darknet-doll/clown/3d-prints/wrist-splint-mount/concepts/r3-review.html

# splint trace bus r4: tulle sandwich

The trace bus printed as rigid elements ON tulle — fabric is the flex, so the stiff 68D “TPU for AMS” (or PLA) is the right material, and the AMS makes it multicolour. r3 (the all-TPU cutout) kept below for comparison. mm at 100% → at the 77.6% print scale.

rev r4 tulle r3 cutout tulle black white pink

dark field = bare tulle = all the flex. Bundle A now lands ON the patch tile (structure, not just looks). Patch tile: strap slots ×2, eyelets ×4 for a ribbon bow, die-mark diamond; housing straps down through the slots onto its belt loops. Tulle is trimmed at the outline and thumb opening after printing; the dashed edge binding is the printed trim guide.

r3: the same geometry as cutouts in a solid 2.72 plate. Printed 2026-10-15 in 68D — too stiff; needs true TPU 95A. Kept for comparison.

## numbers (100% → 77.6%)

splint footprint | 229.4 × 197.8 → 178.0 × 153.5
r4 element height | 0.4 base + tulle + 1.4 top ≈ 1.8
trace width | 3.0 → 2.3
pad Ø / punched centre | 5.2 / 2.1 → 4.0 / 1.6
patch tile | 53 × 44 → 41.1 × 34.1
patch strap slots (printed size) | 2 × (13 × 2.5)
patch eyelets Ø (printed) | 4 × 3.1
velcro channels take strap | ≤ 15.5 printed (ours: 11)

## print workflow (the reveal)

1. Slice elements only, flat. In Bambu Studio right-click the layer slider at layer 2 → Add Pause.
2. Print the 2 base layers; the printer parks.
3. Lay tulle over the whole plate, pull taut.
4. Pin it with small neodymium magnets to the steel plate, outside the print area, clear of the nozzle path.
5. Resume. The next layer welds through the mesh; remaining layers sandwich the fabric.
6. Cool, peel, trim tulle at the edge binding and inside the thumb opening and strap slots (sharp scissors or a hot knife seals polyester edges).

## supplies

- Tulle: plain polyester tulle, fine mesh, no glitter (glitter blocks the weld; too-fine organza doesn't bond). One bolt is a lifetime supply for this part (~200 × 180 mm per attempt). Amazon search: polyester tulle bolt 54" (https://www.amazon.com/s?k=polyester+tulle+fabric+bolt+54+inch)
- Magnets: neodymium discs, N35 or stronger, ~6×3 mm (the size the prior-art model below calls for), 10–14 pcs. Amazon search: neodymium disc magnets 6×3 mm (https://www.amazon.com/s?k=neodymium+disc+magnets+6mm+x+3mm)
- Already on hand: 68D TPU-for-AMS spool, 11 mm velcro strap, the X1C's magnetic steel plate.

## prior art (verified technique)

- Printables: “Hex pattern for tulle” (https://www.printables.com/model/357819-hex-pattern-for-tulle) — same recipe: pause at height, tulle pinned with 6×3 N35 magnets to a magnetic PEI plate, keep the fabric dead flat.
- Prusa forum: printing over tulle (https://forum.prusa3d.com/forum/original-prusa-i3-mk3s-mk3-how-do-i-print-this-printing-help/printing-over-tulle-fabric) — magnets outside the build area; mesh lets melt flow through and bond mechanically.
- 3DPrinterly: How to 3D print on fabric (8 steps) (https://3dprinterly.com/how-to-3d-print-on-fabric-8-steps/) — the general pause-and-lay workflow, taut fabric, few base layers.

## open before export

- 20-min test square first: traces + one loaded strap tab + a diamond on scrap tulle; yank the tab before trusting a spinning motor to it.
- Tulle bond with 68D TPU at its nozzle temp — prior art is mostly PLA; verify on the test square.
- Flip-for-left-hand check still applies (fabric side vs element side now differ — elements face OUT, tulle sits on skin).
