darknet-doll/clown/3d-prints/bubble-housing/concepts/v1-three-quarter.png

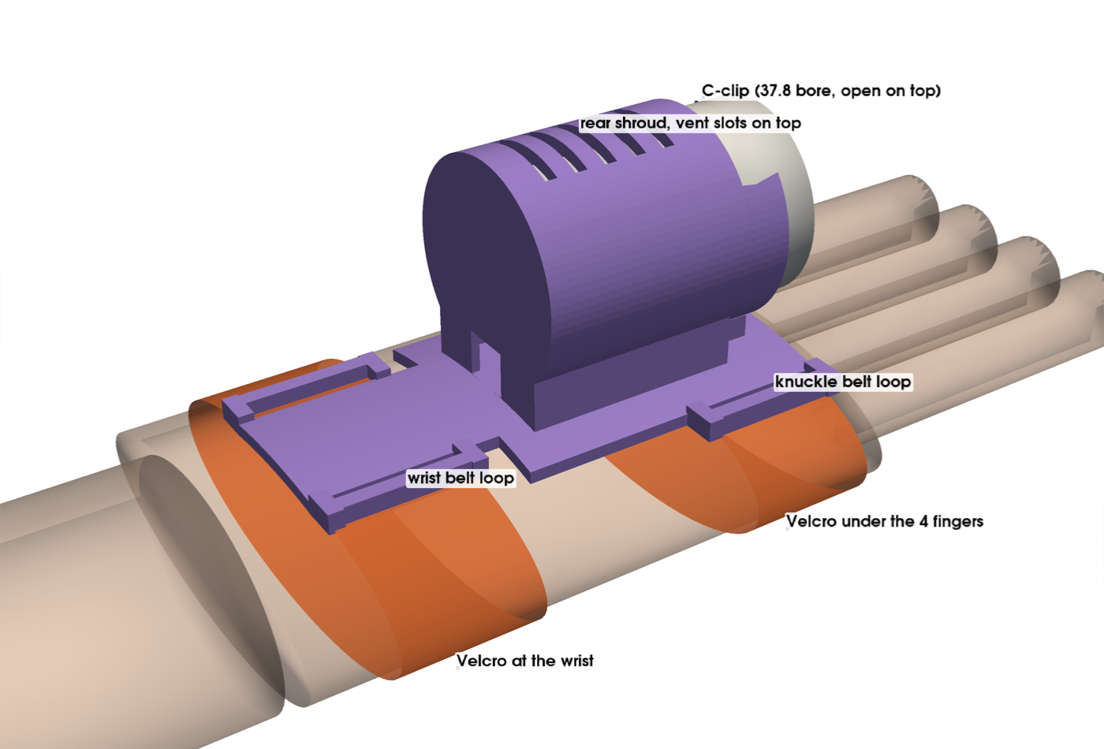
3d-prints/bubble-housing/concepts/v1-three-quarter.png
