darknet-doll/clown/3d-prints/bubble-housing/concepts/v2-side.png

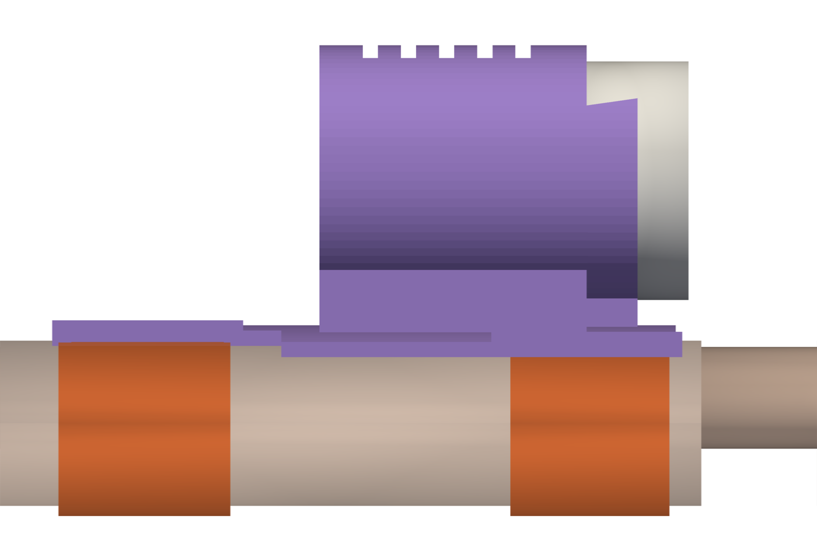
3d-prints/bubble-housing/concepts/v2-side.png
