darknet-doll/clown/3d-prints/bubble-housing/concepts/v3-top.png

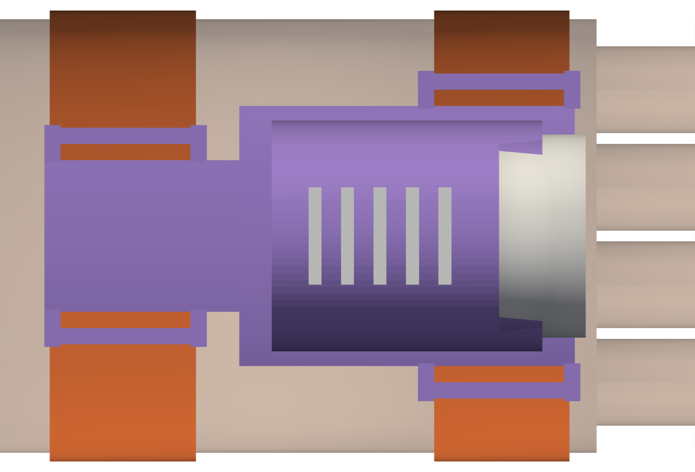
3d-prints/bubble-housing/concepts/v3-top.png
