darknet-doll/clown/3d-prints/bubble-housing/concepts/v4-from-fingers.png

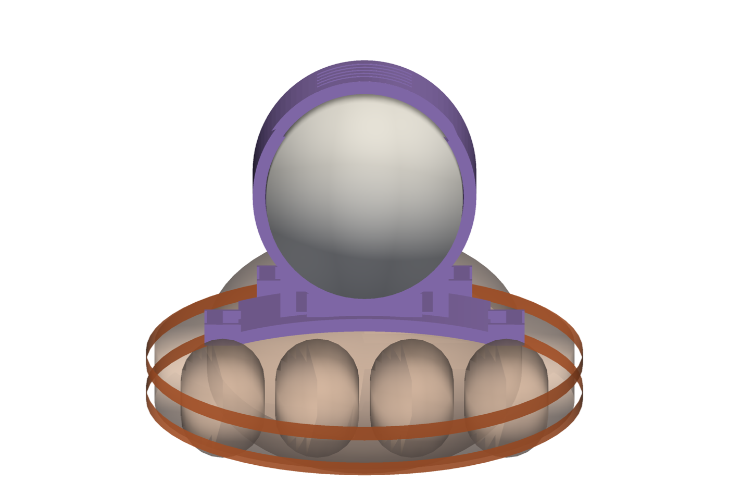
3d-prints/bubble-housing/concepts/v4-from-fingers.png
