darknet-doll/clown/3d-prints/bubble-housing/concepts/v5-rear.png

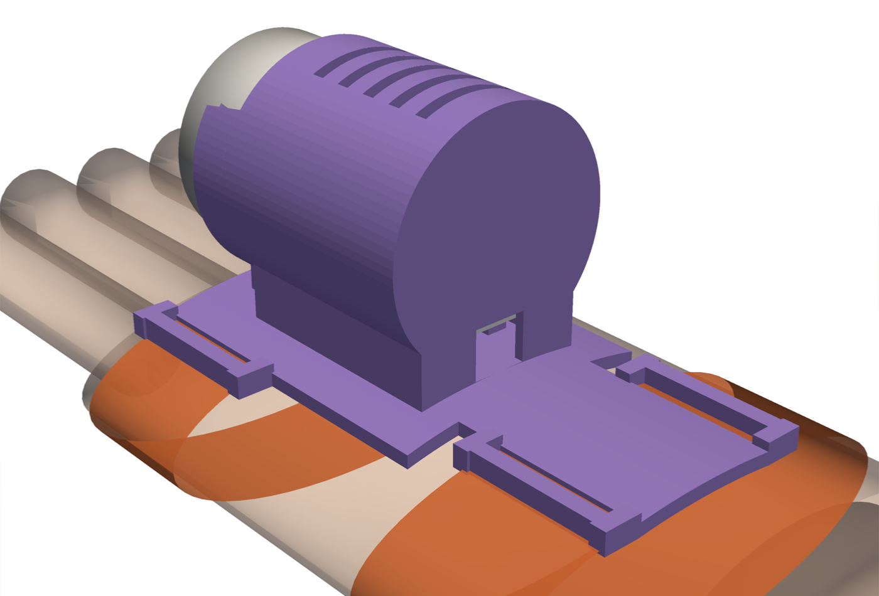
3d-prints/bubble-housing/concepts/v5-rear.png
