darknet-doll/clown/3d-prints/bubble-housing/concepts/w1-three-quarter.png

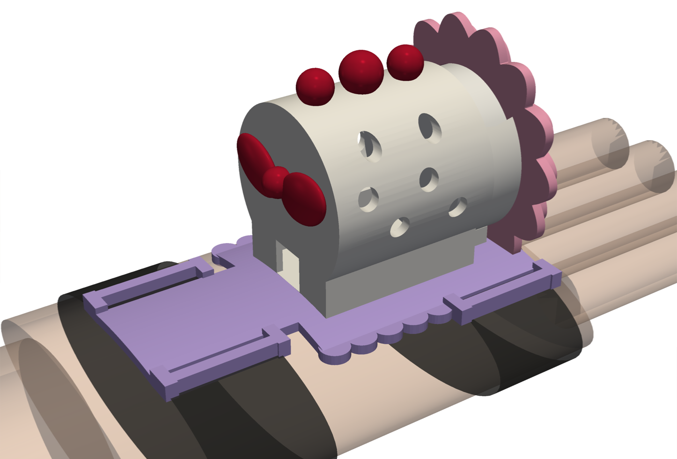
3d-prints/bubble-housing/concepts/w1-three-quarter.png
