darknet-doll/clown/3d-prints/bubble-housing/concepts/w2-front.png

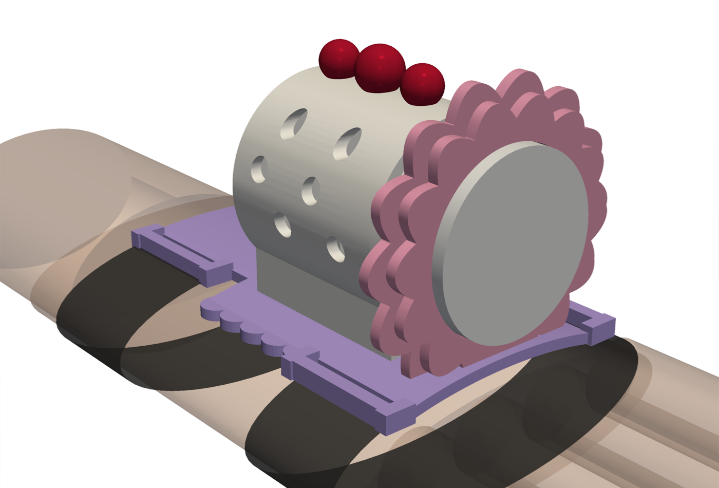
3d-prints/bubble-housing/concepts/w2-front.png
