darknet-doll/clown/3d-prints/bubble-housing/concepts/w3-rear.png

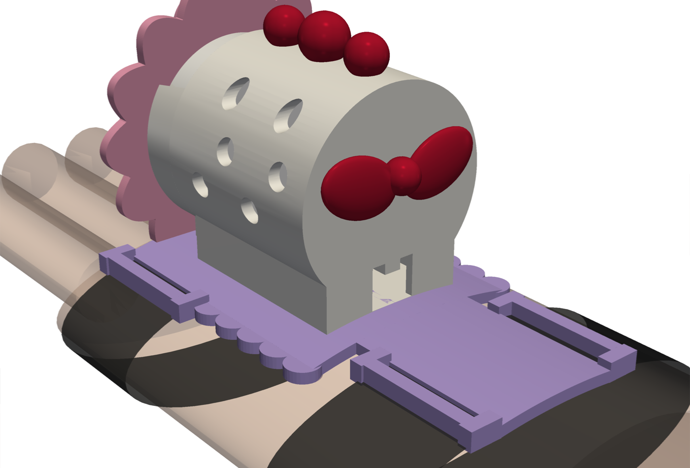
3d-prints/bubble-housing/concepts/w3-rear.png
