darknet-doll/clown/3d-prints/bubble-housing/concepts/w4-side.png

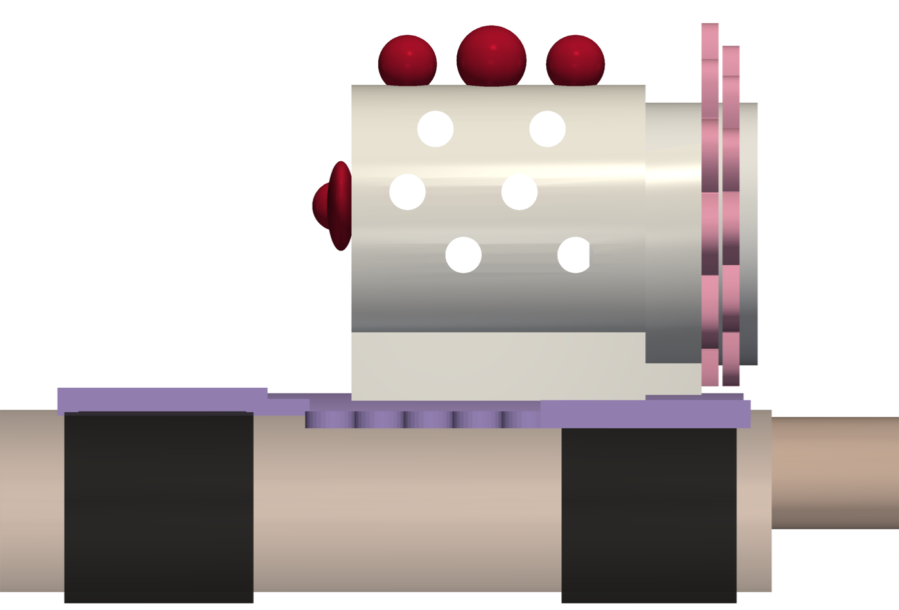
3d-prints/bubble-housing/concepts/w4-side.png
