darknet-doll/clown/3d-prints/cuff-ruffle/concepts/r1-from-wrist.png

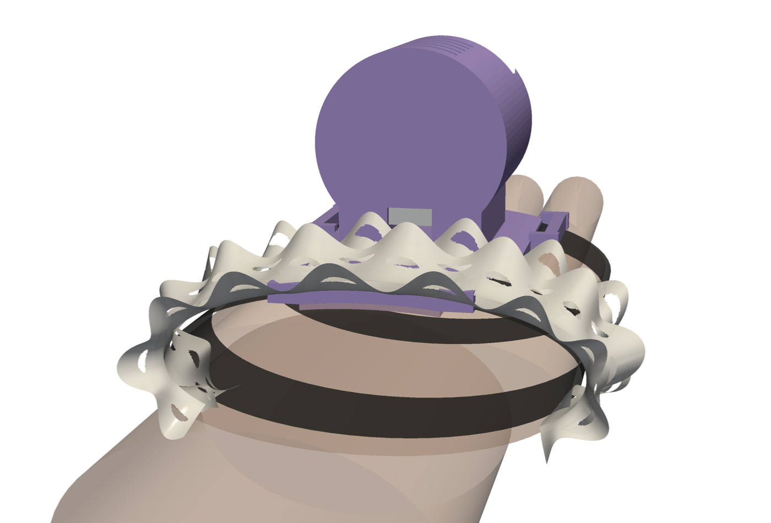
3d-prints/cuff-ruffle/concepts/r1-from-wrist.png
