darknet-doll/clown/3d-prints/cuff-ruffle/concepts/r1-side.png

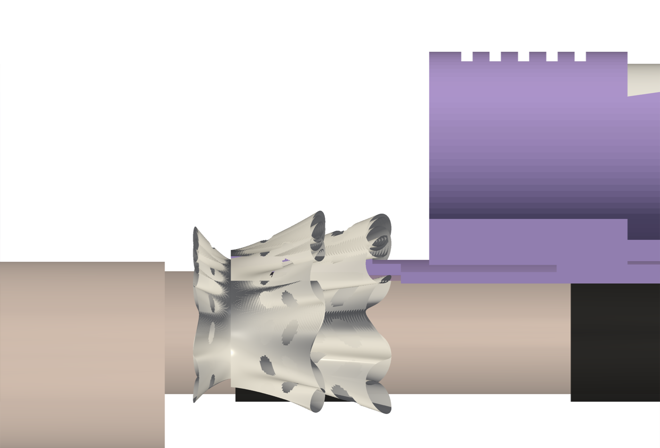
3d-prints/cuff-ruffle/concepts/r1-side.png
