darknet-doll/clown/3d-prints/cuff-ruffle/concepts/r1-three-quarter.png

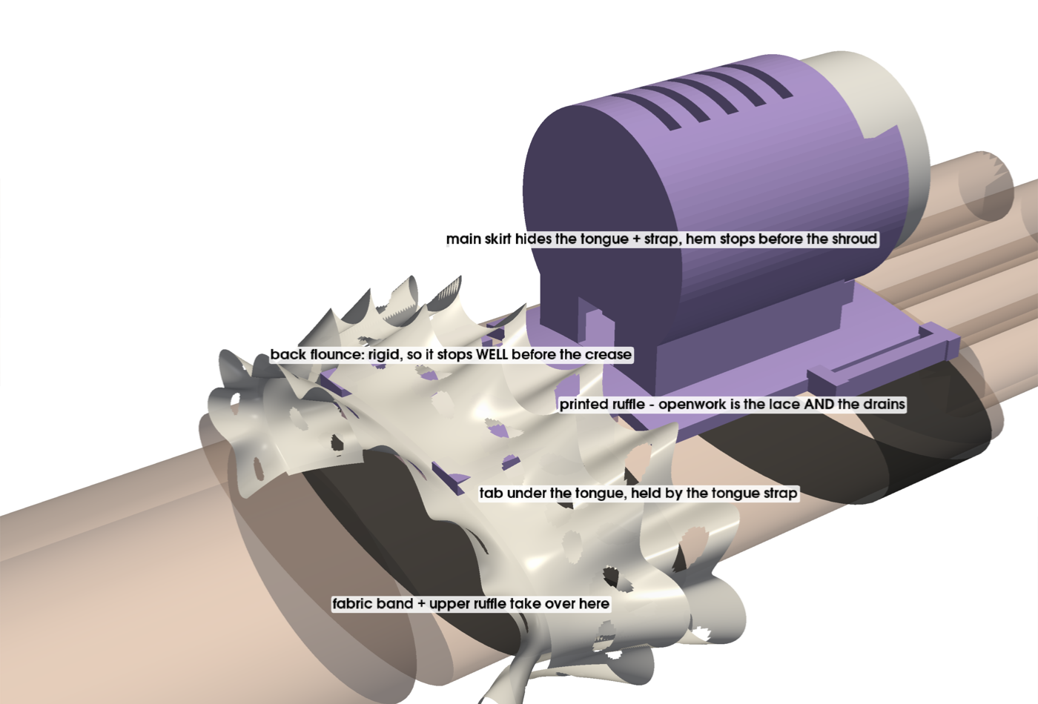
3d-prints/cuff-ruffle/concepts/r1-three-quarter.png
