darknet-doll/clown/3d-prints/cuff-ruffle/concepts/r2-side.png

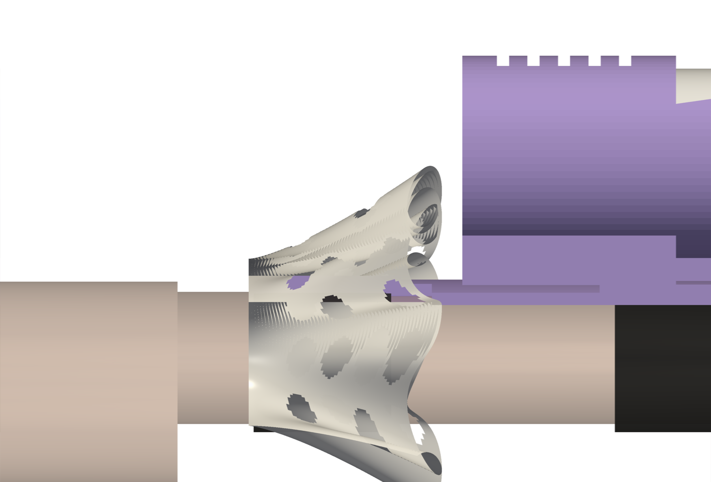
3d-prints/cuff-ruffle/concepts/r2-side.png
