darknet-doll/clown/3d-prints/cuff-ruffle/concepts/r2-three-quarter.png

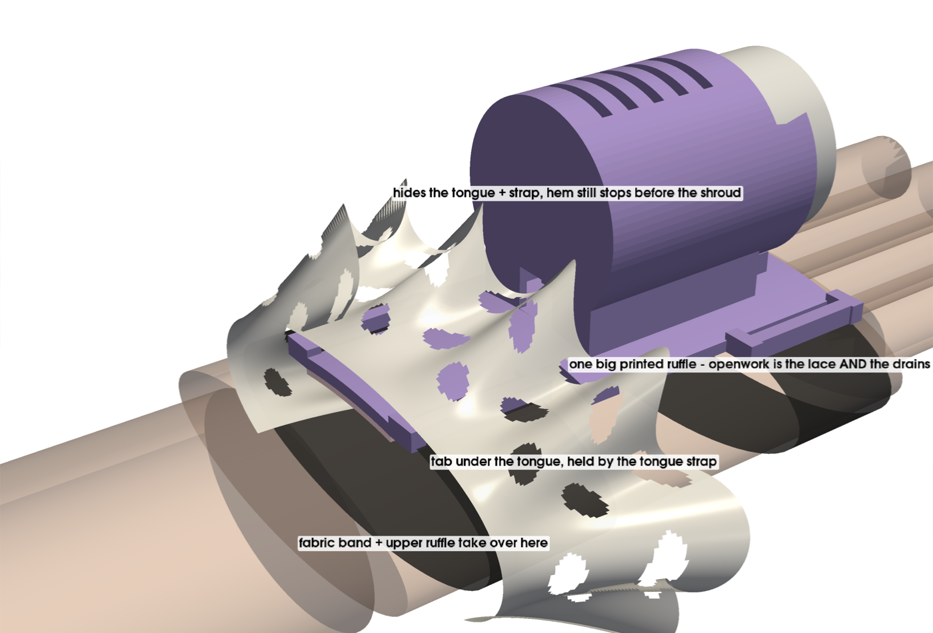
3d-prints/cuff-ruffle/concepts/r2-three-quarter.png
