darknet-doll/clown/3d-prints/wrist-splint-mount/concepts/openwork-swatches-r1.png

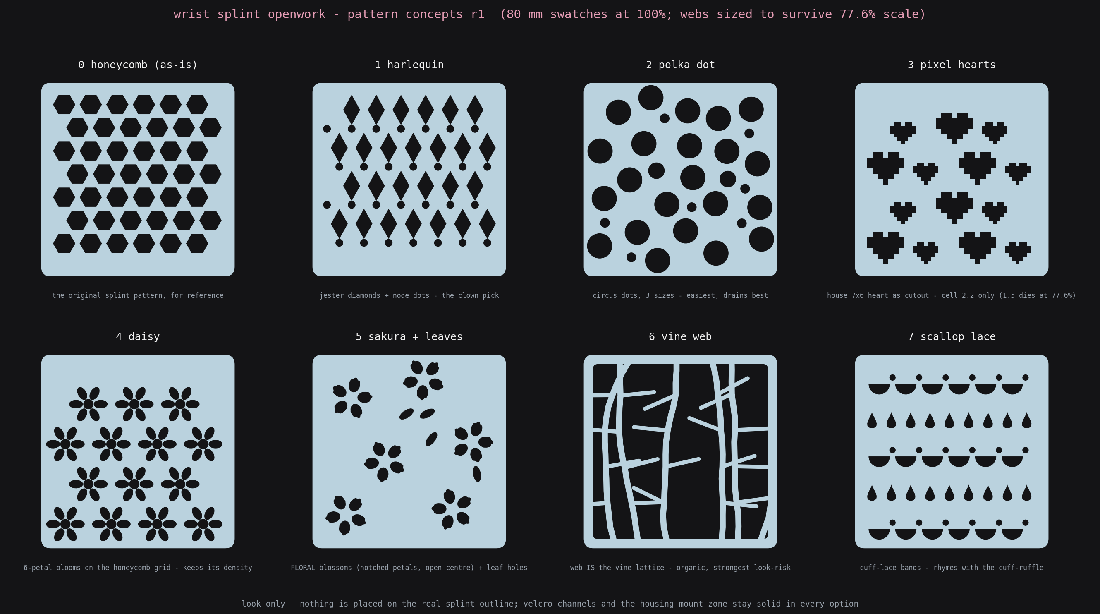
3d-prints/wrist-splint-mount/concepts/openwork-swatches-r1.png
