darknet-doll/clown/3d-prints/wrist-splint-mount/concepts/openwork-swatches-r2.png

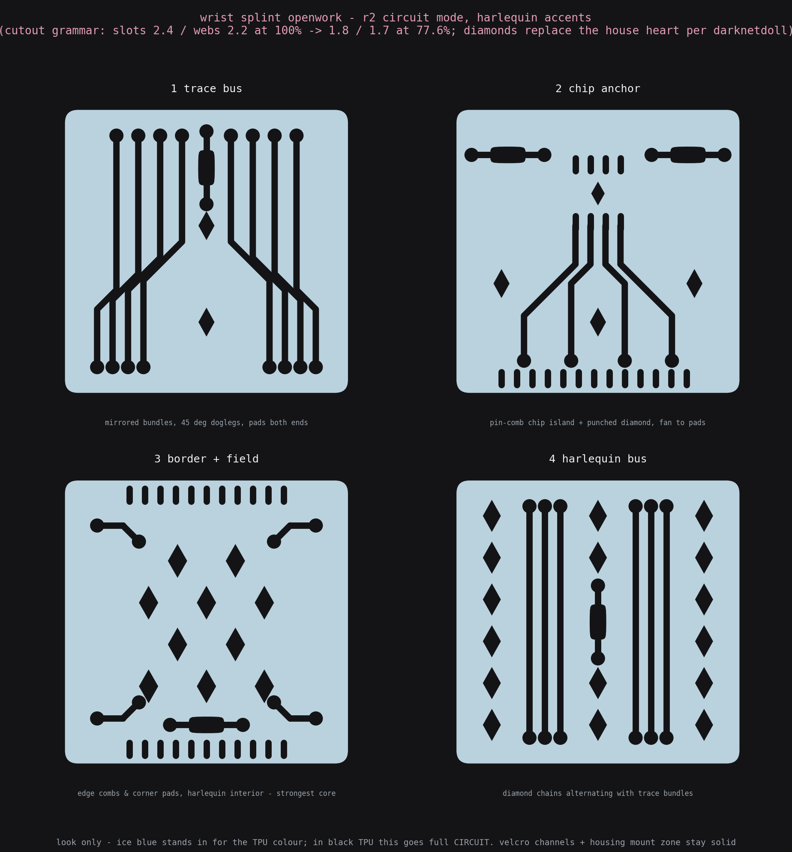
3d-prints/wrist-splint-mount/concepts/openwork-swatches-r2.png
