darknet-doll/clown/3d-prints/wrist-splint-mount/concepts/splint-plan.png

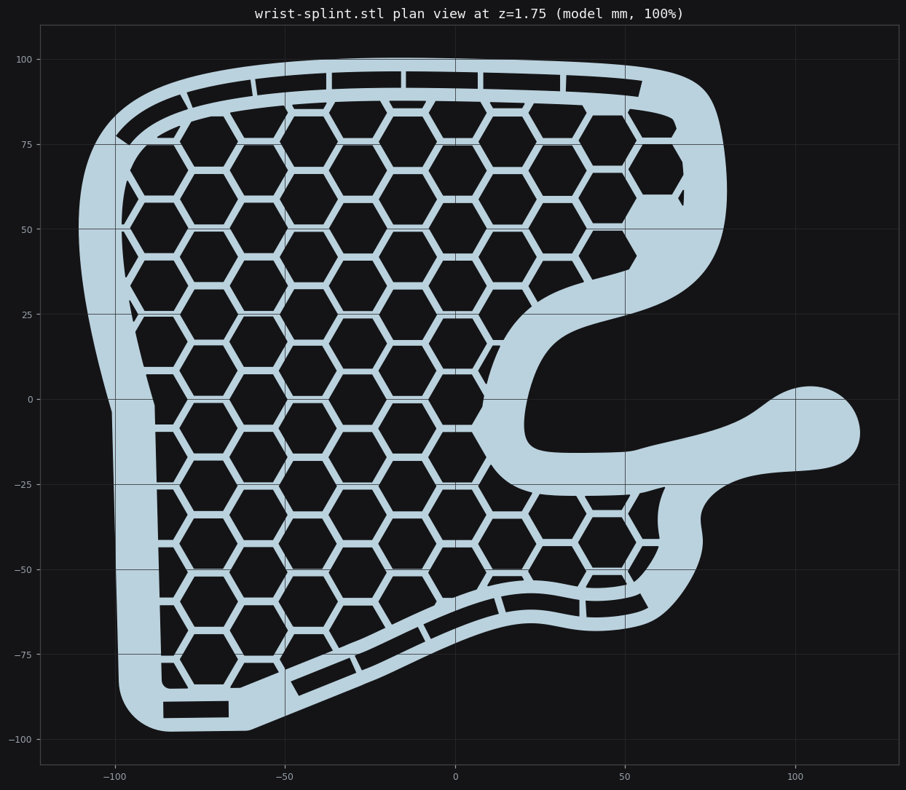
3d-prints/wrist-splint-mount/concepts/splint-plan.png
