darknet-doll/clown/3d-prints/wrist-splint-mount/concepts/trace-bus-r3.png

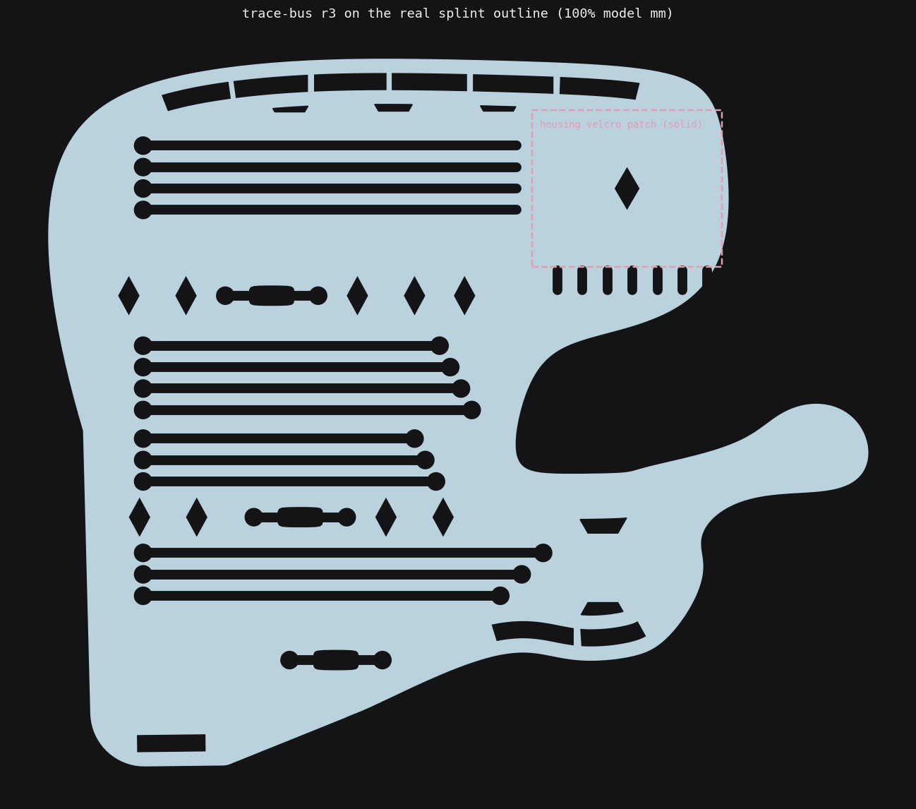
3d-prints/wrist-splint-mount/concepts/trace-bus-r3.png
