darknet-doll/clown/3d-prints/wrist-splint-mount/concepts/tulle-sandwich-r4.png

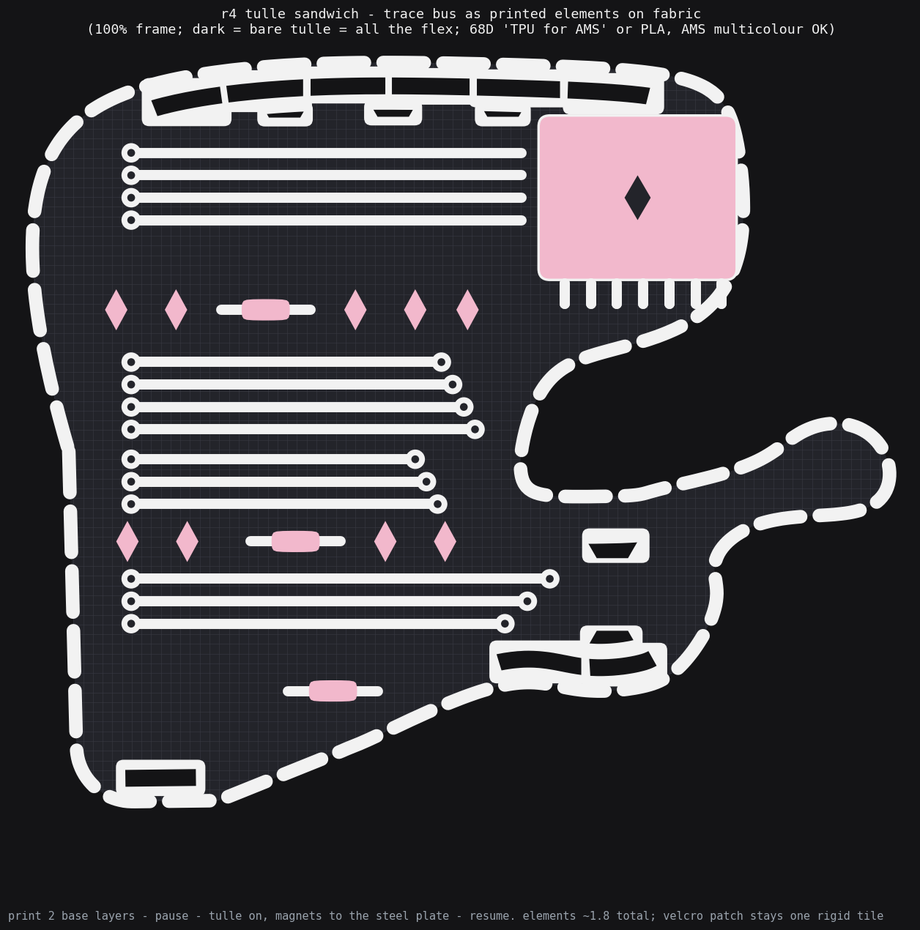
3d-prints/wrist-splint-mount/concepts/tulle-sandwich-r4.png
