darknet-doll/clown/docs/pcb/fab/clown-pod-bottom.png

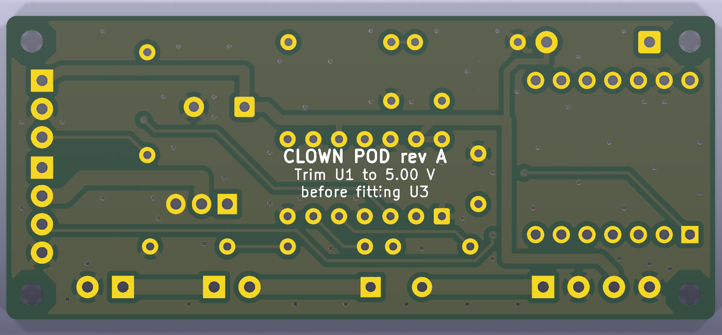
docs/pcb/fab/clown-pod-bottom.png
