darknet-doll/clown/firmware/trigger_test/xiao-pinout.png

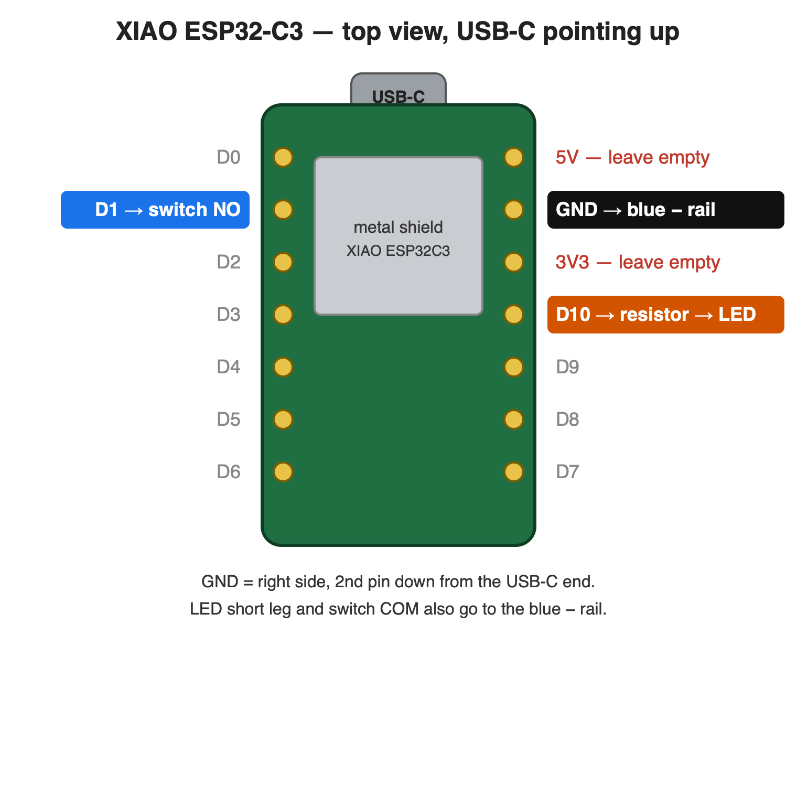
firmware/trigger_test/xiao-pinout.png
