darknet-doll/clown/PARTS.md

# Parts List

## How to read the quantities

Every part below carries **two numbers** and a **status**:

- **Per arm** — what one arm needs
- **Buy** — what to actually put in the basket for the whole costume
- **Status** — whether it's already on the shelf, deferred, or dropped;
  see [What's already on hand](#whats-already-on-hand)

They are different, and confusing them is the single easiest way to end up
halfway through a build with one glove. **The costume is two arms.** Tools are
marked `buy 1` because you only need one soldering iron, not one per arm.

Format for each part:

- **Is** — what the object actually is
- **Does** — its job in the circuit
- **Skip it →** the exact way it breaks

Read order if you're new:

1. This file — what the parts are
2. [BUILD.md](BUILD.md) — how they go together
3. [SCHEMATIC.md](SCHEMATIC.md) — the same circuit as a drawing, with every
   designator (`CR2`, `R5`, `SW1`…) this file refers to, and the
   [naming rules](SCHEMATIC.md#naming-rules) that keep those names unique
4. [README.md](README.md) — why the design is shaped this way

---

## About the buy links

Each part below has a **Suggested product** line pointing at a real Amazon listing.

- **What I checked:** the listing exists and its spec matches what this build needs
- **What I could not check:** price, current stock, and whether it ships to Bothell
  - Amazon serves automated requests a page with no price, stock or delivery data,
    and a delivery estimate needs a signed-in session with your address set
  - **Confirm all three in your cart before ordering.** Treat these as "this is the
    right part," not "this is in stock today"
- Where the part is a pure commodity and brand genuinely doesn't matter, the link is
  a search rather than one listing
- **The garment and fabric links are all searches, on purpose.** Listings for lace
  gloves and arm warmers churn constantly, and the thing that decides whether one
  works — how much light its fabric passes — is not visible in a listing photo. Buy
  one pair, test it lit, *then* buy the rest
- The bubble kit is **not on Amazon** — it comes from Bambu's own store

---

## What's already on hand

Counted 2026-09-23. The shopping list below carries the same status per row, so
you can shop from the table without re-reading this.

### On the shelf — do not re-buy

- **Bambu bubble maker kit ×2** — one per arm, so everything in the boxes is covered too
- **1000 µF 16 V electrolytic ×2**
- **100 kΩ resistor ×4** — two per arm, the battery monitor divider
- **330–470 Ω resistor ×2**
- **Small protoboard ×2**
- **Lever microswitch ×2** — *came in the kits*, one per kit
- **Protected 18650 ×2** — one per kit, already on its PH2.0 pigtail

**Where the shelf stock came from is not recorded.** The caps, resistors and
protoboard were already here. Everything with a traceable listing and an arrival date
is in the [shopping list](#shopping-list) — one table, so there is no second place to
keep in sync.

### Deciding later — the costume layer

- **Glove** — fingerless, pale, thin
- **Sleeve or arm warmer** — or one elbow-to-hand piece covering both
- **Diffuser layer** — also what backs the lace structurally
- **Satin ribbon** — thumb loops, the wrist placket, *and* the cable tacking either
  side of every plug ([BUILD.md](BUILD.md) step 10 — the connector is never the
  anchor). This one is strain relief, not decoration

None of these are electrical and none of them gate the build: the circuit can be
finished, sealed and bench-tested before any of them is chosen. Two things to carry
forward when you do decide:

- **Buy one, test it lit, then buy the rest.** How much light a fabric passes is the
  whole decision, and no listing photo tells you
- **Decide them together.** Glove, sleeve and diffuser share one fabric rule, and the
  sleeve choice decides whether the wrist plug stays reachable

### Dropped — and what that costs

- **Spare 18650 cells** — two arrive in the kits, no more being bought
  - **The cost:** a flat cell ends the performance. There is no swap
  - Charge both to full the morning of, and know your runtime from
    [BUILD.md](BUILD.md)'s bench test
- **18650 sled / holder with leads** — the kit's cell is already on a PH2.0 pigtail
  that mates to both the pod and the charger, so no sled sits in the path
  - **Keep the kit's PH2.0 lead on the cell.** That pigtail *is* the swap-and-charge
    path — cut it off and you need a soldering iron to change a battery
  - The sled section below stays as the fallback if a pigtail ever gets damaged
- **18650 transport case** — nothing loose to carry, because no spares
  - If that changes, the case comes back. A bare cell's whole can is the negative
    terminal and the shrink wrap is its only insulation

---

## Shopping list

Everything, in one table. Details and reasoning are in the sections below; the
buy links are the same ones repeated there, so you can shop straight from here.
**Price, stock and delivery are unverified — confirm in your cart.**

Status column: **have** = was on the shelf before this build, provenance not
recorded · **bought** = ordered for this build, with the listing and arrival date in
the last column · `later` = costume layer, deferred · ~~skip~~ = dropped on purpose,
reason in [What's already on hand](#whats-already-on-hand) · `buy` = still to order.
**Every `buy` row is what's actually left.**

**Received** is its own column: a date means it is physically here, **—** means it was
never ordered, and ⚠ means ordered but not arrived. The last column reads **Bought**
first — the listing actually ordered — then **Recommended** underneath, the
spec-matched suggestion this file made before anything was ordered. Where the two
differ, the difference is the thing to read.

| Part | Status | Per arm | **Buy** | Received | Bought / Recommended |
|---|---|---|---|---|---|
| Bambu Electric Bubble Maker Kit 01 | **have** | 1 | **0** — both on hand | **09-23** | **Bought:** [Bambu store](https://us.store.bambulab.com/products/electric-bubble-maker-kit-01) ×2<br>Recommended: the same, it is the only seller |
| Bottle, 24T or 30T neck | buy | 1 | **2** + a spare | — | Recommended: [search](https://www.amazon.com/s?k=24-410+30-410+plastic+bottle+with+cap) |
| Silicone tube, 3 × 5 mm | buy | — | **1 m** | — | Recommended: [search](https://www.amazon.com/s?k=silicone+tubing+3mm+ID+5mm+OD) |
| Bubble solution | **bought** | — | **0** — in hand | **09-29** | **Bought:** [32 oz concentrate](https://www.amazon.com/dp/B08XY8WP6B) — makes 2.5 gal diluted<br>Recommended: [search](https://www.amazon.com/s?k=bubble+solution+refill+gallon) |
| WS2812B strip, 60/m, 5V, IP65, black PCB | **bought** | 0.5 m | **0** — 5 m in hand | **09-29** | **Bought:** [WESIRI 5 m / 300 LED / IP67](https://www.amazon.com/dp/B07P7WWRVH) — 60/m ✓, IP67 ✓, **PCB colour unstated: check the roll**<br>Recommended: [Luopan, 1 m](https://www.amazon.com/WS2812B-pixels-WS2812-Decorative-Lighting/dp/B0CG5V735Q) |
| Glove — pale, thin, fingerless | later | 1 | **a pair** | — | Recommended: [sheer lace](https://www.amazon.com/s?k=white+lace+long+fingerless+gloves+arm+warmers) · [ribbon lace-up](https://www.amazon.com/s?k=lace+up+ribbon+knit+arm+warmers+fingerless+white) |
| Sleeve or arm warmer | later | 1 | **a pair** (one elbow-to-hand piece covers both) | — | Recommended: [search](https://www.amazon.com/s?k=long+white+lace+arm+warmers+fingerless) |
| Diffuser layer — white organza or tulle | later | — | **½ yd** | — | Recommended: [organza](https://www.amazon.com/s?k=white+organza+fabric+by+the+yard) · [tulle](https://www.amazon.com/s?k=white+tulle+fabric+bolt) · [channel](https://www.amazon.com/s?k=silicone+LED+diffuser+channel+10mm+flexible) |
| Satin ribbon, 6–10 mm | later | — | **1 roll** | — | Recommended: [search](https://www.amazon.com/s?k=white+satin+ribbon+6mm) |
| Seeed XIAO ESP32-C3 | **bought** | 1 | **0** — 4 in hand | **09-29** | **Bought:** [3-pack](https://www.amazon.com/dp/B0DGX3LSC7) **+** [1 pre-soldered](https://www.amazon.com/dp/B0DRNSV5CS) — pre-soldered one sits taller, check pod fit<br>Recommended: [Seeed 3-pack](https://www.amazon.com/XIAO-ESP32C3-3PCS-Pack-Bluetooth5-0/dp/B0DGX3LSC7) |
| 74AHCT125 level shifter | **bought** | 1 | **0** — 5 in hand | **10-02** | **Bought:** [Juried DIP-14 5-pack](https://www.amazon.com/dp/B08FHD994N) — 5 in hand, logged from the inventory check — **arrival date not recorded, 10-02 is the day it was counted**<br>Recommended: [the same DIP 5-pack](https://www.amazon.com/Juried-Engineering-SN74AHCT125N-SN74AHCT125-Breadboard-Friendly/dp/B08FHD994N) · [Adafruit](https://www.amazon.com/Adafruit-Accessories-Quad-Level-Shifter-piece/dp/B00XW2L39K) |
| MOSFET, bare RFP30N06LE | **bought** | 1 | **0** — 6 in hand | **09-29** | **Bought:** [Cylewet 6-pack](https://www.amazon.com/dp/B073D399M1) — bare parts, so **5 V gate drive is required** and `R4`/`R5` are not included<br>Recommended: the same listing |
| 1N5819 diode | **bought** | 2 | **0** — 150 in hand | **09-29** | **Bought:** [EEEEE 150-pack](https://www.amazon.com/dp/B0FC2CWKPL) — 1 A / 40 V<br>Recommended: [search](https://www.amazon.com/s?k=1N5819+schottky+diode) |
| Battery disconnect switch, 3 A DC | **bought** | 1 | **0** — 5-pack ordered | ⚠ **no** — ordered 10-08 | **Bought:** [DaierTek KCD1 round rocker, 20 mm, SPST, 5-pack](https://www.amazon.com/dp/B07S1MV462) — 12 VDC automotive, **confirm the DC amp rating printed on the body ≥ 3 A**; a rocker, **not booted** — seal the 20 mm snap-in hole with RTV and label which way is off<br>Recommended: [search booted SPST toggle](https://www.amazon.com/s?k=waterproof+toggle+switch+boot+SPST+12V) |
| Protected 18650 cell | **have** | 1 | **0** — 2 come in the kits | **09-23** | **Bought:** inside the [kits](https://us.store.bambulab.com/products/electric-bubble-maker-kit-01)<br>Recommended, only for spares: [search](https://www.amazon.com/s?k=protected+18650+battery+button+top) |
| 18650 sled with leads | ~~skip~~ | — | **0** — kit cell is on a pigtail | — | Recommended: [search](https://www.amazon.com/s?k=18650+battery+holder+single+slot+wire+leads) |
| 5V boost module | **bought** | 1 | **0** — 10 in hand | **09-29** | **Bought:** [Dorhea MT3608 10-pack](https://www.amazon.com/dp/B089JYBF25) — **trim to 5.0 V and meter it before any XIAO**<br>Recommended: [a different MT3608 10-pack](https://www.amazon.com/MT3608-Converter-Adjustable-Voltage-Regulator/dp/B0BGLGL9RV) — same chip |
| 2A polyfuse | **bought** | 1 | **0** — kit in hand | **09-29** | **Bought:** [GBX radial PPTC assortment, 50 pc](https://www.amazon.com/dp/B0F19BP842) — **no 2.0 A part exists in this family; fit GBX-185 (1.85 A) or GBX-250 (2.5 A)**<br>Recommended: [search](https://www.amazon.com/s?k=PPTC+resettable+fuse+2A+radial) |
| 18650 storage/transport case | ~~skip~~ | — | **0** — no spares to carry | — | Recommended: [search](https://www.amazon.com/s?k=18650+battery+storage+case+plastic) |
| 100 kΩ resistor | **have** | 2 | **0** — 4 on hand | on shelf | Already on the shelf — **not bought for this build, provenance not recorded**<br>Recommended, to re-buy: [resistor kit](https://www.amazon.com/s?k=metal+film+resistor+assortment+kit+1%2F4W) |
| 1000 µF capacitor | **have** | 1 | **0** — 2 on hand, plus 10 more in the 24-value electrolytic kit | on shelf | Already on the shelf — **not bought for this build, provenance not recorded**<br>Recommended, to re-buy: [search](https://www.amazon.com/s?k=1000uF+16V+electrolytic+capacitor) |
| 0.1 µF ceramic capacitor | **bought** | 1 | **0** — ordered, 30 in the kit | ⚠ **no** — due 10-03 | **Bought:** [BOJACK 300-pc ceramic kit](https://www.amazon.com/dp/B085RDTCCV) — 10 values, **0.1 µF (marked 104) ×30**; **not here yet**, and it gates the 74AHCT125 wiring<br>Recommended: [ceramic cap kit](https://www.amazon.com/s?k=ceramic+capacitor+assortment+kit+0.1uF+50V) · [0.1 µF 50-pack](https://www.amazon.com/s?k=0.1uF+100nF+50V+ceramic+capacitor+through+hole) |
| 330–470 Ω resistor | **have** | 1 | **0** — 2 on hand | on shelf | Already on the shelf — **not bought for this build, provenance not recorded**<br>Recommended, to re-buy: [same resistor kit](https://www.amazon.com/s?k=metal+film+resistor+assortment+kit+1%2F4W) |
| 100 Ω gate series (`R4`) + 10 kΩ gate pulldown (`R5`) | **have** | 1 each | **0** — 50 of each in the kit | on shelf | Already on hand in the **AUSTOR 1/4 W 1 % metal film kit** (50 pc each of 100 Ω and 10 kΩ; also 330 Ω, 470 Ω, 100 kΩ at 25 pc) — checked against the listing photo, **not bought for this build, provenance not recorded**<br>Recommended, to re-buy: [1/4W metal film resistor kit](https://www.amazon.com/s?k=metal+film+resistor+assortment+kit+1%2F4W) |
| Lever microswitch | **have** | 1 | **0** — 2 come in the kits | **09-23** | **Bought:** inside the [kits](https://us.store.bambulab.com/products/electric-bubble-maker-kit-01)<br>Recommended, only for spares: [Saim 10-pack](https://www.amazon.com/Saim-Momentary-Switch-Roller-Action/dp/B01NBK00FD) |
| JST-SM pigtail pair, 3-pin | buy | 3 | **6 + 2 spares** | — | Recommended: [search](https://www.amazon.com/s?k=JST+SM+3+pin+pigtail+pairs) — check the strip reel first, it may already carry some |
| JST-SM pigtail pair, 4-pin | buy | 2 | **4 + 2 spares** | — | Recommended: [search](https://www.amazon.com/s?k=JST+SM+4+pin+pigtail+pairs) |
| JST-SM pigtail pair, 5-pin | ~~skip~~ | — | **0** — design change: the wrist now crosses on SM-3 + SM-4 | — | Recommended, no longer needed: [BTF-LIGHTING, 10 pairs](https://www.amazon.com/BTF-LIGHTING-Pairs-Female-Connector-Flexible/dp/B01DC0KNY2) |
| JST-SM pigtail pair, 2-pin | buy | 1 | **2 + 2 spares** | — | Recommended: [VANDESAIL, 20 pairs](https://www.amazon.com/VANDESAIL-Connector-Adapter-Electrical-Female/dp/B0CQX8D3QR) |
| JST-ZH pigtail pair, 2-pin, 1.5 mm | buy | 1 | **2 + 2 spares** | — | Recommended: [XUGERIP, 20 pairs](https://www.amazon.com/XUGERIP-1-5mm-Male-Female-Connector/dp/B0D9SN5BTP) |
| Protoboard, small | **have** | 1 | **0** — 2 on hand | on shelf | Already on the shelf — **not bought for this build, provenance not recorded**<br>Recommended, to re-buy: [search](https://www.amazon.com/s?k=double+sided+perfboard+prototype+PCB+assorted) |
| Silicone hookup wire 22–26 AWG | **bought** | — | **0** — both gauges in hand | **09-29** | **Bought:** [Fermerry 22 AWG](https://www.amazon.com/dp/B089CQHRDT) **+** [SCHDRA 26 AWG](https://www.amazon.com/dp/B0C9MB4DTY)<br>Recommended: [search](https://www.amazon.com/s?k=silicone+wire+kit+22+24+26+AWG+stranded) — one kit; two were bought instead |
| Heat-shrink, assorted | buy | — | **one assortment covers both** | — | Recommended: [search](https://www.amazon.com/s?k=heat+shrink+tubing+assortment+kit) |
| Hot glue sticks or clear RTV silicone | **bought** | — | **0** — in hand | **09-29** | **Bought:** [Dynatex clear RTV, 85 g](https://www.amazon.com/dp/B003VW21C4)<br>Recommended: [search](https://www.amazon.com/s?k=clear+RTV+silicone+sealant+small+tube) |
| Dielectric grease | buy | — | **1 small tube** | — | Recommended: [search](https://www.amazon.com/s?k=dielectric+grease+small+tube) |
| Conformal coating spray, clear acrylic | buy | — | **1 can** | — | Recommended: [search](https://www.amazon.com/s?k=clear+acrylic+conformal+coating+spray+electronics) |
| Self-amalgamating silicone tape | buy | — | **1 roll** | — | Recommended: [search](https://www.amazon.com/s?k=self+amalgamating+silicone+tape) |
| Silicone O-ring cord, 2 mm, or closed-cell foam tape | buy | — | **1** | — | Recommended: [O-ring cord](https://www.amazon.com/s?k=silicone+o+ring+cord+2mm+solid) · [foam tape](https://www.amazon.com/s?k=closed+cell+foam+weatherstrip+tape+thin) |
| M3 heat-set inserts, 4.6 mm OD × 5.0 mm long + M3×8 mm button-head screws | buy | 4 + 4 | **1 kit** | — | Recommended: [inserts](https://www.amazon.com/s?k=M3+heat+set+threaded+inserts+brass+4.6mm+OD+5mm) · [screws](https://www.amazon.com/s?k=M3+x+8mm+button+head+screw+stainless+A2+ISO+7380) |
| Cable gland or rubber grommet, 4–6 mm | buy | 1 | **2 + spares** | — | Recommended: [search](https://www.amazon.com/s?k=small+rubber+grommet+assortment+kit) |
| PETG filament | buy | — | **1 spool** | — | Recommended: [search](https://www.amazon.com/s?k=PETG+filament+1.75mm) |
| Needle and thread, or fabric glue | buy | — | **1** | — | Recommended: [sewing kit](https://www.amazon.com/s?k=hand+sewing+kit+needles+thread+ballpoint) · [fabric glue](https://www.amazon.com/s?k=fabric+glue+permanent+washable) |
| Fabric marker pen | buy | — | **1** | — | Recommended: [search](https://www.amazon.com/s?k=washable+fabric+marker+pen+air+erasable) |
| USB-C cable, **data capable** | buy | — | **1** | — | Recommended: [search](https://www.amazon.com/s?k=USB+C+data+sync+cable) |
| Multimeter *(tool, not a part)* | **bought** | — | **0** — in hand | **09-29** | **Bought:** [INNOVA 3320](https://www.amazon.com/dp/B000EVYGZA) — meets the spec; **no capacitance range**, confirm the 10 A jack is fused<br>Recommended: [Neoteck](https://www.amazon.com/Neoteck-Multimeter-Multimeters-Resistance-Transistor/dp/B01NAVAT9S) · [Proster](https://www.amazon.com/Proster-PSTTL334-Multimeter-Temperature-Capacitance/dp/B0194VGLFS) · [Fluke 115](https://www.amazon.com/Fluke-115-Compact-True-RMS-Multimeter/dp/B000OCFFMW) |

### Where this stands — 2026-10-02

**Fourteen of the fifteen orders are here. One thing is still out:**

- **0.1 µF ceramic (`C2`)** — the BOJACK 300-pc kit, **due 10-03**. A small part, but it
  is the decoupling cap that sits across the 74AHCT125's pins 14 and 7. The 500-pc
  electrolytic kit already on hand is *not* a substitute

**The 74AHCT125 is in** (five of them, counted in the inventory check), and so is
everything else, so the next real step is trimming the boosts: set each MT3608 to
**5.0 V** on the trimpot and verify it on the 3320 **before any XIAO goes near it.** Out of
the bag they can be anything, and 12 V into a XIAO ends that board.

**Everything can be built now except the last wire on the 74AHCT125.** It is the LED
strip's data buffer *and* the 5 V gate drive the bought RFP30N06LE depends on — see
[the fix that costs nothing](#the-fix-that-costs-nothing) for why the spare gates are
load-bearing. Seat and wire it, but hold the strip and MOSFET bench test until `C2` is
across its pins: it works on the bench without it and misbehaves on the arm.

One open item, not an order:

- **One unidentified arrival**, logged only as "vuot" on 2026-09-29. Matches none of
  the fifteen orders

Tools, one of each: soldering iron, flux-core solder, flux pen, wire strippers,
side cutters, heat gun, multimeter, 3D printer. Thermal camera optional but very
useful — see [Tools](#tools). The multimeter has its own row above because it was
bought; the rest are not tracked here.

---

## The bubbles

### Bambu Lab Electric Bubble Maker Kit 01 (P6M) — 1 per arm · **on hand: 2**

- **Is:** blower head + one-way-valve bottle cap + silicone hose + gravity ball
- **Does:** draws solution up the hose and blows air across it → bubbles
- **You modify:** only the motor's connector
  - Kit ships the motor on a **PH2.0 female** plug, which mates straight to the cell
  - You cut that off and fit a **JST-SM 2-pin** instead, so the MOSFET sits in between
  - See [Connectors](#connectors) for why that swap is not optional
- **Also in the box, and you use all three:**
  - one protected 18650 cell, on a PH2.0 pigtail
  - a USB charger with a matching PH2.0 lead
  - a lever microswitch — the kit's own trigger, and the one this build uses
- **Not in the box:** the bottle. See below
- Two kits → two blower heads + two cells. One per arm
- **Suggested product:** not sold on Amazon —
  [Bambu Lab US store](https://us.store.bambulab.com/products/electric-bubble-maker-kit-01)

### How the kit actually works

Worth understanding before you design a mount, because it isn't what you'd guess:

- A **50 mm hose inside the bottle** ends in the blue **gravity ball**
  - the ball sinks, so the pickup finds solution at any arm angle, even inverted
  - this is why an arm-mounted bottle works at all
- A **50–70 mm hose outside the cap** feeds the blower head
  - so the **blower head is already a separate object from the bottle**, joined by tube
  - the bubbles form at the head, not at the cap
- **This is the key fact for mounting.** The heavy thing (bottle) and the thing that
  must point past your fingertips (head) do not have to be in the same place
- [BUILD.md](BUILD.md) step 7 has a twenty-minute test that decides your mount

### Bottle, 24T or 30T neck — 1 per arm · **buy 2 + a spare**

- **Is:** the solution reservoir the kit's cap screws onto
- **Not included in the kit.** Bambu says explicitly: do not use a drinking bottle
- **Pick deliberately** — this is your main lever on arm weight
  - full bottle + solution is the heaviest single item on the arm
  - a small bottle refilled often beats a big bottle carried all night
- Community CAD for the thread and blower sleeve exists on MakerWorld if you want
  to print a custom one
- **Suggested product:** measure your cap first, then
  [search 24/410 or 30/410 PET bottles](https://www.amazon.com/s?k=24-410+30-410+plastic+bottle+with+cap)
  — 24T/30T is the thread callout, and bottle listings usually say 24/410 or 30/410

### Silicone tube, 3 × 5 mm — **buy 1 m**

- **Is:** 3 mm inside, 5 mm outside — same as the hose in the kit
- **Does:** lets you extend the feed hose so the bottle can sit on your forearm
- Also a field spare. Stock aquarium/lab tubing, costs almost nothing
- Used in the step 7 mount test
- **Suggested product:**
  [search 3mm ID x 5mm OD silicone tubing](https://www.amazon.com/s?k=silicone+tubing+3mm+ID+5mm+OD)
  — any food-grade roll; you need about a metre

### Bubble solution — **buy as much as you can carry**

- This runs out long before the battery does. It is the actual limit on your night
- Buy it by the gallon, decant into the bottles, and carry a refill jug
- **Suggested product:** [search bubble solution refill gallon](https://www.amazon.com/s?k=bubble+solution+refill+gallon)
- **Bought:** [32 oz concentrate, refills to 2.5 gal](https://www.amazon.com/dp/B08XY8WP6B)

---

## The lights

### WS2812B LED strip, 60 LED/m, 5V, black PCB, IP65 — 0.5 m per arm · **buy a 1 m roll**

- **Is:** ribbon of lights, each with its own tiny chip inside
- **Does:** lets you set every light separately, down one single data wire
  - That's what "addressable" / "programmable" means
  - Normal strips = one colour all at once → no travelling comet possible

Why these exact specs:

- **60 LED/m** → 1.67 cm apart
  - dense enough to blur into a smooth streak under fabric
  - not visible dots
- **5V** → same supply as everything else
  - avoid 12V strips (WS2815) — needs a second power system
- **Black PCB** → invisible against dark fabric when off
- **IP65** (clear silicone sleeve) → waterproofing
  - you are spraying soapy water down your own arm

**Suggested product:**
[Luopan WS2812B, configurable](https://www.amazon.com/WS2812B-pixels-WS2812-Decorative-Lighting/dp/B0CG5V735Q)
— select **1 m / 60 LEDs / black PCB / IP65**. Read the option dropdown carefully;
this listing also sells 30 and 144 LED/m and IP30, which are the wrong parts.
Two arms take **54 pixels** (6 + 15 + 6 each), so a 1 m roll covers it with 6 to
spare.

**Bought:** [WESIRI 5 m / 300 LED / IP67](https://www.amazon.com/dp/B07P7WWRVH) — 60 LED/m
is right and IP67 beats IP65. **The listing does not state PCB colour**, so check the
roll: a white PCB shows through pale fabric when the strip is off. 5 m for 0.9 m of
need, so cut generously. The bundled mini controller is not used.

**Check the reel's ends for JST-SM 3-pin pairs.** That's the standard WS2812 strip
connector, and many reels ship with one already fitted at each end — free pigtails
toward the four SM-3 pairs this build needs.

**Alternative:** SK6812 RGBW

- drop-in swap
- adds a real white LED per pixel → better "charging up" glow
- slightly more forgiving on data timing
- costs a bit more

---

## The brain

### Seeed XIAO ESP32-C3 — 1 per arm · **bought: 4**

- **Is:** a whole computer, 21 × 17.5 mm
- **Does:** ~60×/second, decides
  - the colour of all 27 pixels
  - whether the motor runs
- **Watches:** the palm trigger on its own arm
- **Why this board:**
  - tiny → hides on your upper arm
  - takes 5V in directly
  - Wi-Fi + Bluetooth built in (unused in v1, free for later)
- **Reprogram:** USB-C cable — a **data** cable, not a charge-only one
  - **keep that port reachable** in the printed pod → see [BUILD.md](BUILD.md)
- **Suggested product:**
  [Seeed XIAO ESP32C3, 3-pack](https://www.amazon.com/XIAO-ESP32C3-3PCS-Pack-Bluetooth5-0/dp/B0DGX3LSC7)
  — two arms plus a spare, which you will want the first time you kill a pin
- **Bought:** that [3-pack](https://www.amazon.com/dp/B0DGX3LSC7) **and** a single
  [pre-soldered board](https://www.amazon.com/dp/B0DRNSV5CS) — **4 boards, 2 needed**
  - the pre-soldered one has headers already fitted, which adds height. **Check it
    fits the pod** before you plan an arm around it; the bare ones are the safer pick
    and the pre-soldered one makes a good bench-test board

### 74AHCT125 level shifter chip — 1 per arm · **bought**

- **Is:** a translator that also shouts
- **Problem it fixes:**
  - brain speaks at 3.3V
  - strip listens for 5V
  - strip *sort of* hears 3.3V — which is the trap
- **Does:** repeats the brain's 3.3V signal at a confident 5V
- **Skip it →** lights flicker, glitch, wrong colours, at random
  - worse with longer wire runs
  - fine on your bench, haunted at the party
  - #1 cause of "my LED strip is possessed"
- **Suggested product:**
  [Juried Engineering SN74AHCT125N, DIP-14, 5-pack](https://www.amazon.com/Juried-Engineering-SN74AHCT125N-SN74AHCT125-Breadboard-Friendly/dp/B08FHD994N)
  - or [Adafruit ADA1787, single](https://www.amazon.com/Adafruit-Accessories-Quad-Level-Shifter-piece/dp/B00XW2L39K)
    if you would rather buy the known-good one twice
- **You use one of its four gates for the strip.** Keep the chip in mind — the
  MOSFET section below has a use for a second gate
- **The two gates you don't use still need wiring.** They're CMOS inputs, and a
  floating CMOS input oscillates around its switching threshold — the chip then
  burns tens of milliamps as heat, off a battery you're wearing, and couples noise
  into the gates you do care about
  - `3A`, `4A` → **ground**
  - `3OE`, `4OE` → **Vcc**, which disables those outputs
  - `3Y`, `4Y` → **nothing**. Never tie an output to a rail
  - Four short wires. [BUILD.md](BUILD.md) step 4 has the pinout

---

## The motor control

### N-channel logic-level MOSFET — 1 per arm · **bought: RFP30N06LE ×6**

- **Is:** an electrical switch, no moving parts
- **Problem it fixes:** brain can decide, but can't push enough current to spin a motor
  - like asking someone to lift a car
- **Does:** brain flicks this switch → switch lets big current through from battery

#### Do not buy the obvious module

Search "MOSFET module Arduino" and the top result is almost always an **IRF520
driver module**. It is the wrong part and it will half-work, which is worse than
not working:

- IRF520 is **not logic-level** — its gate threshold runs as high as 4 V and it
  wants ~10 V to open fully
- Your XIAO drives the gate at **3.3 V**. The FET partly opens, dissipates the
  difference as heat, and the blower runs slow and inconsistently
- This is exactly the failure the old wording ("non-logic-level → only half-opens,
  gets hot") warned about — and the default purchase walks straight into it

#### Gate voltage is the real constraint

Even genuine logic-level parts are usually specified at **Vgs = 5 V**, not 3.3 V:

| Part | Rated on at | At 3.3 V gate |
|---|---|---|
| IRF520 | ~10 V | **barely on. Don't.** |
| IRLZ44N | 5 V | marginal — works, runs warmer than it should |
| RFP30N06LE | 5 V | marginal, same story |
| AO3400 | **2.5 V** | fully on. Correct for direct 3.3 V drive |

#### The fix that costs nothing

**Drive the gate from 5 V using a spare gate on the 74AHCT125 you already have.**

- The level shifter has **four** gates and the strip uses one
- Route `GPIO4` through a second gate, exactly as you route the LED data through the first
- The MOSFET then sees a clean 5 V gate signal, and IRLZ44N or RFP30N06LE become
  fully-on parts instead of marginal ones
- No new components, no extra cost. See [BUILD.md](BUILD.md) step 4

**Suggested product**, pick one path:

- **Direct 3.3 V drive** — get an **AO3400**-based module and check the listing
  actually names AO3400, not IRF520
- **5 V gate drive** (recommended) —
  [Cylewet RFP30N06LE logic-level TO-220, 6-pack](https://www.amazon.com/dp/B073D399M1).
  Bare transistors, so add a **100 Ω** gate series resistor and a **10 kΩ**
  gate-to-source pulldown — both come from the resistor kit below

- **This is what was bought.** So the 5 V gate-drive path above is the build, not an
  option: at 3.3 V the RFP30N06LE is the marginal part in that table. And because
  they are bare transistors, **`R4` and `R5` are on you** — both are in the resistor kit
  already on hand. See the [shopping list](#shopping-list)

#### The 10 kΩ gate pulldown, whichever part you buy

- **Problem it fixes:** between reset and the first line of firmware, the gate pin
  is an input and floats. A floating gate holds its last charge, and the blower
  twitches — or runs — at every power-up and every reflash
- **Does:** ties the gate to source, so "no signal" unambiguously means "off"
- **Bare transistor →** it is not included. Fit one
- **Module →** *check*. Most of the cheap modules do not have one. Meter it
  gate-to-source with the board unpowered: a few kΩ means it's there, open means
  add your own
- **Skip it →** the blower kicks every time you plug in USB, and nothing in the
  code is doing it

> Note this supersedes the older "buy a module, not a bare chip" advice. That was
> sound in principle, but the modules actually on sale are the wrong transistor.

### 1N5819 diode — **2 per arm** · **buy 4** (get 10)

Two jobs, same part, and they are easy to confuse — one is `CR1`, one is `CR2`.

> They are `CR`, not `D`, on purpose: the XIAO's silkscreen already has pins
> called `D1` and `D2`, and one of those pins drives the very MOSFET `CR1`
> protects. See the [naming rules](SCHEMATIC.md#naming-rules).

#### `CR1` — flyback, across the motor

- **Is:** a one-way valve for electricity
- **Problem it fixes:** a motor is a big coil
  - cut power to a coil → it kicks back a high-voltage spike into your circuit
- **Does:** gives that spike a safe loop to run around until it dies out
- **Skip it →** MOSFET eventually dies, maybe takes the brain with it
- Goes at the **blower end**, banded end (cathode) to motor **+**
- Costs ~20¢. Fit it

#### `CR2` — USB isolation, between the boost and the XIAO

- **Is:** the same one-way valve, doing a different job
- **Problem it fixes:** the XIAO's `5V` pad is wired straight to its USB-C VBUS,
  with nothing in between
  - plug in a USB cable while the pack is connected and your boost converter is
    now feeding the laptop
  - a host port pushing back into a boost output is not a fight either of them is
    designed for
- **Does:** lets the boost feed the XIAO and nothing feed back out of it
- **Fit:** banded end (cathode) toward the **XIAO**
- **Costs ~0.3 V**, so the XIAO sees ~4.7 V — well inside its regulator. The strip
  and the level shifter stay on the boost output directly, at a full 5 V
- **Skip it →** works fine right up until the night you reflash with the cell in
- **Suggested product:** [search 1N5819 Schottky diodes](https://www.amazon.com/s?k=1N5819+schottky+diode)
- **Bought:** [EEEEE 1N5819, 150-pack](https://www.amazon.com/dp/B0FC2CWKPL) — 1 A / 40 V
  — any bag of 10 or more; they're pennies each, and you need two per arm

---

## Power

### Protected 18650 battery — 1 per arm · **on hand: 2, in the kits** · no spares

- **Is:** rechargeable cell, same kind as in a laptop pack or a vape
- One comes free with each bubble kit, already on a **PH2.0 pigtail**
- **Keep that pigtail.** It's how the cell plugs into both the pod and the charger
- **"Protected" =** tiny guardian circuit in the end of the cell
  - cuts off if drained too far or charged too hard
  - over-drained lithium can be damaged or genuinely unsafe
- Cells in the bubble kit are protected ones
- **Do not substitute unprotected cells** to save money
  - this is strapped to your arm
- **On hand:** the two that arrived in the kits. **No spares are being bought**
  - so a flat cell ends the performance — there is no swap
  - charge both to full the morning of, and know the runtime from
    [BUILD.md](BUILD.md)'s bench test
- **Suggested product**, if you change your mind on spares:
  [search protected 18650 button-top cells](https://www.amazon.com/s?k=protected+18650+battery+button+top)
  — the listing must say **protected**; most cheap 18650s are not

### 18650 battery sled / holder with wire leads — **skipped** · fallback only

- **Not being bought.** The kit's cell already arrives on a **PH2.0 pigtail** that
  mates to both the pod and the charger, so nothing in the path needs a sled
- **Keep that pigtail on the cell.** It *is* the swap-and-charge path — cut it off
  and changing a battery needs a soldering iron
- **Is:** the slot the cell sits in
- **Does:** lets you swap a flat cell for a fresh one, no soldering iron
- **Kept here as the fallback** — if a pigtail tears or a lead pulls out of its
  crimp, this is the part that gets you running again
- Print an enclosure with a lid that clicks shut
  - you don't want it ejecting mid-performance
- **Suggested product**, if you ever need one:
  [search single-slot 18650 holder with wire leads](https://www.amazon.com/s?k=18650+battery+holder+single+slot+wire+leads)

### 5V boost converter module — 1 per arm · **buy 2**

- **Is:** a pump, but for voltage
- **Problem it fixes:** cell makes ~3.7V, brain + LEDs need 5V
- **Does:** pumps 3.7V up to a steady 5V
- **Only feeds lights + brain (~0.3 A)**
  - motor runs straight off the battery instead
  - so a small cheap module is genuinely fine here
- **Suggested product:**
  [Dorhea MT3608 step-up, 10-pack](https://www.amazon.com/MT3608-Converter-Adjustable-Voltage-Regulator/dp/B0BGLGL9RV)
  — **it is adjustable, so set it to 5.0 V with the trimpot and verify on the meter
  before you connect the XIAO.** Out of the bag it can be anything
- **Bought:** [Dorhea MT3608, 10-pack](https://www.amazon.com/dp/B089JYBF25) — same
  chip, different seller. The trim-and-meter step still applies

### 2A resettable fuse (polyfuse / PPTC) — 1 per arm · **buy 2** (get 5)

- **Is:** a safety valve that resets itself
- **Does:** on a current spike, suddenly becomes very resistant → chokes the flow
  - before anything catches fire
- Let it cool → back to normal by itself
- Cheap insurance for a lithium cell worn against your body
- **Suggested product:** [search 2A PPTC resettable fuse](https://www.amazon.com/s?k=PPTC+resettable+fuse+2A+radial)
- **Bought, in hand:** [GBX radial PPTC assortment, 50 pc](https://www.amazon.com/dp/B0F19BP842)
  — **there is no 2.0 A part in it.** Values run GBX-020 through GBX-250, so fit
  **GBX-185** (1.85 A hold) or **GBX-250** (2.5 A). The pod draws ~0.3 A plus the
  motor, so 1.85 A is the tighter, safer choice

### Battery disconnect switch — 1 per arm · **bought: 5-pack, ⚠ not arrived**

- **Is:** an ordinary SPST switch, in the cell's positive lead, ahead of the fuse
- **Does:** kills the whole arm in one motion, through the costume, one-handed
- **Why it's here:** this is a lithium cell strapped to your arm inside a sealed
  box. "Unplug it" should not mean "open the pod first"
- **Spec that actually matters:** **rated 3 A or more at DC.** Small rockers and
  toggles are usually specced for mains AC and far less for DC — read the DC line
- **It does not replace pulling the cell.** It makes the pod safe to open and the
  arm safe to unplug; the cell still comes out for storage and charging
- **Bought:** [DaierTek KCD1 round rocker, 20 mm, SPST 2-pin, 5-pack](https://www.amazon.com/dp/B07S1MV462)
  — ordered 10-08. Marketed as 12 VDC automotive; the KCD1 family is typically
  specced ~10 A at 12 VDC, but **read the rating printed on the switch body when
  it arrives and confirm ≥ 3 A DC** before it goes in the cell lead
- **It is a rocker, not the booted toggle the spec asked for.** Two consequences:
  - **No boot, no self-seal** — it snaps into a **20 mm round hole**; seal the
    flange to the pod wall with the RTV already on hand
  - **Flush rockers read poorly by feel** — label which way is off, or print a
    guard ridge beside the ON side, so "did I turn it off?" has an answer in
    the dark
- Recommended before the buy:
  [search booted SPST toggle switch](https://www.amazon.com/s?k=waterproof+toggle+switch+boot+SPST+12V)
  — kept here in case a booted toggle replaces the rocker later

### 18650 storage case — **skipped** · no spare cells to carry

- **Not being bought** — no spare cells, so nothing loose to carry
- **It comes straight back the day you buy a spare.** The rest of this section is
  why, and applies to any cell that ever travels outside the pod
- **Is:** a hard plastic box with a slot per cell
- **Does:** stops a spare cell shorting against keys, coins, or another cell
- A bare 18650's entire can is the negative terminal. The shrink wrap is the only
  insulation it has, and a nick in that wrap is how a cell in a bag goes wrong
- **Check the wrap on every cell before every event.** Re-wrap or bin any that are
  torn
- **Suggested product**, if spares happen:
  [search 18650 storage case](https://www.amazon.com/s?k=18650+battery+storage+case+plastic)

### Two 100 kΩ resistors (battery monitor) — 2 per arm · **on hand: 4**

- **Is:** two resistors forming a "divider"
- **Problem it fixes:**
  - brain can only safely measure up to ~3.3V
  - full cell is 4.2V
- **Does:** shrinks battery voltage neatly in half → safe to read
- **Gets you:** two things, both in firmware
  - a **warning** — slow red pulse at the elbow at 3.4 V, with hysteresis so it
    doesn't strobe on and off as the motor loads the cell
  - a **shutoff** — at a sustained 3.0 V the arm cuts the motor and stops firing,
    so the cell's own protection board never has to save it. Double blink, not a
    single pulse, so you can tell them apart across a room
- **On hand: 4.** Nothing to buy
- **Suggested product**, to re-buy — an assortment, not singles —
  [search 1/4W metal film resistor kit](https://www.amazon.com/s?k=metal+film+resistor+assortment+kit+1%2F4W)
  — one kit covers the 100 kΩ pair, the 330–470 Ω data resistor, and the 100 Ω / 10 kΩ
  the MOSFET gate wants

---

## Signal conditioning

### 1000 µF electrolytic capacitor — 1 per arm · **on hand: 2**

- **Is:** a tiny water tank for electricity
- **Problem it fixes:** many LEDs switching on at once all gulp power at the same instant
- **Does:** holds a reserve, smooths the gulp → voltage doesn't dip and confuse the brain
- **Watch out:** polarised
  - one leg marked negative → must go to ground
  - backwards, electrolytics pop
- **On hand: 2, 16 V.** Nothing to buy
- **Suggested product**, to re-buy:
  [search 1000uF 16V electrolytic capacitors](https://www.amazon.com/s?k=1000uF+16V+electrolytic+capacitor)
  — 10 V would technically do, but 16 V or 25 V costs the same

### 0.1 µF ceramic capacitor — 1 per arm · **ordered: 30 in a kit, due 10-03**

- **Is:** a very small, very fast water tank, bolted to the thirsty part itself
- **Problem it fixes:** the 74AHCT125 gulps current in nanoseconds every time it
  switches a gate
  - the 1000 µF is metres of wire away, electrically speaking, and can't answer that fast
  - so the chip's own 5 V pin dips on every edge it drives
- **Does:** sits across `Vcc` and `GND` **at the chip**, holding just enough charge
  for one switching edge
- **Watch out:** it only works if it's *at the pins*
  - legs cut short, straddling pin 14 and pin 7
  - on long legs it's mostly wire, and does much less than you think
- **Not polarised** — either way round, unlike the 1000 µF
- **Skip it →** works on the bench, misbehaves on the arm: stray wrong pixels, a
  blower that stutters when the strip changes brightness. Intermittent, and it will
  not reproduce on your desk
- **The electrolytic kit on hand is not a substitute.** Its 0.1 µF is an aluminium
  electrolytic — polarised, and too slow at the nanosecond edges this cap exists for.
  Wait for the ceramic kit
- **Not the same part as `C1`.** Fit both — bulk at the strip, decoupling at the chip
- **Bought:** [BOJACK 300-pc ceramic kit](https://www.amazon.com/dp/B085RDTCCV) — 0.1 µF
  (marked **104**) ×30 plus nine other values. **Not here yet**, due 10-03
- **Suggested product:**
  [ceramic capacitor assortment kit](https://www.amazon.com/s?k=ceramic+capacitor+assortment+kit+0.1uF+50V)
  — pennies, and you will want the other values eventually. A
  [plain 0.1 µF 50 V pack](https://www.amazon.com/s?k=0.1uF+100nF+50V+ceramic+capacitor+through+hole)
  does the job if you'd rather not have the box. Marked **104** on the body

### 330–470 Ω resistor — 1 per arm · **on hand: 2**

- **On hand: 2.** Nothing to buy
- **Is:** a speed bump on the data wire
- **Does:** softens the signal's sharp edge
  - so it doesn't bounce back down the wire and garble the message to the first LED
- **Skip it →** the *first* pixel misbehaves — wrong colour or flickering
  - every pixel behind it stays fine
- **Suggested product:** same [1/4W metal film resistor kit](https://www.amazon.com/s?k=metal+film+resistor+assortment+kit+1%2F4W)
  as the battery-monitor pair — one kit covers every resistor in this build

---

## The trigger

### Snap-action microswitch, lever type — 1 per arm · **on hand: 2, in the kits**

- **Already on hand: one per kit, two total.** Nothing to buy
- **Check which lever yours has before you build the mount** — see the roller note
  at the end of this section
- **Is:** clicky button with a small metal arm sticking off it
- **One per hand.** Each hand fires its own arm — nothing crosses the torso
- **The arm is the point:**
  - wide press area
  - squeeze fingers into your palm mid-performance and hit it every time
  - **no looking, no aiming**
  - a plain round button = hunting for a 12 mm target by feel
- **Bonus:** crisp physical click → you feel that it fired
- **Wiring is the same whatever the body looks like:** use **COM** and **NO**;
  ignore the NC terminal
- **Whatever plug the kit's switch arrives on, the trigger lead ends up on
  JST-ZH 2-pin.** If it ships on PH2.0, that rework is not optional — a PH-2 trigger
  lead mates with the PH-2 battery lead and puts 3.7 V on GPIO3. See
  [Connectors](#connectors)
- **Suggested product**, only if you break both or want spares:
  [Saim long hinge lever microswitch, 10-pack](https://www.amazon.com/Saim-Momentary-Switch-Roller-Action/dp/B01NBK00FD)
- **Prefer the plain lever over the roller version.** A roller is a hard point that
  presses into your palm for hours. If the only listing you can get has rollers, the
  roller pops off most of these

---

## Connectors

The costume comes apart into **four modules per arm**, so you can get out of it
alone, with soapy hands, without turning into a pretzel. Nothing is soldered end
to end across a joint.

| Module | Holds | Unplugs at |
|---|---|---|
| **Pod** (upper arm) | brain, boost, shifter, MOSFET, fuse, disconnect, cell cradle, upper-arm strip 6 px | `SW1` + battery plug + straps |
| **Sleeve** (forearm) | forearm strip, 15 px | elbow, SM 4-pin + SM 3-pin |
| **Glove** (hand) | hand strip 6 px, trigger | wrist, SM 3-pin + SM 4-pin |
| **Bubbler** | bottle, cap, hose, blower head | hand, SM 2-pin + its strap |

### The connectors themselves

| Boundary | buy | Carries | Connector | Per arm · **buy** |
|---|---|---|---|---|
| Cell ↔ pod, cell ↔ charger | buy | 2 | **JST-PH 2.0, 2-pin** *(already on the cell)* | — |
| Pod → upper-arm strip | buy | strip 3 | **JST-SM 3-pin** | 3 · **6 + 2** |
| Strip across the **elbow** | buy | strip 3 | **JST-SM 3-pin** | *(same bag as above)* |
| Pod → sleeve, at the **elbow** | buy | motor 2 + trigger 2 | **JST-SM 4-pin** | 2 · **4 + 2** |
| Strip across the **wrist** | buy | strip 3 | **JST-SM 3-pin** | *(same bag as above)* |
| Motor + trigger across the **wrist** | buy | motor 2 + trigger 2 | **JST-SM 4-pin** | *(same bag as above)* |
| Motor ↔ bubbler, at the **hand** | buy | motor 2 | **JST-SM 2-pin** | 1 · **2 + 2** |
| Microswitch pigtail | buy | switch 2 | **JST-ZH 1.5 mm, 2-pin** | 1 · **2 + 2** |

**The trigger and the motor both have to reach the pod from the hand**, so they
cross *both* joints on one shared 4-pin lead — same pinout at the elbow and the
wrist, the sleeve just passes it through — while the strip crosses each joint on
its own 3-pin.

- Buy them as **pre-wired pigtail pairs**. No crimp tool, no housings to assemble
- All of them latch. None of them is friction-only

**Suggested products:**

| Need | Listing |
|---|---|
| SM 3-pin | [search JST-SM 3-pin pigtail pairs](https://www.amazon.com/s?k=JST+SM+3+pin+pigtail+pairs) — check the strip reel first |
| SM 4-pin | [search JST-SM 4-pin pigtail pairs](https://www.amazon.com/s?k=JST+SM+4+pin+pigtail+pairs) |
| SM 2-pin | [VANDESAIL 2-pin JST-SM, 20 pairs](https://www.amazon.com/VANDESAIL-Connector-Adapter-Electrical-Female/dp/B0CQX8D3QR) |
| ZH 2-pin, 1.5 mm | [XUGERIP JST-ZH 1.5 mm 2-pin, 20 pairs](https://www.amazon.com/XUGERIP-1-5mm-Male-Female-Connector/dp/B0D9SN5BTP) |

- These are sold in bulk packs because that's how they come. You'll use the spares
- **Check the ZH listing says 1.5 mm.** ZH, SH and PH all get called "JST micro" by
  sellers, and the whole point of this part is that it cannot mate with PH

### Why these specific ones

- **JST-SM** is the LED-strip inline connector. It has a real clicking latch, it's
  sold as male/female pigtail pairs by the bag, and it's flat enough to hide under
  a cuff (~20 × 7 × 5 mm)
- The **wrist crosses on two plugs**: the strip's 3 conductors on an SM-3, the
  motor + trigger on an SM-4 — two pulls and the glove is off
- The **strip starts at the pod**, on a **3-pin** — 5V, GND, data, nothing else —
  and crosses the elbow and the wrist on two more **3-pins**, all in the same pin
  order: no continuous strip across a flexing joint
- The **elbow 4-pin carries the motor and the trigger** — a 4-conductor lead from the
  pod down the upper arm. The motor is deliberately not bundled with the strip data:
  ~1 A of PWM alongside a WS2812 data wire is asking for trouble. At both joints
  it rides with the trigger instead, and it meets the bubbler's own 2-pin at the
  hand. Twist the motor pair anyway
- The **cell keeps its factory PH2.0**. That's what the kit's charger mates to, so
  a flat cell goes pod → charger with no adapter and no rework. PH2.0 is rated 2 A
  and your peak is about 1.3 A — and the kit already runs the blower's own
  0.5–1.0 A through that same connector

### The rule that prevents the expensive mistake

> **No two connectors on one arm may share both family and pin count.**

- Check it against the table: PH-2 · ZH-2 · SM-2 · SM-3 (×3) · SM-4 (×2)
- The three 2-pin plugs are **different families** — PH is 2.0 mm pitch, ZH is 1.5 mm,
  SM is 2.5 mm. None of them will mate with either of the others
- **The deliberate exceptions, both safe *by construction*:** the three SM-3 strip
  plugs (pod, elbow, wrist) are identical — same strip nets, same pin order — so a
  cross-mate just skips a strip segment; nothing is damaged. Likewise the two SM-4
  motor-and-trigger plugs (elbow, wrist) carry the same four nets in the same pin
  order, so a cross-mate skips the sleeve pass-through and nothing else. Nothing
  else in the build has that property
- **This is why the trigger pigtail is ZH and not PH.** Plug a PH-2 trigger lead
  into the PH-2 battery lead and you put 3.7 V straight onto GPIO3 — dead pin, very
  possibly dead XIAO
- **This is also why you rework the kit's motor plug off PH2.0.** Leave it and the
  cell mates directly to the motor, bypassing the MOSFET entirely

### Three rules that come with connectors

- **Battery out before you mate or unmate anything.** Feeding data into an
  unpowered WS2812 pushes current through its input protection diodes, which is the
  classic way to kill pixel 0. Unplugging the cell first makes this a habit rather
  than a chore
- **The connector is never the anchor.** Tack the cable to the garment on *both*
  sides of every plug, so a snag pulls the tack, not the latch
- **Service loop either side of every plug.** Same reasoning as the wrist umbilical

### Dielectric grease — **buy 1 small tube**

- **Is:** non-conductive waterproof goo
- **Does:** a smear in each connector shell keeps soap residue from corroding the
  contacts over a season
- Cheap, and the alternative is intermittent faults you'll chase for hours
- **Suggested product:** [search dielectric grease](https://www.amazon.com/s?k=dielectric+grease+small+tube)

---

## Wire and materials

### Silicone-insulated hookup wire, 22–26 AWG — **one assortment covers both arms**

- **Is:** wire with soft rubbery insulation, not stiff plastic
- **Does:** bends thousands of times without the copper snapping
- **Use:**
  - 22 AWG (thicker) → power
  - 26 AWG (thinner) → data + trigger
- **Wrong wire →** works loose and breaks at elbow and wrist within hours of wear
  - solid-core is the worst offender
- **Suggested product:**
  [search silicone stranded wire kit 22-26 AWG](https://www.amazon.com/s?k=silicone+wire+kit+22+24+26+AWG+stranded)
  — a multi-colour spool set; colour-coding pays for itself at the connectors
- **Bought, as two kits covering both gauges:**
  [Fermerry 22 AWG, 6 colours × 10 ft](https://www.amazon.com/dp/B089CQHRDT) for power
  and the motor run, and
  [SCHDRA 26 AWG, 6 colours × 20 ft](https://www.amazon.com/dp/B0C9MB4DTY) for data and
  trigger. Both silicone, stranded, tinned copper

### Heat-shrink tubing, assorted — **one assortment covers both arms**

- **Is:** plastic sleeve that shrinks tight when heated
- **Does:** seals and insulates each solder joint
- **Slide it on *before* you solder** — everyone forgets exactly once
- **Suggested product:** [search heat shrink tubing assortment](https://www.amazon.com/s?k=heat+shrink+tubing+assortment+kit)

### Hot glue or clear RTV silicone — **buy 1**

- **Does:** seals the cut ends of the strip against soap
- Used in [BUILD.md](BUILD.md) step 3. Easy to forget when ordering, annoying to lack
- **Suggested product:** [search clear RTV silicone](https://www.amazon.com/s?k=clear+RTV+silicone+sealant+small+tube)
- **Bought:** [Dynatex clear RTV, 85 g](https://www.amazon.com/dp/B003VW21C4)
  — or any hot glue gun you already own

### Protoboard, small — 1 per arm · **on hand: 2**

- **On hand: 2.** Nothing to buy
- **Is:** the perforated board the pod's components sit on
- Nothing exotic. A 4 × 6 cm piece per arm is plenty
- **Suggested product**, to re-buy: [search double-sided perfboard assortment](https://www.amazon.com/s?k=double+sided+perfboard+prototype+PCB+assorted)

### A light-coloured, thin, fingerless glove — 1 per arm · **deciding later**

- **Deciding later.** Doesn't gate the build — the circuit finishes without it
- **Does:** hides the strip, spreads light into a soft even glow instead of dots
- **Fabric matters a lot:**
  - thin / white / pale / stretchy → glows beautifully
  - thick / dark / leather → swallows the light almost entirely
- **Fingerless is required**, not a style choice — the fingers have to curl freely
  into the palm to work the trigger, and the strip stops at the knuckles anyway
- **Want a thumb hole.** Without one the glove rotates and rides up, which walks the
  6-pixel hand segment off the back of your hand and the microswitch lever off your
  middle and ring finger pads. If the pair you like has no thumb hole, sew a thumb
  loop from the ribbon below, or anchor the glove to the printed trigger plate
- **Buy one pair to test before you buy the rest.** Fabric is the single most
  build-critical thing you cannot judge from a listing photo — hold a powered strip
  section under the actual garment, in a dark room, before committing
- **Suggested products** — two styles worth testing:
  - [search white lace fingerless long gloves / arm warmers](https://www.amazon.com/s?k=white+lace+long+fingerless+gloves+arm+warmers)
    — sheer floral lace, thumb hole, one fabric the whole length
  - [search ribbon lace-up knit fingerless arm warmers](https://www.amazon.com/s?k=lace+up+ribbon+knit+arm+warmers+fingerless+white)
    — ribbon-laced; if the lacing genuinely opens the tube it gives you access to the
    wrist connector, which neither plain style does
- Full detail → glove section in [BUILD.md](BUILD.md)
- **If you're building the lace concept, read [DESIGN.md](DESIGN.md) first.** Lace is
  pale but it is *not* a diffuser — it's open mesh, and it overrides this guidance

### Sleeve or arm warmer — 1 per arm · **deciding later**

- **Does:** same job as the glove, for the forearm segment
- Same fabric rules apply. Buy it at the same time as the glove and test both together
- **A single elbow-to-hand arm warmer covers both** — that's the usual form for the
  lace look. It's one less seam and one fabric instead of two, but it closes the
  wrist: the wrist plugs end up inside a sealed tube where you can't reach them to
  unmate. Either cut it at the wrist into two garments, or sew a short ribbon-laced
  placket over the plug, or accept three modules per arm instead of four
- **Suggested product:** [search long white lace arm warmers](https://www.amazon.com/s?k=long+white+lace+arm+warmers+fingerless)

### Diffuser layer — white organza or tulle — **deciding later** · ½ yd when you do

- **Does:** the soft glow the strip needs and lace does not provide — a scattering
  layer between the strip and the lace, with the lace pattern silhouetted on top
- Also **backs the lace structurally**. Fine mesh won't carry strip and wires on its
  own; a sewn channel in bare lace will pull and tear
- And it **hides the hardware** — wires, service loop, hose, the wrist plug bodies — all
  of which are plainly visible through sheer lace
- Open question in [DESIGN.md](DESIGN.md): diffuse, or leave the strip line visible.
  Buying ½ yd costs little and lets you test both
- **Suggested products:**
  - [search white organza fabric by the yard](https://www.amazon.com/s?k=white+organza+fabric+by+the+yard)
  - [search white tulle fabric bolt](https://www.amazon.com/s?k=white+tulle+fabric+bolt)
  - or a [silicone LED diffuser channel](https://www.amazon.com/s?k=silicone+LED+diffuser+channel+10mm+flexible)
    for a harder, more even diffusion — heavier and less drapey, better on the forearm
    than over the knuckles

### Satin ribbon, 6–10 mm — **deciding later** · 1 roll when you do

- **Does:** thumb loops, the laced placket over the wrist connector, and tacking
  cable to the garment on both sides of every plug ([BUILD.md](BUILD.md) step 10 —
  the connector is never the anchor)
- Black or white both work; the concept board uses both
- **Suggested product:** [search white satin ribbon 6mm](https://www.amazon.com/s?k=white+satin+ribbon+6mm)

### Needle and thread, or fabric glue — **buy 1**

- For sewing the strip channels into the glove and sleeve
- A channel, not glue-down-flat — see [BUILD.md](BUILD.md) step 10
- On stretch knit or lace, use a **ballpoint needle and a stretch stitch** — a sharp
  needle and a straight stitch will cut the mesh and pop the seam on the first pull-on
- **Suggested products:**
  [search hand sewing kit with needles and thread](https://www.amazon.com/s?k=hand+sewing+kit+needles+thread+ballpoint) ·
  [search permanent fabric glue](https://www.amazon.com/s?k=fabric+glue+permanent+washable)

### Fabric marker pen — **buy 1**

- For marking the trigger position on your palm in step 1
- Get a **washable / air-erasable** one — it's going on your skin and on white lace
- **Suggested product:** [search washable fabric marker pen](https://www.amazon.com/s?k=washable+fabric+marker+pen+air+erasable)

---

## Sealing and enclosures

Step 11 of [BUILD.md](BUILD.md) is the reasoning: arms go up at a rave, so nothing
on this costume is reliably "above the spray". These are what that step needs.

None of it is exotic and all of it is cheap. Buying it now saves a second order
halfway through the build.

### Conformal coating, clear acrylic spray — **buy 1 can**

- **Is:** a thin lacquer that seals a finished board against moisture
- **Does:** turns a soaked pod into one you rinse, dry and keep using
- **Mask first:** USB-C port, boost trimpot, MOSFET tab, connector housings,
  microswitch. Two thin coats, not one thick one
- **Do it after the bench test passes.** Reworking a coated board is miserable
- **Suggested product:**
  [search clear acrylic conformal coating](https://www.amazon.com/s?k=clear+acrylic+conformal+coating+spray+electronics)

### Self-amalgamating silicone tape — **buy 1 roll**

- **Is:** silicone tape with no adhesive — it fuses to *itself* under tension
- **Does:** one wrap over each mated connector keeps soap out of the shell
- Comes off in one piece and leaves no residue, which is exactly what you want on
  something you unplug every night
- **Suggested product:** [search self-amalgamating silicone tape](https://www.amazon.com/s?k=self+amalgamating+silicone+tape)

### Silicone O-ring cord, 2 mm — **buy 1 length**, or closed-cell foam tape

- **Is:** solid silicone cord that sits in a groove in the printed lid
- **Does:** the actual seal between pod and lid
- Foam weatherstrip tape works too and needs no groove modelled; it just doesn't
  last as many open/close cycles
- **Nothing sticky and permanent** — you will be opening this
- **Suggested products:** [O-ring cord](https://www.amazon.com/s?k=silicone+o+ring+cord+2mm+solid) ·
  [closed-cell foam tape](https://www.amazon.com/s?k=closed+cell+foam+weatherstrip+tape+thin)

### M3 heat-set inserts and screws — **buy 1 kit**

- **Does:** lets the pod lid be screwed shut and reopened without stripping plastic
- Four of each per pod, so eight of each for two arms. A gasket only seals if
  something squeezes it evenly

**Exact sizes — these four numbers are the whole spec:**

| | Size |
|---|---|
| Insert | M3 × 0.5, brass, **4.6 mm OD × 5.0 mm long** (sold as *M3 × D4.6 × L5.0*) |
| Screw | **M3 × 0.5 × 8 mm**, button head (ISO 7380), **A2 stainless** |
| Printed boss hole | **4.0 mm diameter × 6.0 mm deep** |
| Lid clearance hole | **3.4 mm**, on a flat ≥ 6.5 mm across |

- **Why 4.0 mm for a 4.6 mm insert:** the 0.6 mm difference is the plastic the
  brass melts into. Print the hole at the nominal size and let the insert do the
  work — do not "help" by reaming it out
- **Why 6.0 mm deep for a 5.0 mm insert:** the extra millimetre is somewhere for
  displaced plastic and the screw tip to go, so neither bottoms out
- **Leave ≥ 2 mm of plastic all round the boss** — a boss ≥ 8.5 mm outside
  diameter. Less than that and the melt-in splits the wall
- **Screw length rule if your lid isn't 3 mm:** *lid thickness + 5 mm*. An 8 mm
  screw through a 3 mm lid lands 5 mm of thread in a 5 mm insert, which is all of it
- **Stainless, not the black ones in the kit.** Kit screws are usually plain
  carbon steel and will bloom rust on a wet costume in one season
- **Setting them:** soldering iron at **240 °C** for PETG, insert square, press
  until the top sits **flush to 0.2 mm below** the surface. Press slowly and keep
  the iron square — rushing it drives the insert in crooked, and crooked is what
  makes a gasket leak at one corner
- Assorted kits are fine as long as they contain the **M3 × 4.6 × 5.0** size —
  many sell M3 in 3.0, 4.0 and 5.0 mm lengths in one box
- **Suggested products:** [M3 heat-set inserts](https://www.amazon.com/s?k=M3+heat+set+threaded+inserts+brass+4.6mm+OD+5mm) ·
  [M3×8 button-head stainless screws](https://www.amazon.com/s?k=M3+x+8mm+button+head+screw+stainless+A2+ISO+7380)

### Rubber grommets or a small cable gland — 1 per arm · **buy 2 + spares**

- **Does:** wires leave the pod through this, not through a bare printed hole
- A printed edge cuts silicone insulation over a season of movement, and the gap
  around it is the main way water gets in
- Fit it on the **underside**, and leave a drip loop below it — see step 11
- **Suggested product:** [search rubber grommet assortment](https://www.amazon.com/s?k=small+rubber+grommet+assortment+kit)

### PETG filament — **buy 1 spool**

- **Does:** pod, lid, cell cradle, trigger plate, bubbler mount
- **Not PLA:** PLA softens in a hot car and is brittle exactly where a strapped-on
  part flexes. PETG is tougher and its layer lines seal better
- Four perimeters, 1.6 mm walls minimum. Thin FDM walls leak through the layer
  lines themselves, gasket or no gasket
- **Suggested product:** [search PETG filament](https://www.amazon.com/s?k=PETG+filament+1.75mm)

### A scrap of nitrile glove or thin silicone sheet — **free**

- **Does:** the membrane over the trigger microswitch lever
- The microswitch is the least sealed part of the whole build and it lives in your
  soapy palm. A stretched membrane over a printed pocket passes the press through
  and keeps the liquid out
- The alternative is buying a sealed IP67 microswitch with the same lever, which is
  harder to source than it sounds

---

## Tools

One of each — these are not per arm.

- **Soldering iron**
- **Flux-core solder, 0.8 mm** — see the note below, it's not a throwaway choice
- **Flux pen** — separate from the solder. The IP65 strip pads are the grubbiest
  joints in this build and they want extra flux
- Wire strippers, small side cutters
- **Multimeter** — not optional. Spec below
- Heat gun or lighter — for heat-shrink
- **Thermal camera** — optional, genuinely useful. See below
- 3D printer — trigger plate, cell cradle, controller pod, bubbler mount
- **USB-C data cable** — a charge-only cable will waste you half an hour.
  [Search USB-C data sync cable](https://www.amazon.com/s?k=USB+C+data+sync+cable)

### Solder: leaded or lead-free?

Worth thirty seconds of thought, because the usual reasoning is slightly off.

- **The fumes that make you feel ill are the rosin flux, not the lead.** Lead does
  not vaporise at soldering temperatures. Ventilate regardless — a cheap fan
  pulling air away from your face is the fix, whichever solder you buy
- **The actual lead risk is ingestion** — lead on your hands, then your food. Wash
  your hands, don't eat at the bench, and that's the exposure closed
- **Lead-free (SAC305)** needs a hotter iron (~350 °C) and wets noticeably worse.
  That matters here, because the hardest joints in this build are the tiny copper
  pads on IP65 strip
- **Leaded 63/37** is much more forgiving on those pads

**Either is defensible.** Pick lead-free if you'd rather not have lead in the house;
just expect the strip joints to fight you a little and turn the iron up. Pick 63/37
if you want the strip work to go smoothly and you're happy washing your hands.

- **Buy flux-core either way.** Solid wire with no flux is miserable
- The **pen-style dispenser** is a nice thing to own, but buy a **spool for the
  build** and keep the pen in the field kit — it's for repairs, not for 40 joints
  in an afternoon
- **Suggested products:**
  [search 63/37 rosin-core 0.8 mm](https://www.amazon.com/s?k=63%2F37+rosin+core+solder+0.8mm) ·
  [search lead-free rosin-core 0.8 mm](https://www.amazon.com/s?k=lead+free+rosin+core+solder+0.8mm) ·
  [search rosin flux pen](https://www.amazon.com/s?k=rosin+flux+pen+no+clean)

### Multimeter spec

You'll use it for polarity checks before every first power-up, for continuity
tracing, and for measuring actual current draw. Minimum useful spec:

- **DC voltage** — the one you'll use most
- **AC voltage** — not needed for this build, but you own a multimeter for life
- **DC current to at least 2 A**, on a **fused** input
- **Continuity with an audible beeper** — and a *fast* one. This is what you'll
  actually live in while tracing a dead strip segment
- **Resistance**
- **Capacitance** — nice to have, useful for checking the 1000 µF is what it claims

Also worth having: auto-ranging, a backlight, and a hold button. You will be under
a table in bad light.

**Suggested products:**

- **Good enough, cheap:**
  [Neoteck auto-ranging DMM](https://www.amazon.com/Neoteck-Multimeter-Multimeters-Resistance-Transistor/dp/B01NAVAT9S)
  — hits every line of the spec above, dual-fused, CAT II 600 V
- **Also fine:**
  [Proster PSTTL334](https://www.amazon.com/Proster-PSTTL334-Multimeter-Temperature-Capacitance/dp/B0194VGLFS)
  — same class, adds temperature and comes with alligator clips
- **Buy once, cry once:**
  [Fluke 115](https://www.amazon.com/Fluke-115-Compact-True-RMS-Multimeter/dp/B000OCFFMW)
  — overkill for this build, correct for the next twenty years. Only worth it if you
  expect to keep doing electronics

**Bought:** [INNOVA 3320 auto-ranging DMM](https://www.amazon.com/dp/B000EVYGZA). It
meets the spec above — DC current to 10 A, an audible continuity beeper that sounds
below ~120 Ω, resistance, auto-ranging. **Two gaps, neither fatal:** no capacitance
range, so the 1000 µF caps go in on their markings alone; and **confirm the 10 A jack
is fused** before you use it for a current draw measurement.

For *this* build any of the three is sufficient — nothing here is a hard measurement.
The continuity beeper is what you'll actually live in.

### Thermal camera

- **Does:** shows you the hot component before it becomes a dead component
- Turns [BUILD.md](BUILD.md) step 6's "touch it and see if it's warm" from a
  fingertip guess into an actual measurement
- Best at finding: a shorted boost module, a MOSFET that turned out not to be
  logic-level, a strip section drawing more than it should
- A borrowed one used once during bench test is plenty. You don't need to own it
- **No link** — you already own one; it's on the README checklist to dig out

---

## The parts people skip

Ordered by how much pain skipping them causes:

1. **74AHCT125** → random flicker, only in the field, impossible to reproduce
2. **`CR1` 1N5819** → dead MOSFET, later, for no visible reason
3. **Common ground** (not a part — a rule) → bizarre unrepeatable behaviour
4. **10 kΩ gate pulldown** → the blower twitches at every boot and the code is
   innocent
5. **`CR2` 1N5819** → the pack backfeeds whatever you plug the USB cable into
6. **330–470 Ω resistor** → first pixel only, wrong colour
7. **1000 µF capacitor** → voltage dips when pixels light, brain gets confused
8. **0.1 µF ceramic at the 74AHCT125** → the same flicker as a missing shifter, at a tenth the cost to prevent

## The one connector mistake that costs a board

**The trigger pigtail must not be PH2.0.** It shares a shell with the battery lead
that ships on every cell. See [Connectors](#connectors).
