darknet-doll/clown/3d-prints/wrist-splint-mount/versions/wrist_splint_whole.3mf

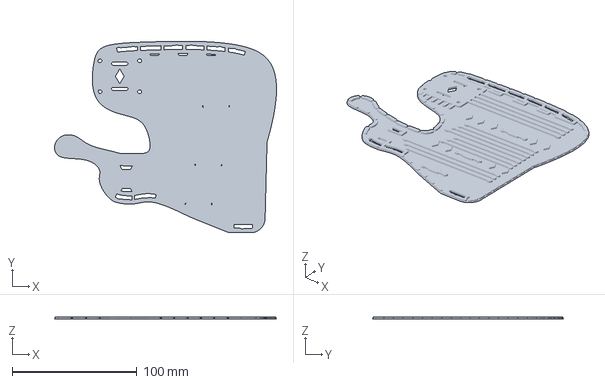
[picture p25: CAD file, 2026-10-26]
3d-prints/wrist-splint-mount/versions/wrist_splint_whole.3mf
178.0 x 153.5 x 1.80 mm
