darknet-doll/clown/3d-prints/finger-trigger-ring/versions/finger-trigger-ring-v4-c62.5-full.stl

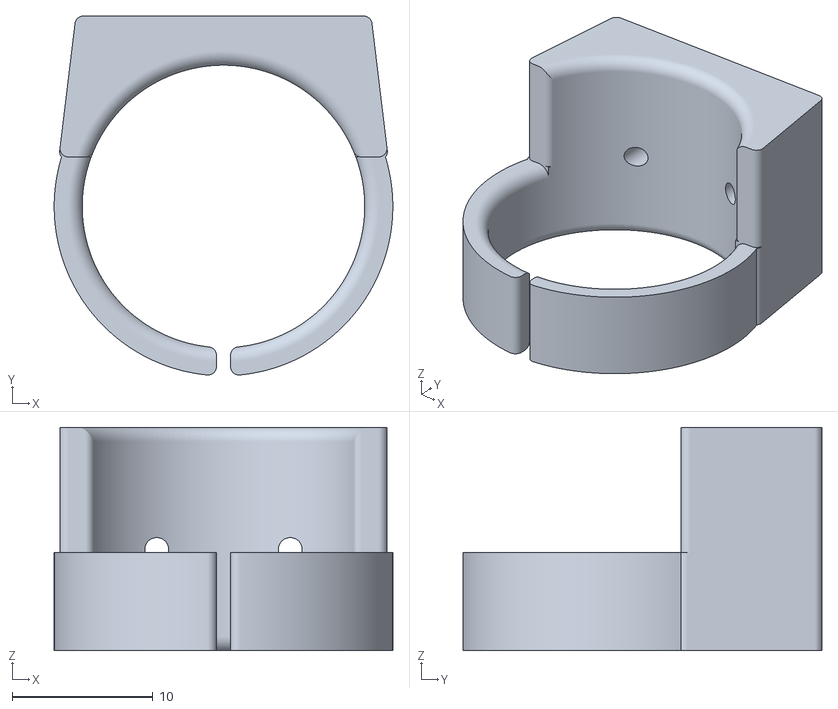
[picture p26: CAD file, 2026-10-29]
3d-prints/finger-trigger-ring/versions/finger-trigger-ring-v4-c62.5-full.stl
24.1 x 25.5 x 15.9
