darknet-doll/clown/3d-prints/wrist-splint-mount/versions/wrist-splint-mount-v5-tulle-full.3mf

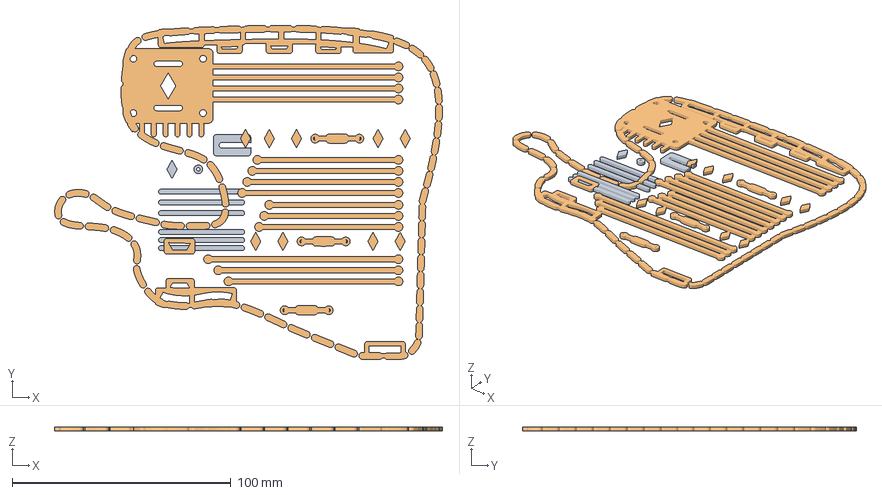
[picture p27: CAD file, 2026-10-26]
3d-prints/wrist-splint-mount/versions/wrist-splint-mount-v5-tulle-full.3mf
177.2 x 152.7 x 1.80 mm
wrist-splint-mount-v4-tulle-square.stl
wrist-splint-mount-v5-tulle-full.stl
