darknet-doll/clown/3d-prints/finger-trigger-ring/versions/finger-trigger-ring-v4-c52.5-full.stl

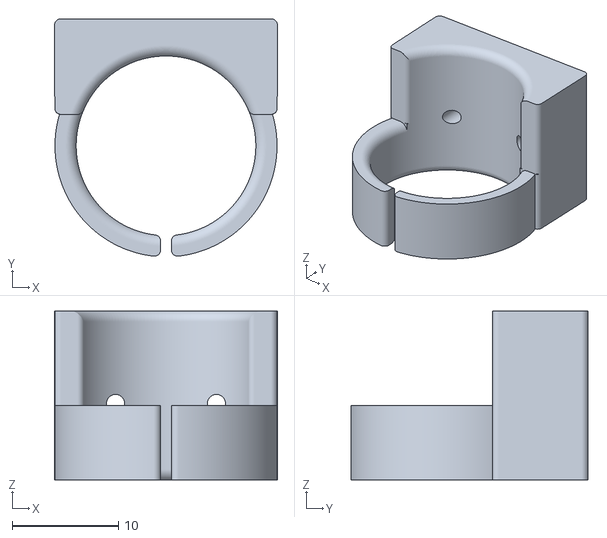
[picture p30: CAD file, 2026-10-29]
3d-prints/finger-trigger-ring/versions/finger-trigger-ring-v4-c52.5-full.stl
21.0 x 22.3 x 15.9
