darknet-doll/clown/3d-prints/finger-trigger-ring/versions/finger-trigger-ring-v4-c57.5-full.stl

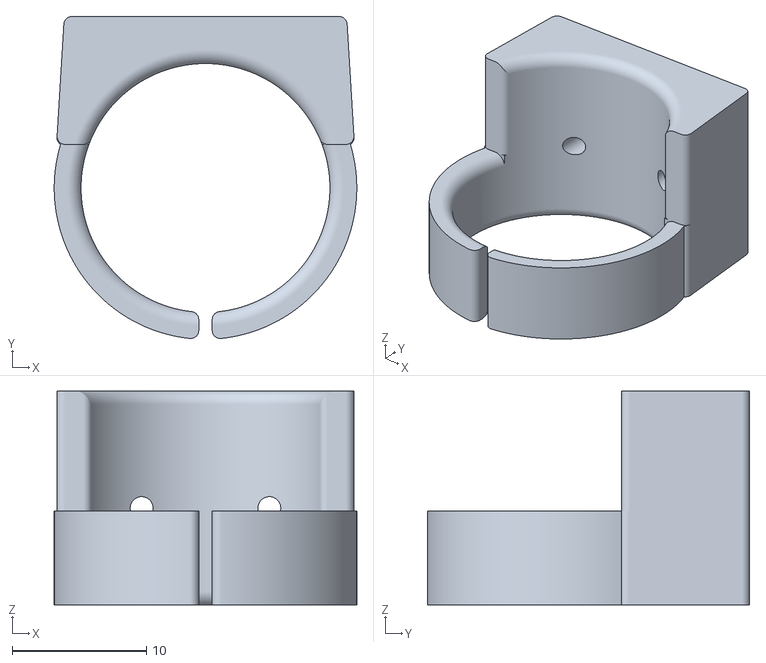
[picture p31: CAD file, 2026-10-29]
3d-prints/finger-trigger-ring/versions/finger-trigger-ring-v4-c57.5-full.stl
22.5 x 23.9 x 15.9
