darknet-doll/clown/3d-prints/finger-trigger-ring/versions/finger-trigger-ring-v4-c47.5-full.stl

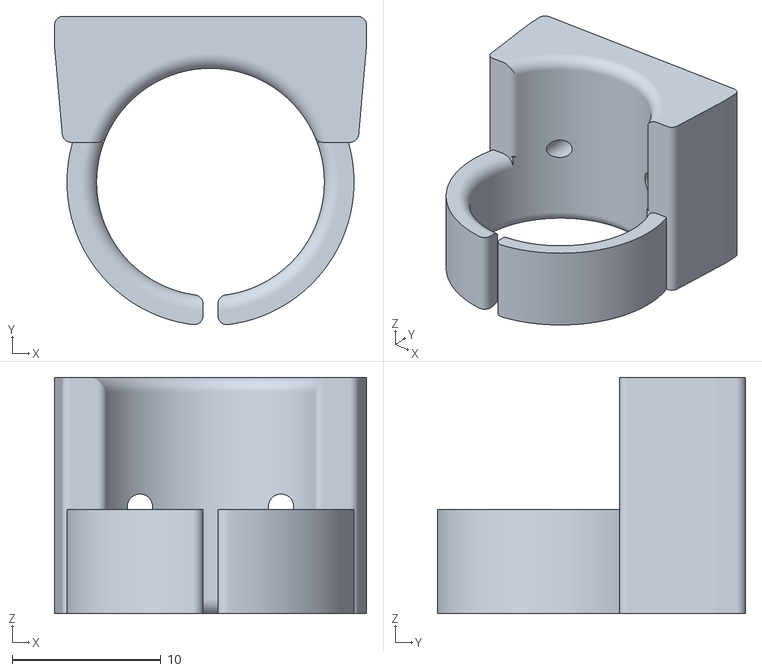
[picture p32: CAD file, 2026-10-29]
3d-prints/finger-trigger-ring/versions/finger-trigger-ring-v4-c47.5-full.stl
21.0 x 20.8 x 15.9
