darknet-doll/clown/3d-prints/wrist-splint-mount/versions/wrist-splint-mount-v2-full.stl

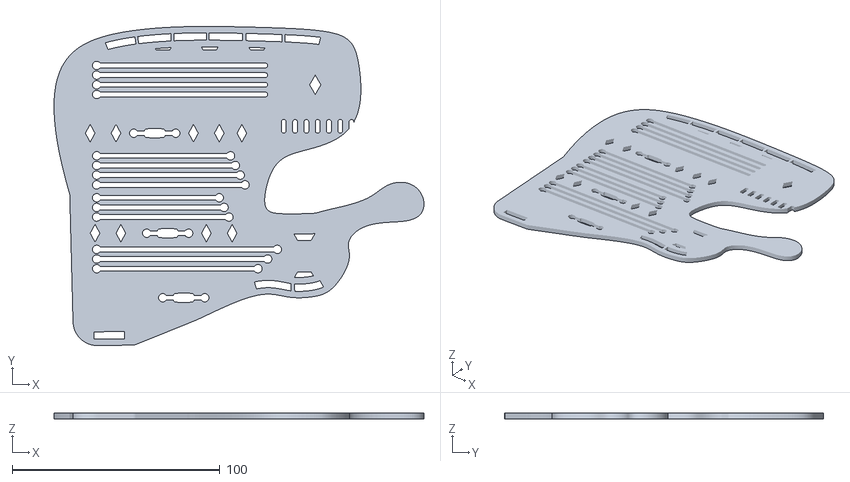
[picture p33: CAD file, 2026-10-15]
3d-prints/wrist-splint-mount/versions/wrist-splint-mount-v2-full.stl
178.0 x 153.5 x 2.72
