darknet-doll/clown/3d-prints/finger-trigger-ring/versions/finger-trigger-ring-v4-c60-full.stl

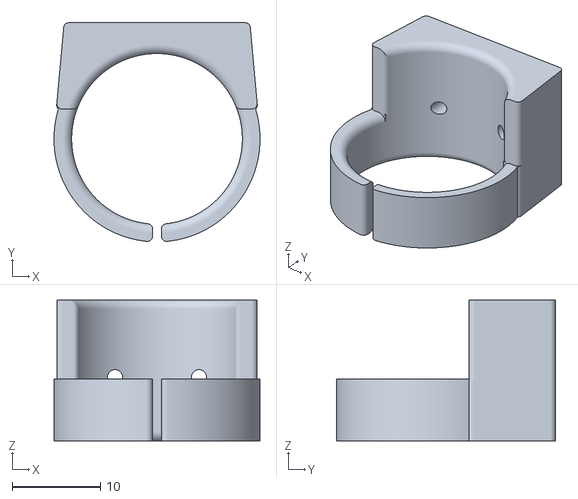
[picture p34: CAD file, 2026-10-29]
3d-prints/finger-trigger-ring/versions/finger-trigger-ring-v4-c60-full.stl
23.3 x 24.7 x 15.9
