darknet-doll/clown/3d-prints/finger-trigger-ring/versions/finger-trigger-ring-v4-c55-full.stl

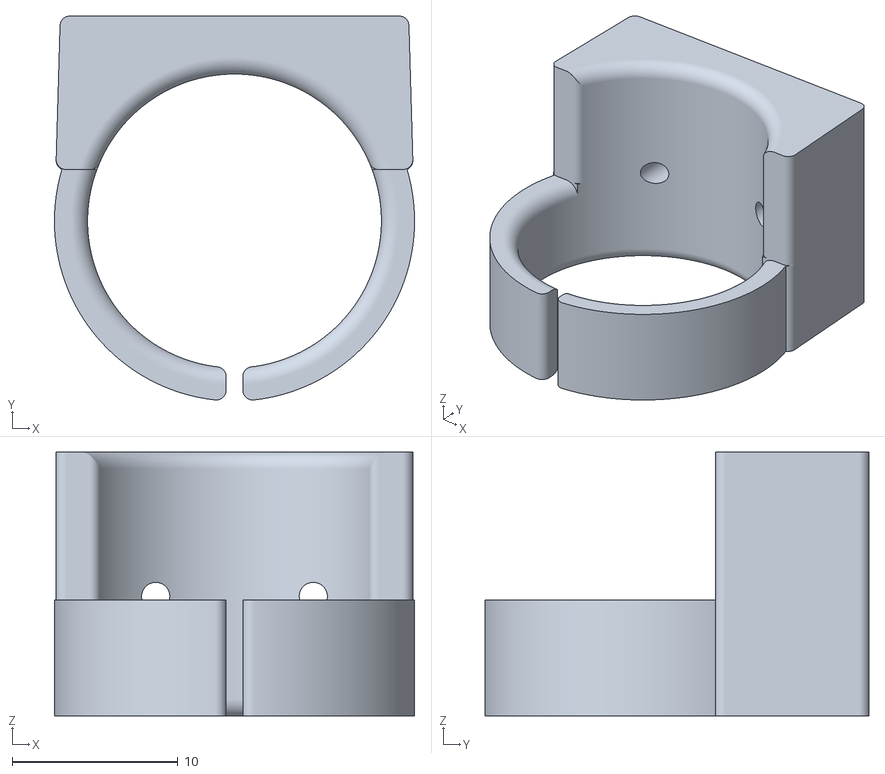
[picture p35: CAD file, 2026-10-29]
3d-prints/finger-trigger-ring/versions/finger-trigger-ring-v4-c55-full.stl
21.7 x 23.1 x 15.9
