darknet-doll/clown/3d-prints/finger-trigger-ring/versions/finger-trigger-ring-v4-c50-full.stl

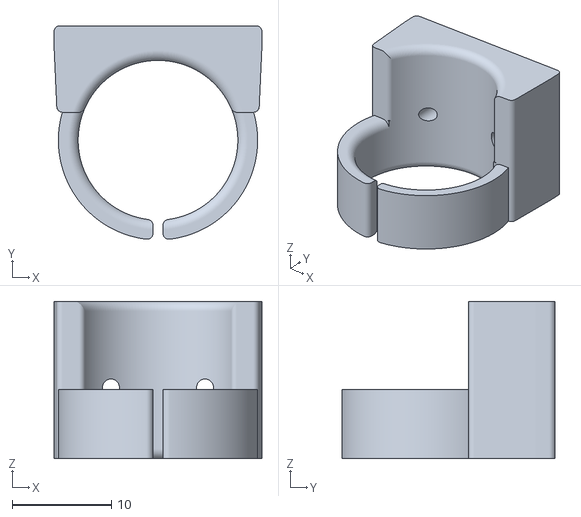
[picture p36: CAD file, 2026-10-29]
3d-prints/finger-trigger-ring/versions/finger-trigger-ring-v4-c50-full.stl
21.0 x 21.6 x 15.9
