darknet-doll/clown/3d-prints/bubble-housing/versions/bubble-housing-v3-base.stl

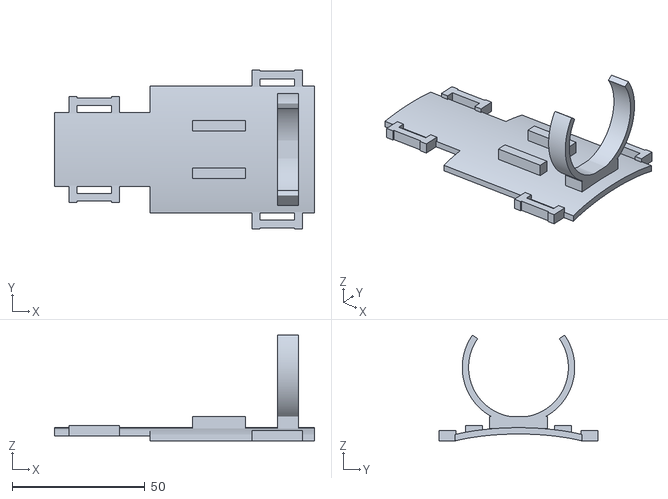
[picture p37: CAD file, 2026-10-12]
3d-prints/bubble-housing/versions/bubble-housing-v3-base.stl
98.0 x 60.0 x 39.9
