darknet-doll/clown/3d-prints/pod-housing/versions/pod-housing-v9-deck.stl

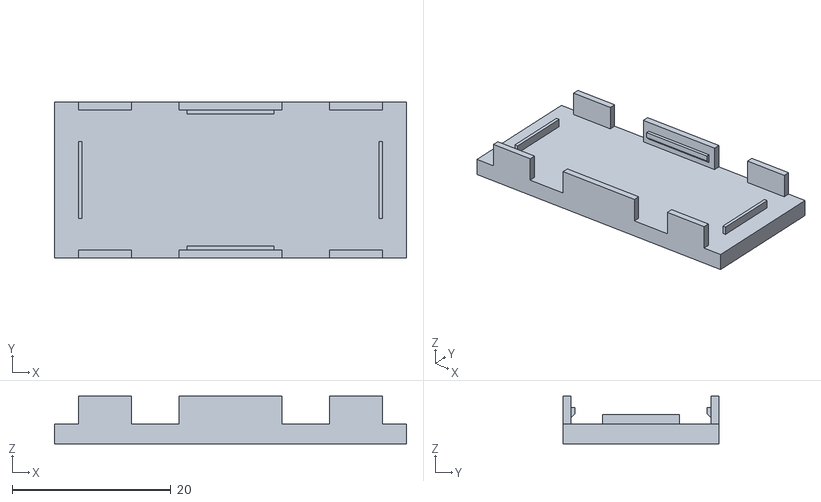
[picture p39: CAD file, 2026-10-30]
3d-prints/pod-housing/versions/pod-housing-v9-deck.stl
44.4 x 19.7 x 6.05
