darknet-doll/clown/3d-prints/wrist-splint-mount/reference/wrist-splint-custom-moldable-model_files/wrist-splint.stl

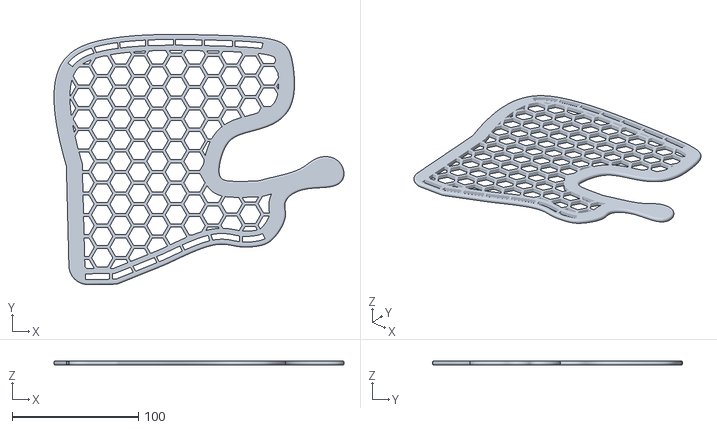
[picture p40: CAD file, 2026-10-12]
3d-prints/wrist-splint-mount/reference/wrist-splint-custom-moldable-model_files/wrist-splint.stl
229.3 x 197.8 x 3.50
