darknet-doll/clown/3d-prints/bubble-housing/versions/bubble-housing-v3-shroud.stl

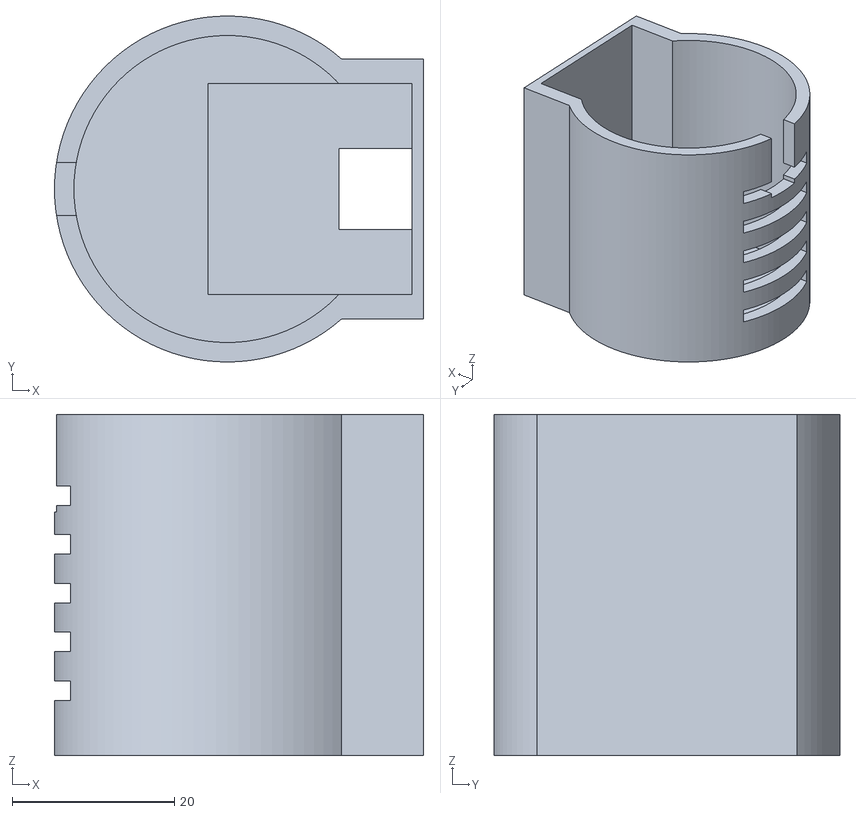
[picture p41: CAD file, 2026-10-12]
3d-prints/bubble-housing/versions/bubble-housing-v3-shroud.stl
45.5 x 42.6 x 42.0
