darknet-doll/clown/3d-prints/pod-housing/versions/pod-housing-v9-seals.stl

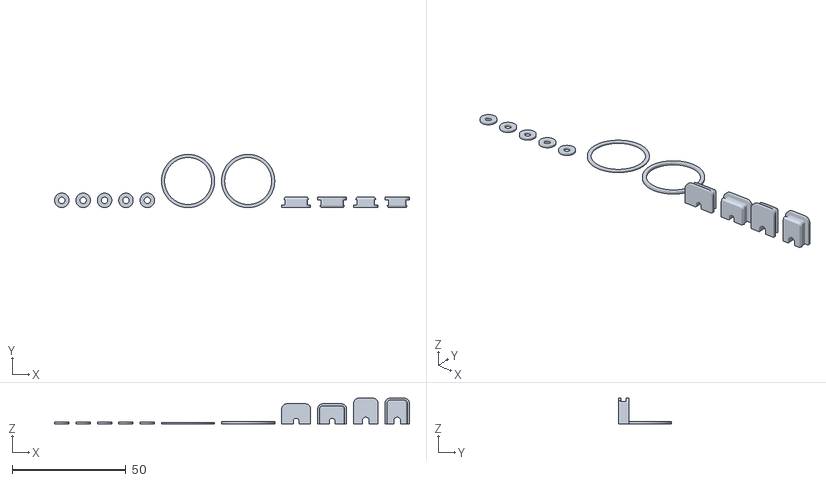
[picture p42: CAD file, 2026-10-30]
3d-prints/pod-housing/versions/pod-housing-v9-seals.stl
156.0 x 23.4 x 11.4
