darknet-doll/clown/3d-prints/bubble-housing/versions/bubble-housing-v2-slot-coupon.stl

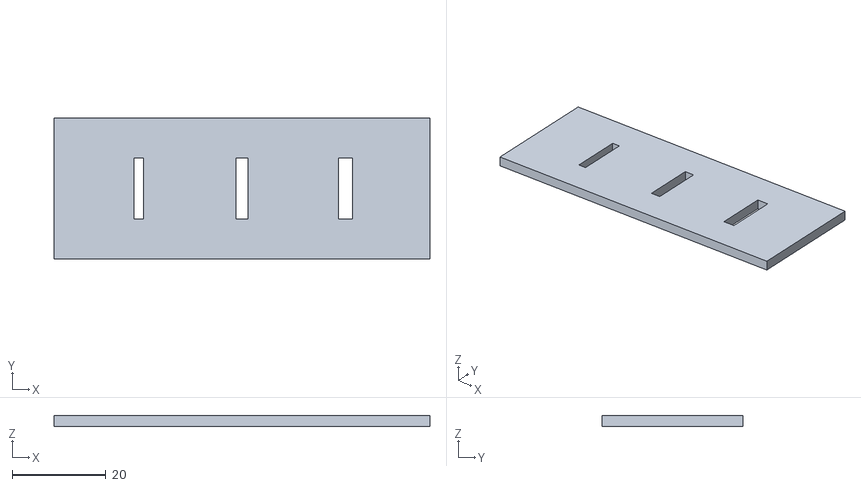
[picture p43: CAD file, 2026-10-09]
3d-prints/bubble-housing/versions/bubble-housing-v2-slot-coupon.stl
80.0 x 30.0 x 2.40
