darknet-doll/clown/3d-prints/pod-housing/versions/pod-housing-v8-bottom.stl

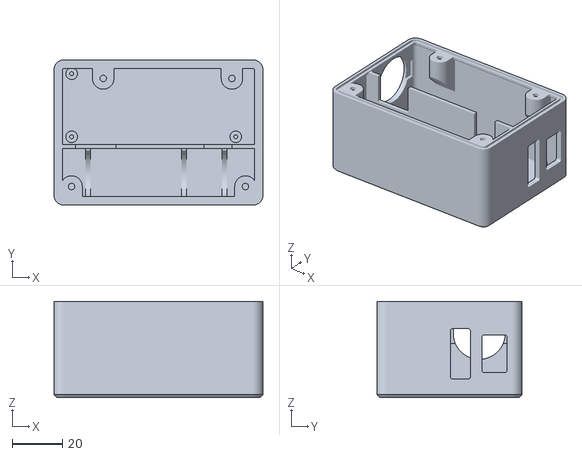
[picture p44: CAD file, 2026-10-30]
3d-prints/pod-housing/versions/pod-housing-v8-bottom.stl
82.8 x 57.6 x 38.2
