darknet-doll/clown/3d-prints/wrist-splint-mount/versions/wrist-splint-mount-v7-wrap-band.stl

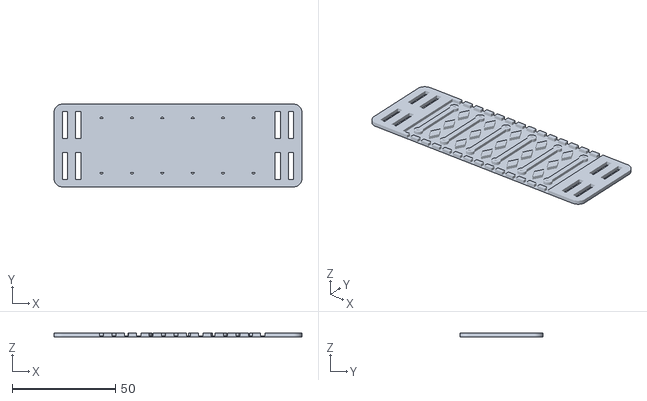
[picture p45: CAD file, 2026-10-21]
3d-prints/wrist-splint-mount/versions/wrist-splint-mount-v7-wrap-band.stl
120.0 x 40.0 x 1.80
