darknet-doll/clown/3d-prints/finger-trigger-ring/versions/finger-trigger-ring-v4-c55-short.stl

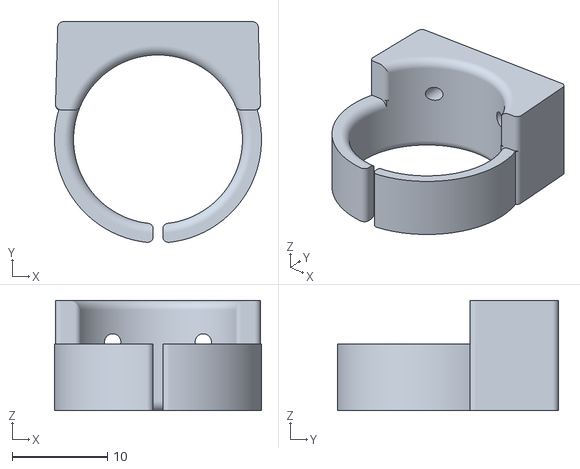
[picture p46: CAD file, 2026-10-29]
3d-prints/finger-trigger-ring/versions/finger-trigger-ring-v4-c55-short.stl
21.7 x 23.1 x 11.6
