darknet-doll/clown/3d-prints/pod-housing/versions/pod-housing-v8-gasket.stl

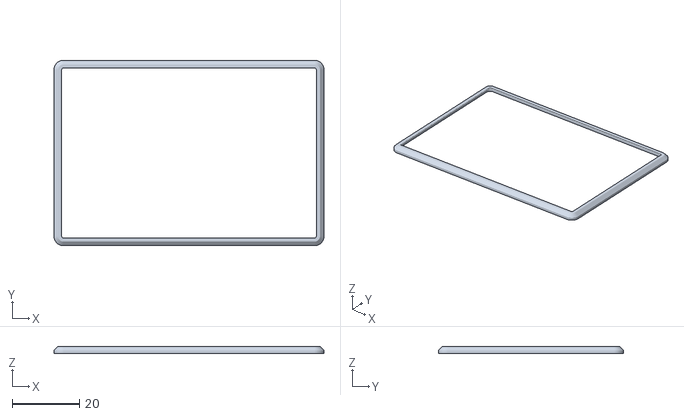
[picture p47: CAD file, 2026-10-30]
3d-prints/pod-housing/versions/pod-housing-v8-gasket.stl
80.5 x 55.3 x 2.15
