darknet-doll/clown/3d-prints/bubble-housing/versions/bubble-housing-v1-clip-coupons.stl

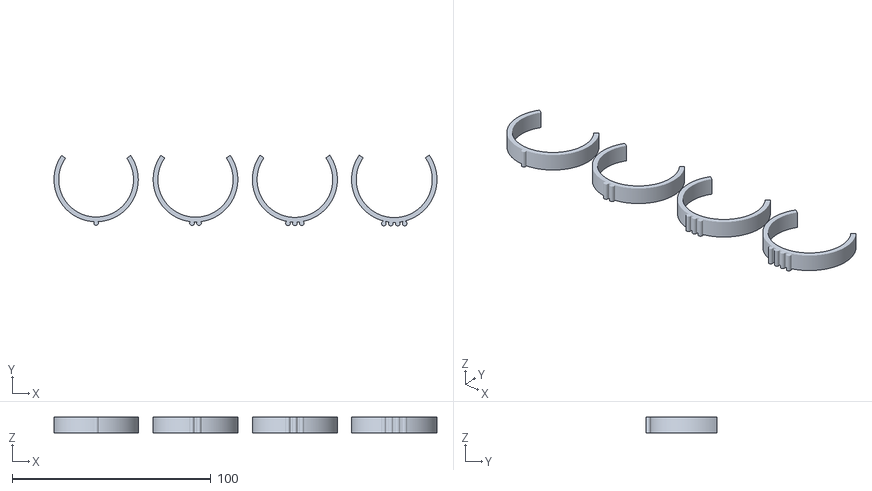
[picture p48: CAD file, 2026-10-08]
3d-prints/bubble-housing/versions/bubble-housing-v1-clip-coupons.stl
192.7 x 35.6 x 8.00
