darknet-doll/clown/3d-prints/pod-housing/versions/pod-housing-v8-lid.stl

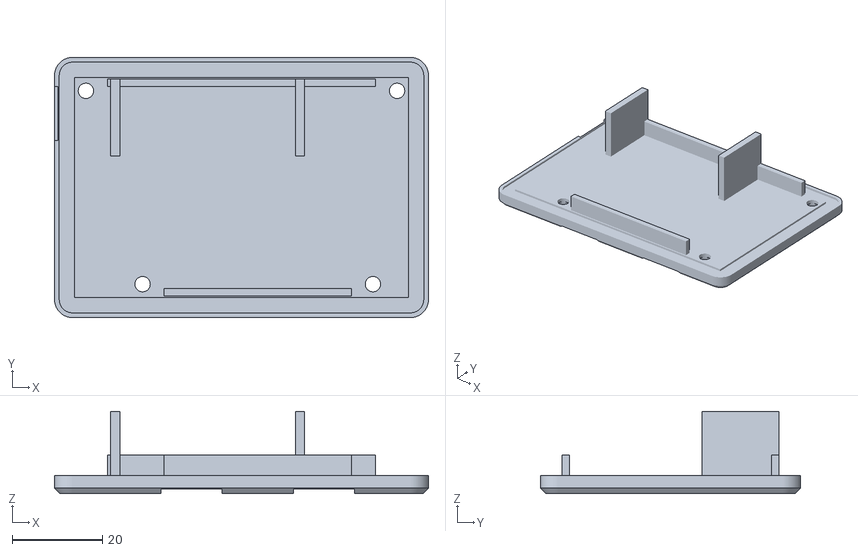
[picture p49: CAD file, 2026-10-30]
3d-prints/pod-housing/versions/pod-housing-v8-lid.stl
82.8 x 57.6 x 18.2
