darknet-doll/clown/3d-prints/wrist-splint-mount/versions/wrist-splint-mount-v4-tulle-square.stl

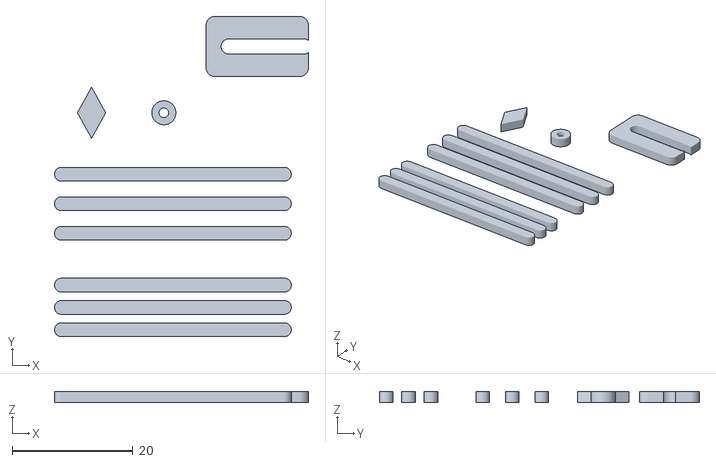
[picture p50: CAD file, 2026-10-15]
3d-prints/wrist-splint-mount/versions/wrist-splint-mount-v4-tulle-square.stl
42.2 x 53.2 x 1.80
