darknet-doll/clown/3d-prints/wrist-splint-mount/versions/wrist-splint-mount-v3-membrane-coupon-04.stl

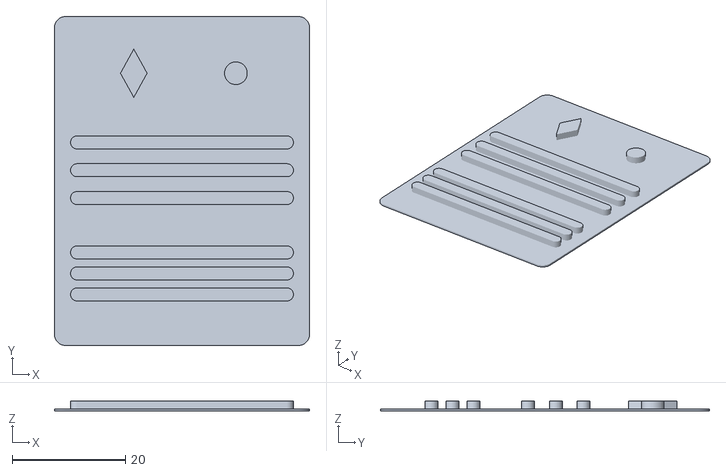
[picture p51: CAD file, 2026-10-15]
3d-prints/wrist-splint-mount/versions/wrist-splint-mount-v3-membrane-coupon-04.stl
45.0 x 58.0 x 1.80
