darknet-doll/clown/3d-prints/pod-housing/versions/pod-housing-v5-seal-tray.stl

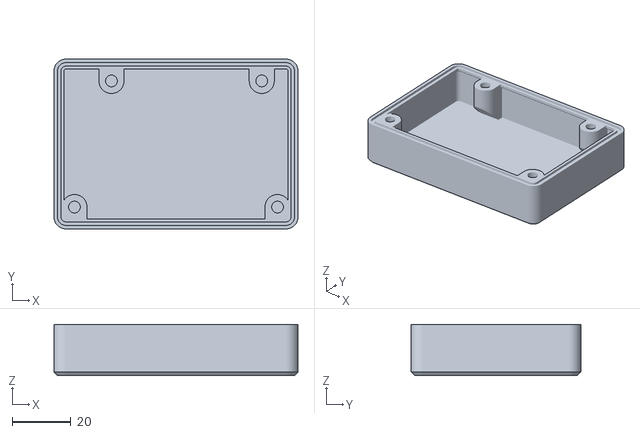
[picture p52: CAD file, 2026-10-30]
3d-prints/pod-housing/versions/pod-housing-v5-seal-tray.stl
82.8 x 57.6 x 17.4
