darknet-doll/clown/3d-prints/wrist-splint-mount/versions/wrist-splint-mount-v1-dorsal-coupon-35.stl

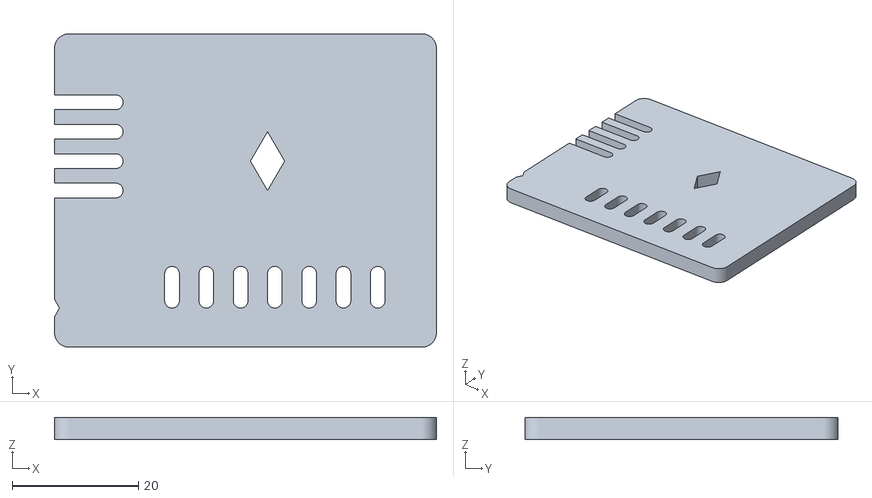
[picture p53: CAD file, 2026-10-15]
3d-prints/wrist-splint-mount/versions/wrist-splint-mount-v1-dorsal-coupon-35.stl
60.5 x 49.7 x 3.50
