darknet-doll/clown/3d-prints/finger-trigger-ring/versions/finger-trigger-ring-v4-c52.5-short.stl

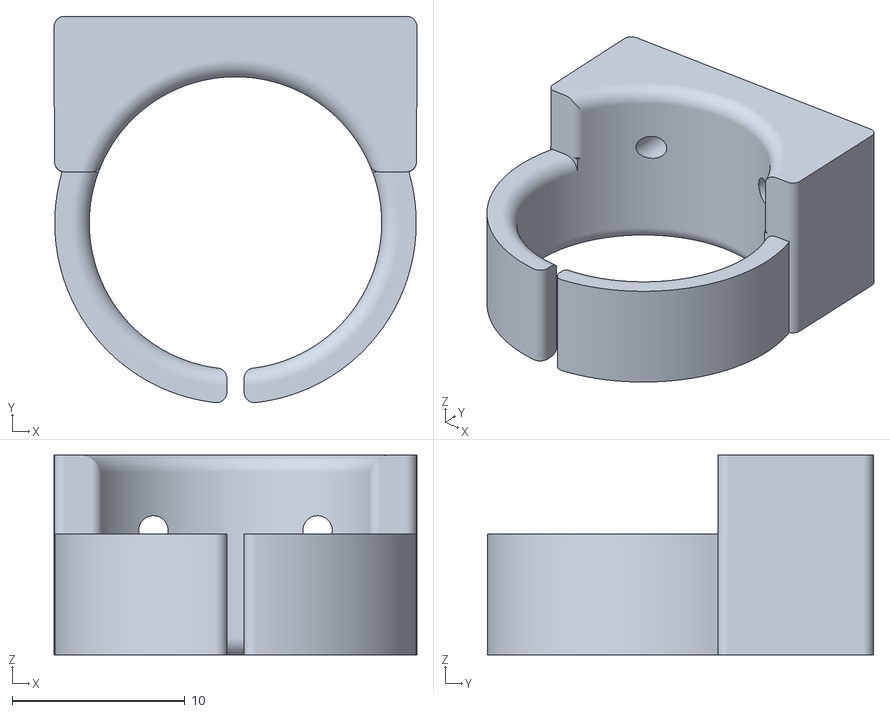
[picture p54: CAD file, 2026-10-29]
3d-prints/finger-trigger-ring/versions/finger-trigger-ring-v4-c52.5-short.stl
21.0 x 22.3 x 11.6
