darknet-doll/clown/3d-prints/finger-trigger-ring/versions/finger-trigger-ring-v4-c60-short.stl

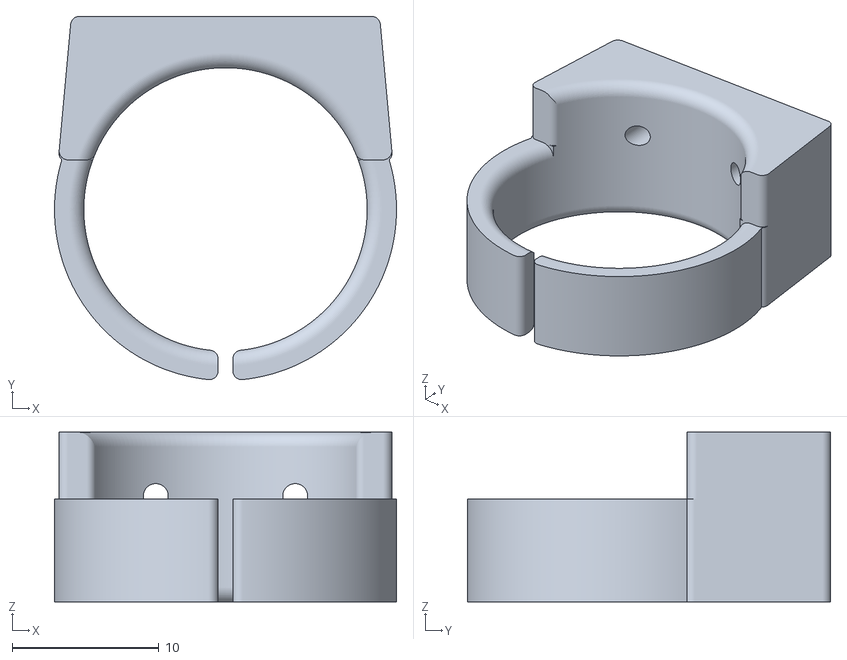
[picture p56: CAD file, 2026-10-29]
3d-prints/finger-trigger-ring/versions/finger-trigger-ring-v4-c60-short.stl
23.3 x 24.7 x 11.6
