darknet-doll/clown/3d-prints/finger-trigger-ring/versions/finger-trigger-ring-v4-c57.5-short.stl

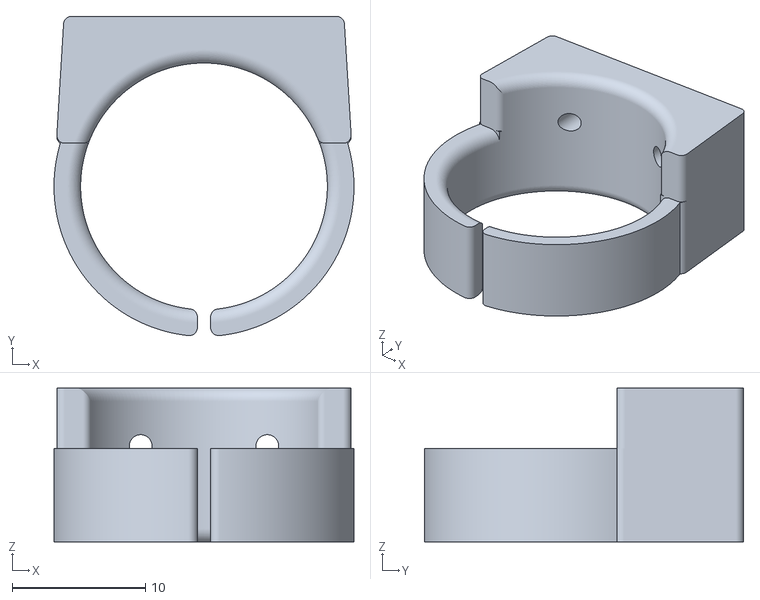
[picture p57: CAD file, 2026-10-29]
3d-prints/finger-trigger-ring/versions/finger-trigger-ring-v4-c57.5-short.stl
22.5 x 23.9 x 11.6
