darknet-doll/clown/3d-prints/pod-housing/versions/pod-housing-v3-snap-coupon.stl

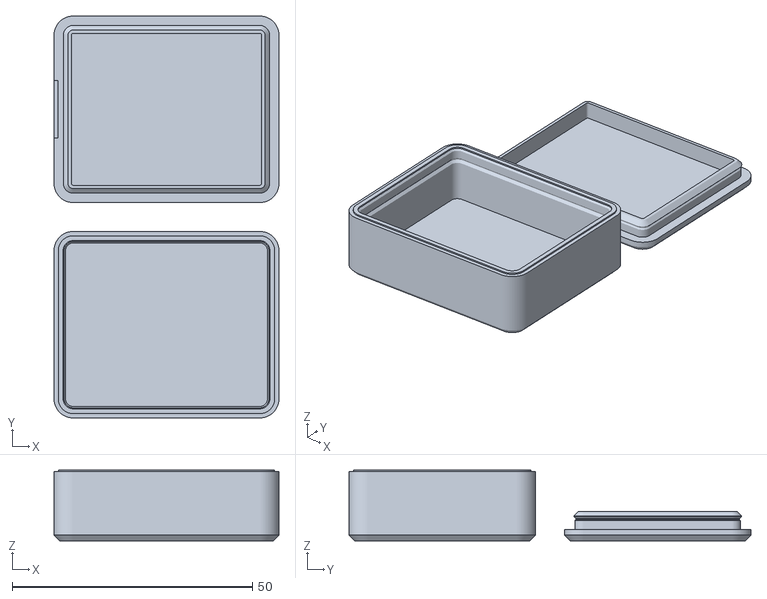
[picture p58: CAD file, 2026-10-30]
3d-prints/pod-housing/versions/pod-housing-v3-snap-coupon.stl
46.8 x 83.6 x 14.7
