darknet-doll/clown/3d-prints/finger-trigger-ring/versions/finger-trigger-ring-v4-c45-short.stl

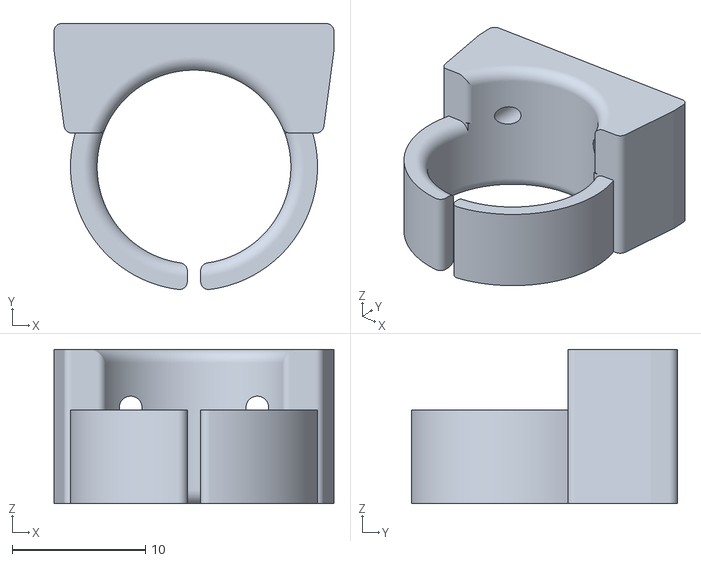
[picture p59: CAD file, 2026-10-29]
3d-prints/finger-trigger-ring/versions/finger-trigger-ring-v4-c45-short.stl
21.0 x 20.0 x 11.6
