darknet-doll/clown/3d-prints/pod-housing/versions/pod-housing-v2-wall-coupon.stl

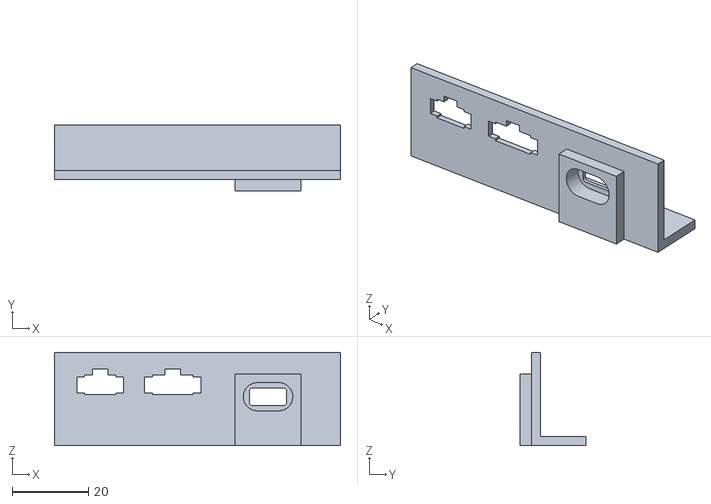
[picture p60: CAD file, 2026-10-30]
3d-prints/pod-housing/versions/pod-housing-v2-wall-coupon.stl
75.0 x 17.4 x 24.4
