darknet-doll/clown/3d-prints/finger-trigger-ring/versions/finger-trigger-ring-v4-c65-short.stl

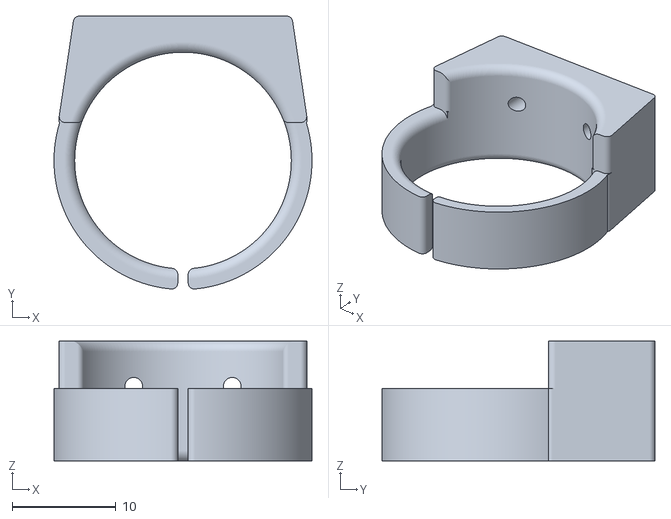
[picture p61: CAD file, 2026-10-29]
3d-prints/finger-trigger-ring/versions/finger-trigger-ring-v4-c65-short.stl
24.9 x 26.3 x 11.6
