darknet-doll/clown/3d-prints/finger-trigger-ring/versions/finger-trigger-ring-v4-c62.5-short.stl

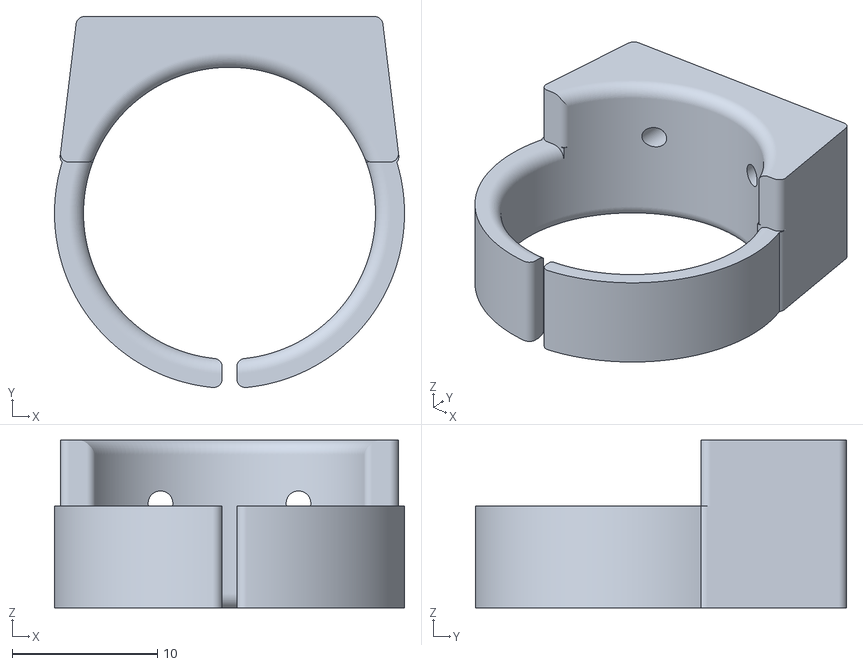
[picture p62: CAD file, 2026-10-29]
3d-prints/finger-trigger-ring/versions/finger-trigger-ring-v4-c62.5-short.stl
24.1 x 25.5 x 11.6
