darknet-doll/clown/3d-prints/finger-trigger-ring/versions/finger-trigger-ring-v2-c65.stl

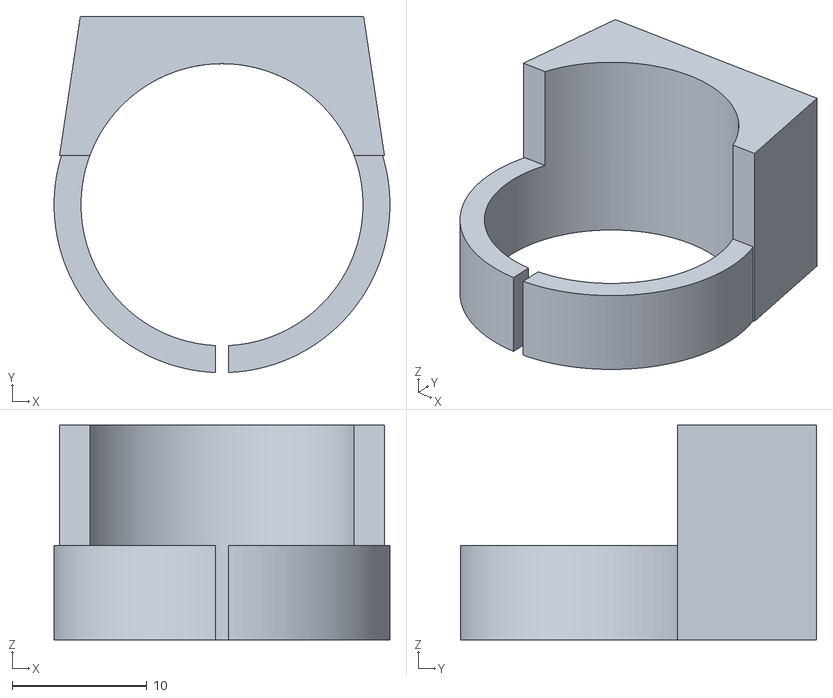
[picture p63: CAD file, 2026-10-28]
3d-prints/finger-trigger-ring/versions/finger-trigger-ring-v2-c65.stl
24.9 x 26.4 x 15.9
