darknet-doll/clown/3d-prints/finger-trigger-ring/versions/finger-trigger-ring-v1-c50.stl

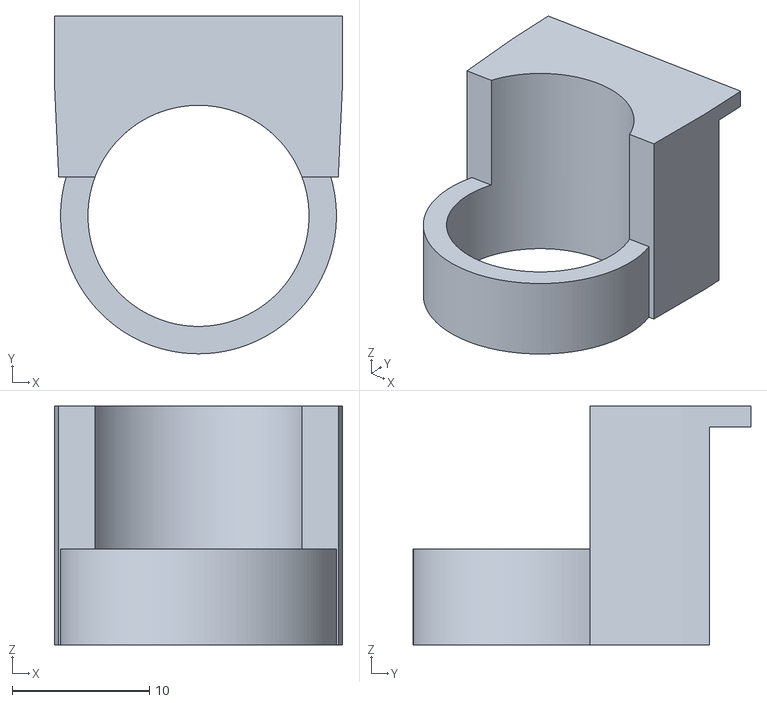
[picture p64: CAD file, 2026-10-28]
3d-prints/finger-trigger-ring/versions/finger-trigger-ring-v1-c50.stl
21.0 x 24.6 x 17.4
