darknet-doll/clown/(list of files, cad)

Other CAD files:
3d-prints/wrist-splint-mount/versions/wrist-splint-mount-v6-membrane-full.stl
3d-prints/wrist-splint-mount/versions/wrist-splint-mount-v3-membrane-coupon-06.stl
3d-prints/finger-trigger-ring/versions/finger-trigger-ring-v4-c50-short.stl
3d-prints/bubble-housing/versions/archive/bubble-housing-v1-slot-coupon.stl
3d-prints/bubble-housing/versions/bubble-housing-v1-base.stl
3d-prints/bubble-housing/versions/bubble-housing-v1-shroud.stl
3d-prints/bubble-housing/versions/bubble-housing-v1-slot-coupon.stl
3d-prints/bubble-housing/versions/bubble-housing-v2-base.stl
3d-prints/finger-trigger-ring/versions/archive/finger-trigger-ring-v1-c65.stl
3d-prints/pod-housing/versions/archive/pod-housing-v1-wall-coupon.stl
3d-prints/pod-housing/versions/archive/pod-housing-v2-bottom.stl
3d-prints/pod-housing/versions/archive/pod-housing-v2-snap-coupon.stl
3d-prints/pod-housing/versions/archive/pod-housing-v2-usb-plug.stl
3d-prints/pod-housing/versions/archive/pod-housing-v3-bottom.stl
3d-prints/pod-housing/versions/archive/pod-housing-v3-deck.stl
3d-prints/pod-housing/versions/archive/pod-housing-v3-wall-coupon.stl
3d-prints/pod-housing/versions/archive/pod-housing-v4-bottom.stl
3d-prints/pod-housing/versions/archive/pod-housing-v4-deck.stl
3d-prints/pod-housing/versions/archive/pod-housing-v4-wall-coupon.stl
3d-prints/pod-housing/versions/archive/pod-housing-v5-deck.stl
3d-prints/pod-housing/versions/archive/pod-housing-v7-wall-coupon.stl
3d-prints/pod-housing/versions/archive/pod-housing-v8-seal-tray.stl
3d-prints/pod-housing/versions/pod-housing-v1-bottom.stl
3d-prints/pod-housing/versions/pod-housing-v1-lid.stl
3d-prints/pod-housing/versions/pod-housing-v2-deck.stl
3d-prints/pod-housing/versions/pod-housing-v2-lid.stl
3d-prints/pod-housing/versions/pod-housing-v3-lid.stl
3d-prints/pod-housing/versions/pod-housing-v4-lid.stl
3d-prints/pod-housing/versions/pod-housing-v5-bottom.stl
3d-prints/pod-housing/versions/pod-housing-v5-lid.stl
3d-prints/pod-housing/versions/pod-housing-v5-seals.stl
3d-prints/pod-housing/versions/pod-housing-v6-seals.stl
3d-prints/pod-housing/versions/pod-housing-v7-seals.stl
3d-prints/wrist-splint-mount/versions/wrist-splint-mount-v5-tulle-full.stl
