darknet-doll/clown/3d-prints/bubble-housing/bubble-housing.md

# Bubble Housing — v3

The floral piece on the back of the hand that hides the kit's blower head
([DESIGN.md](../../DESIGN.md)). v1 is a plain fit test of Concept 1 rev B (saddle +
C-clip + rear shroud + two Velcro straps), with no clown details. Left hand only.
Concepts and renders: `concepts/`. Current print files: `versions/`, from `export_v<n>.py`;
replaced ones and finished test pieces: `versions/archive/`. What changed in every
version and why: [../CHANGELOG.md](../CHANGELOG.md).

## Ground Truth

### Kit blower head, measured (Mitutoyo digital calipers, 2026-10-05)

Photos and fit check: the "Bubble Housing — Fit Measurements" doc
(claude.ai/code/artifact/fd5f26c4-f0d6-408c-8184-20381712c91c)

| ID | What | mm |
|---|---|---|
| B1 | Front ring OD (holds the wand wheel) | 37.50 |
| B2 | Overall length, ring face to back of motor bracket | 52.01 |

### Velcro strap (measured 2026-10-08)

| What | mm |
|---|---|
| Width | 11 |
| Thickness | 1.1 |

### Hand (left, back of hand; landmarks read off photos, still to confirm)

| ID | What | mm |
|---|---|---|
| H1 | Width across the back of the hand, mid-hand | 53.02 |
| H2 | Length along the back of the hand, wrist toward knuckles, pinky side | 44.58 |
| H3 | Width at the wrist end of the back of the hand | 29.21 |
| H4 | Width across the knuckles | UNKNOWN (display not in the photo) |

### Reference: "Bubble Gun Toy" REV1 (third-party pocket for the same kit)

- **Source:** MakerWorld, designer Matthew Ghost, "Bubble Gun Toy", Model Revision #1
  (2024-12-14, added air holes to 01/02_Body)
- **License:** MakerWorld Standard Digital File License — **no redistribution**. The
  repo is public, so the model files stay out of git (see `.gitignore`)
- **Local files** (gitignored, present on darknetdoll's machine only):
  - `reference/bubble-gun-toy/Bubble_Gun_REV1.3mf` — original download
  - `reference/bubble-gun-toy/stl/*.stl` — all 11 parts, regenerated by `extract.py`
  - `reference/bubble-gun-toy/body-01-depth-map.png` — 01_Body seen from the split face
- **Committed:** `extract.py` (3MF → STLs) and `bore.py` (bore radius table)
- **What it is:** a gun that houses the **same Bambu Electric Bubble Maker Kit 01** we
  have. So its blower pocket was sized to the real blower head. It is **a pocket that
  fits the head, not a drawing of the head**

**Frame** (designer's assembly frame, as extracted):
- z = barrel axis. **z = −5 is the muzzle face**, +z runs back toward the grip
- Barrel axis at x = 0, y = 0. Body halves split on the x = 0 plane
  (01 = x < 0, 02 = x > 0)
- **+y is down** (trigger guard and grip are on +y), −y is the top

**Overall body** (01 + 02 joined): 44.8 (x) × 71.5 (y) × 177 (z) mm

**Layout, front to back:**

| z (mm) | What | Measured from |
|---|---|---|
| −5 → 46.6 | **Blower head pocket**, round, open at the muzzle | ray-cast bore table |
| 46.6 | Bulkhead behind the pocket | axial ray at x 0.5, y 0/−10/15 |
| 56 → 113 | Bottle bay, 32 wide × ~20.5 tall, hatch on the bottom (03_Cover) | depth map |
| 115 → 160 | Trigger + kit microswitch | depth map |
| 160 → 216 | Grip (04_Grip), holds the 18650; 10_Plug closes its end | part bounds |

**Blower head pocket** (inner radius from the barrel axis, both halves joined):

| Feature | Value | Measured from |
|---|---|---|
| Front lip bore | **Ø 37.8** (r 18.89), z −5.0 → 8.55 (13.5 long) | bore table, all 24 angles |
| Main pocket bore | **Ø 39.4** (r 19.70), z 8.55 → 46.6 (38.0 long) | bore table, all 24 angles |
| Shoulder | 0.8 mm radial step at z 8.55, facing back: stops the head sliding out the muzzle | 0.1 mm step scan at 45° |
| Total depth, muzzle face → bulkhead | **51.6** | axial ray |
| Top recess | r 22.7 (3 mm deeper than the bore), z 17 → 43, spans about 225°–315° (the top) | bore table |
| Feed-nipple groove | round channel ~6 wide, r 21.9 at center (3.0 past the lip bore), z −3.7 → 16.5, where it merges into the top recess. Centered 44° off top toward the 02 half, spans ~306°–322° | 2° ray scan, 2026-10-08. The 15° bore table stepped over it |
| Internal ribs, 01 half only | r 8.9–12.4, z 29 → 46.6, at about 120°–165° and 195°–240°. Probably the cable groove that the assembly notes mention | bore table |
| Side slots, through the wall, both halves | 3.8 wide (y −1.9 → 1.9), z 9.5 → 40.0 | x-axis rays |
| Top air intake slots (REV1 "air holes") | ~1.75 wide on a 5 mm pitch, at z 3, 8, 13, 18, 23, 28. Two rows at \|x\| ≈ 10–15, none on the centerline | y-axis rays |

### Gun features to borrow (measured 2026-10-12)

Frame for this table: mm **behind the ring face** (= gun muzzle face), and clock positions
**looking at the ring face with the feed nipple at 12:00** (the gun's own frame has the
nipple 44° off its top). Scripts: `reference/bubble-gun-toy/pocket_sections.py` (1°/0.5 mm
ray map of the pocket wall), `pocket_slices.py`, `split_face_holes.py`, `borrow_figure.py`
(figure kept local: `gun-borrow-reference.png`).

| # | Gun feature | Where (behind ring face, clock) | Borrow for v4 |
|---|---|---|---|
| 1 | Front lip Ø 37.8 | 0 → 13.55 | Clip grips the ring only, inside 0 → 13.5. Our printed bore: 37.6 (coupon) |
| 2 | Main bore Ø 39.4, with a 0.8 radial step at 13.55 | 13.55 → 51.6 | Shroud bore 39.4 behind the ring (v1–v3 used 37.8: the v3 fail). The step locates the head |
| 3 | Back wall | 51.6. Head is 52.01, so it stands 0.4 proud | Inside length 51.6 from the ring face |
| 4 | Feed-nipple groove: +3.0 radial (r 21.9), 20° ≈ 6 wide | 1.3 → 22.0 at 12:00, runs into #5 | Full-length groove 1.3 → 22 (v3's ran 12 from the mouth) |
| 5 | Top recess: +3.0 radial (r 22.7), ~120° wide | 21.75 → 47.25, from ~8:30 to ~12:30 | Same recess over the top of the body |
| 6 | Side slots, 3.8 wide, through the wall | 14.25 → 44.75, at ~1:30 and ~7:30 | Likely the side tabs (confirm with M3/M6). Cut as slots or pockets |
| 7 | Rear blocks: the gun fills one side behind 33.5, leaving the full half-circle from 12:00 clockwise to 6:00, a lobe at 9:00–11:00, and a channel at 7:30 into #6 | 33.5 → 51.6 | Motor end sits off-centre to the 3:00 side; the 7:30 channel is the likely wire path. Confirm with R1–R4 |
| 8 | Air intake: two rows of 6 slots, 2 wide, 5 pitch, each row ~30° (~10 long) | 8 → 35, rows centred ~11:40 and ~9:20 | Copy the pattern over the same zone. REV1 added it "for better airflow" |
| 9 | Clamshell split along the axis; head drops into one half, the other closes | — | Split the shroud the same way: answers "how does the head go in" |
| 10 | Screws: BT2×8. Ø 2.5 through-holes above and below the pocket front (centers measured 2026-10-13 by ray grid: top at 9.9 behind ring face, 28.1 off axis; bottom at 13.5, 25.9 off axis); Ø 1.7–1.8 × 8–8.6 blind holes on top at 22.5 and 47.4 | as listed | Same hole sizes for joining our shroud halves: Ø 2.5 clearance, Ø 1.8 × 8.6 pilot |
| 11 | Bottom opening (bottle-bay hatch, 03_Cover): front face at **61.0 behind the ring face** (z 56.0 in the assembly frame, wall face hit exactly); opening runs back to ~113. An oblong pass-through sits in that front wall (hose/cable route to the bay) | 61.0 → ~113 | Cut plane for the direct-print front housing (see Print Settings) |

### From the designer's assembly notes (text, not measured)

- Hose from the blower head to the bottle lid: **50–70 mm**. Hose inside the
  bottle, lid to gravity ball: **50 mm**
- Silicone sleeve (from the kit) goes on the lid; the lid must stay one-way
- Kit cables run in a groove in 01_Body
- Fasteners: 6 × BT2×8 self-tapping screws

## Constraints

- Blower head intake must stay open. The REV1 revision added the top air holes
  specifically for "better airflow", so a closed shell starves the blower
- Blower head envelope: Ø 37.50 ring (B1) × 52.01 long (B2). Drum diameter behind
  the ring and rear bracket size: UNKNOWN (see Open)
- Head lies along the hand, ring toward the fingers. B2 runs 7.4 past H2, and B1 is
  8.3 wider than H3, so the drum can't sit at the wrist end
- **Feed nipple on top of the head** (spotted at the 2026-10-08 fit test; the gun's
  groove sizes it): a round bump ~6 wide standing ~3 proud of the ring OD, starting
  ~1.3 behind the ring face and running ~20 back. It carries the feed line, so both
  the clip band and the shroud mouth must clear it, and the tube needs a route out

## Spec

v1 values. Several are guesses on purpose, so the fit test can prove or replace them.

- C-clip bore: 37.6   <- fit test 2026-10-08: coupon 1 (one tick) held the ring best of the four. v1 spec'd 37.8, the gun's fit
- C-clip: 8 wide, 2.4 wall, 110° opening on top
- Feed nipple clearance: clock the head so the nipple sits inside the clip opening,
  at least 10° clear of each edge. The nipple needs ~20° of arc at 3.2 radial   <- gun groove envelope + margin
- Drum axis height above plate: T + 4 + 18.75   <- clip sits on a 4.5 pedestal
- Plate: 2.4 thick (T), 48 wide x 62 long; wrist tongue 28 wide x 36 long
- Plate underside curve: UNKNOWN for your hand. v1 follows a stand-in ellipse,
  80 wide x 26 thick
- Belt loops: 19 long, 2.5 slot, 3 bar, 4 tall; one each side at the knuckle end and on the tongue   <- v1 was 30 long x 3 slot, sized for 25 mm Velcro; real strap is 11 x 1.1
- Strap opening: 13 x 2.5   <- 11 strap + 2 clearance; 2.5 lets the strap double back (2 x 1.1). v2 slot coupon also tests 2.0 and 3.0
- Shroud: 37.8 bore, 2.4 wall, 42 long, closed back, 5 top vent slots 2.4 wide,
  wire exit 10 x 9 in the back wall
- Shroud nipple groove: 6.5 wide at top center, from the mouth back 12 (assumes the
  head sits flush at the back wall). Spec depth 3.2 radial exceeds the 2.4 wall, so
  it is a through-slot, doubling as the feed-line exit   <- in v3; nipple stands ~3 proud and reaches ~9 into the shroud, 12 gives margin
- Shroud inside under the axis: 26 wide box   <- guess; the rear bracket is not measured
- Rear rails: 2 x (20 x 4 x 4.5), 18 apart   <- guess, same reason

## Print Settings

v1 (suggested, not yet printed): PLA, 0.4 nozzle, 0.2 layers, 3 walls, 15% infill.

| File | Orientation | Supports |
|---|---|---|
| `versions/archive/bubble-housing-v1-base.stl` | Plate down, as exported | Tree, build plate only: the underside arches about 2.6 mm |
| `versions/archive/bubble-housing-v1-shroud.stl` | Back wall on the bed, open end up | None |
| `versions/archive/bubble-housing-v1-clip-coupons.stl` | Flat | None. Bumps on the back: 1 = 37.6, 2 = 37.8, 3 = 38.0, 4 = 38.2 bore |
| `versions/archive/bubble-housing-v1-slot-coupon.stl` | Flat | None. Slots left to right: 22 x 3, 27 x 3, 27 x 4 |

v2 (suggested, not yet printed): same settings as v1. Only the base and slot coupon changed; shroud and clip coupons stay v1.

| File | Orientation | Supports |
|---|---|---|
| `versions/archive/bubble-housing-v2-base.stl` | Plate down, as exported | Tree, build plate only |
| `versions/bubble-housing-v2-slot-coupon.stl` | Flat | None. Slots left to right: 13 x 2.0, 13 x 2.5, 13 x 3.0 |

v3 (suggested, not yet printed): same settings as v1. Base clip bore moved to 37.6
(coupon 1 result); shroud gains the feed-nipple groove. Slot coupon stays v2, clip
coupons stay v1.

| File | Orientation | Supports |
|---|---|---|
| `versions/bubble-housing-v3-base.stl` | Plate down, as exported | Tree, build plate only |
| `versions/bubble-housing-v3-shroud.stl` | Back wall on the bed, open end up | None. The groove is the rim notch at the mouth; head goes in nipple-up, into the notch |

### Gun front housing, direct print (cut 2026-10-13, not yet printed)

The gun's own front housing (blower pocket section), cut out to print as-is.
**Adopted as the new housing direction (darknetdoll, 2026-10-13); no fit coupon —
the full halves print directly** (also darknetdoll, 2026-10-13).
Script: `reference/bubble-gun-toy/cut_front_housing.py`. Output
STLs and check views stay in `reference/bubble-gun-toy/front-housing/` (gitignored —
derived from the no-redistribution model; regenerate with the script).

- Cut plane: the front face of the bottom (bottle-bay) opening, 61.0 behind the ring
  face. Everything behind it dropped; the cap closes the cut, the old hatch front wall
  becomes the back wall. Its oblong pass-through is kept open (candidate wire exit)
- Re-clocked −90° about the barrel axis, muzzle view clockwise (darknetdoll's ask):
  - front screw seats 12:00 & 6:00 → **3:00 & 9:00**; screws now drive vertically
  - clamshell split x = 0 → horizontal: **02_Body is the top lid, 01_Body the cradle**
  - rotation direction chosen so the feed-nipple groove lands ~1:30 (top half, clear
    of the hand); the other direction would have put it at ~7:30, against the mount
  - side slots land at 12:00 & 6:00; air-slot rows land around 3:00
- Halves kept separate, both watertight. Each ~60.5 × 61.0 × 22.4; 22.8 + 18.3 cm³
- **Screws (4 × BT2×8):** Bambu Makers Supply "BT2x8 SHCS Self Tapping Screw", product
  AA019, 20-pack $1.09 (US store, confirmed 2026-10-14). M2 × 0.8 pitch × 8 long,
  Ø 3.5 head, H1.5 hex drive, carbon steel, for printed parts. 2 go in the front
  through-holes (3:00/9:00), 2 in the Ø 1.7–1.8 × 8–8.6 blind pilots (depth matches
  the 8 mm screw exactly). Button-head variant exists (BHCS, AA129) if the Ø 3.5
  cap head reads too tall on the seam. Amazon substitute (found 2026-10-14): uxcell
  M2×8 hex-socket-cap self-tapping, 304 SS, Ø 3.5 head same as the BT —
  black: 50 pc B0D4F1JBHP $5.79 / 200 pc B0D4F1QZF5 $8.89;
  silver: 15 pc B0D4DZM86C $5.09 / 100 pc B00YBMRAH4 $7.99 / 200 pc B0D4DXS2SK $8.29

| File | Orientation | Supports |
|---|---|---|
| `front-housing/front-housing-bottom-01.stl` | Split face on the bed (∩), as exported | Tree, in the bore tunnel |
| `front-housing/front-housing-top-02.stl` | Split face on the bed (∩), as exported | Tree, in the bore tunnel |

Suggested: PLA, 0.4 nozzle, 0.2 layers, 3 walls, 15% infill (the v1 defaults).

#### Velcro strap slots (2026-10-21, not yet printed)

Script: `reference/bubble-gun-toy/velcro_slots.py`. Same cut and clocking as above;
outputs `front-housing/front-housing-velcro-{bottom-01,top-02}.stl` and the preview
`front-housing/velcro-slots.png` (all gitignored).

- The single 3.8 x 30.5 slot at 12:00 (lid) and 6:00 (cradle) is filled and replaced
  by two strap slots with a bar between: strap goes down one, under the bar, up the
  other   <- one slot gave the strap nothing to wrap round (darknetdoll, 2026-10-21)
- Slot: 13 along the axis x 2.5 across   <- same as the strap opening spec: 11 strap + 2; 2.5 lets it double back
- Bar: 4 wide, on the old slot's raised rim (2.7 thick)
- Slots run 20 -> 33 behind the ring face   <- stops short of the cradle's internal ribs (start 34 behind)
- Strap passes under the bar inside the bore, between the bar and the head

## Log

### 2026-10-12 — v3 base + shroud printed (fail)

- The blower head does not go in
- Cause: clip and shroud both used the gun's front-lip bore (37.8, then 37.6) for the
  whole head. The gun uses that size only for the first 13.5 (the ring), then opens to
  39.4 for 38 more, with side slots (3.8 × 30.5) and a top recess. The clip sat 8–16
  behind the ring face, across the ring-to-body step
- Next: v4 sized from the real body. Readings go in the "Measure for v4" table in the
  fit-measurements doc (M1–M6, R1–R4, plus where v3 stopped)

### 2026-10-08 — clip coupon fit test (partial)

- Coupon 1 (one tick, 37.6 bore) holds the ring best of the four. Spec moved from
  37.8 to 37.6: the gun's 37.8 is an injection-molded fit, and our printed bores
  come out looser at the same number
- Found a feed nipple on top of the head that v1's clip and shroud ignore. Checked
  the gun reference: its pocket has a matching groove the 15° bore table had stepped
  over — ~6 wide, 3 deep, from just behind the muzzle face back to the top recess
  (now a Ground Truth row). Clip opening must clock over it; shroud needs a groove (see Spec)

## Open

- **v1/v2 fit test, remaining checks:** which v2 slot takes the Velcro flat; whether
  the plate rocks on the hand; whether the clip or the ring hits the knuckles when
  the fingers curl; whether the blower's rear fits inside the shroud and its rails.
  (Clip coupon: answered 2026-10-08, see Log)
- **Feed nipple:** confirm its clock position relative to the wire exit when the head
  lies in the saddle (photo suggests top-front; the gun clocks it 44° off top). If the
  gun envelope turns out tight, caliper the nipple directly
- **Cuff interaction** ([DESIGN.md](../../DESIGN.md) "The wrist cuff"): the cuff's lower
  ruffle drapes over the tongue and its strap. At the fit test, confirm the hem stays
  clear of the shroud's top vent slots and the ring, fingers curled and straight
- **Kit blower head, still to measure (blocks v4):** M1–M6 and R1–R4 in the fit-measurements
  doc's "Measure for v4" table: ring section length, body OD, width across the side
  tabs, height over the nipple, nipple position, tab length, rear bracket size and offset. Front OD and length are done (B1, B2)
  and match the gun's pocket to within 0.4 mm
- **Hand:** re-take H4 with the display visible; confirm the jaw landmarks for H1–H3;
  measure hand thickness at mid-hand and at the knuckles
- What the 3.8 × 30.5 side slots are for (clips? wire exit? airflow?). Look at the
  kit head
- Does the bubble ring sit inside the Ø 37.8 lip or proud of the muzzle?
- Mount A vs Mount C ([BUILD.md](../../BUILD.md) step 7). The gun runs a 50–70 mm
  hose; Mount C needs about 150 mm
- **Mount direction change (darknetdoll, 2026-10-12):** the housing is to sit on a
  TPU wrist splint via velcro ([wrist-splint-mount.md](../wrist-splint-mount/wrist-splint-mount.md))
  instead of strapping directly to the hand. The plate underside curve, tongue,
  and belt loops may be superseded — decide at the first stack fit test whether
  v4 drops them. Until then the v3 exports stand
- Material, wall, intake pattern for the floral shell: UNKNOWN
- **Velcro slots:** the strap runs under the bar inside the bore (r 19.7), so it
  needs ~1.1 of room between the bar and the head body. Body OD there is M2 (not
  measured). If the head won't go in over the strap, move to an outside strap loop.
  Also: these slots fill the old 3.8 slots, which may be for the head's side tabs
  (see below)
- **Gun front housing direct print:** confirm the −90° re-clock reads right on the
  markup artifact (nipple groove ~1:30, screws 3/9, split horizontal) before slicing;
  decide whether the 6:00 side slot and the back-wall pass-through serve as wire exits
  or get plugged
