darknet-doll/clown/3d-prints/wrist-splint-mount/reference/ATTRIBUTION.md

# Reference attribution

`wrist-splint-custom-moldable-print_files/` (and the model STL once added) are
**"Wrist Splint (Custom Moldable)" by JordanBurghoff**, Printables model
1238124 (printables.com/model/1238124-wrist-splint-custom-moldable),
published 2025-03-22.

License: **CC BY-NC-SA 4.0** (Attribution–NonCommercial–ShareAlike,
creativecommons.org/licenses/by-nc-sa/4.0/).

- Redistribution here (public repo) with this attribution: allowed
- Our remixed splint-mount parts derived from it inherit CC BY-NC-SA 4.0
- Non-commercial use only

The author's disclaimer applies: not a medical device. We use it as a wearable
mount base, not as a splint.

Local-only (gitignored): `wrist-splint_02mm_pla_mk3s_4h53m.gcode` — the
author's pre-sliced MK3S print file, kept for reference but unusable on the
X1C and 7.8 MB; re-downloadable from the model page.
