darknet-doll/clown/docs/pcb/pod-pcb-build.html

# Pod PCB Build

Arm 1 Arm 2

Keep screen on

FRONT · white outlines · part goes in here

BACK · “CLOWN POD rev A” · solder here

Turned over like a page: the XIAO end is now on the right. Pulsing rings = this step’s joints. Silver cones = joints already done.

This step Fitted Not yet Red probe Black probe

All steps
