darknet-doll/clown/Clown-Build-Manual.pdf

clown — bubble sleeve — parts | Page 1

# CLOWN

### Bubble-shooting sleeve — build manual

Squeeze your fingers into your palm and a comet of light runs from your upper arm down to your fingertips, arriving exactly as bubbles start firing out of your hand. Two arms, two identical rigs, one trigger per hand.

Every part is numbered; the assembly steps refer back to those
numbers in [brackets]. Each part carries two quantities — per arm, and what to actually buy for the whole costume. They are different numbers. Confusing them is how people end up halfway through a build with one glove.

Already on hand — and what is left

Two bubble kits [1] are here, so the two protected cells [12], the two chargers and the two lever microswitches
[20] that ship inside them are covered too. So are the passives — 100k [16], 1000 uF [17], 330-470 ohm [19] — and both protoboards [29].
Still to buy: two bottles [2] (24T/30T neck, not in the kit) and two of every remaining electronic part. The arms are independent; nothing is shared.
Deciding later: the glove [6] and sleeve [7]. Buy one, test the fabric lit in a dark room, then buy the rest. Deliberately skipped: spare cells, a bought battery sled
[13] and the cell storage case [39]. See those entries for what that costs.

THE BUBBLES

### 1. Bambu Lab Electric Bubble Maker Kit 01 (P6M) — 1 per arm ·

buy 0 — 2 on hand
A blower head, a one-way-valve bottle cap, silicone hose and a gravity ball. You are not modifying how it makes bubbles — only taking over the decision of when. Each kit also includes a protected cell [12] on a PH2.0 pigtail and a matching USB charger. The bottle is not included.

### 2. Bottle, 24T or 30T neck — 1 per arm · buy 2 + a spare

The reservoir the kit's cap screws onto. Bambu says explicitly: not a drinking bottle. Choose the size deliberately — a full bottle is the heaviest single item on your arm, so this is your main lever on how tiring the costume is.

### 3. Silicone tube, 3 x 5 mm — buy 1 m

Same size as the hose in the kit. You need it for the mount test in Step 7, which decides where the bottle lives. Stock aquarium tubing; costs almost nothing. Keep the offcut as a field spare.

### 4. Bubble solution — buy all you can carry

This runs out long before the battery does. It is the actual limit on your night. THE LIGHT

### 5. WS2812B LED strip, 60 LED/m, 5V, black PCB, IP65 — 0.5 m

per arm · buy 1 m roll
A ribbon where every single light has its own chip inside, so each one takes orders individually down one data wire. That is the only reason a travelling comet is possible — an ordinary strip can only be one colour at a time. IP65 is the clear silicone sleeve that keeps the soap out. Two arms take 54 pixels (6 + 15 + 6 each), so a 1 m roll covers both with 6 to spare. Check the reel's ends: many ship with a JST-SM 3-pin [21] already fitted.

### 6. Thin, pale, stretchy glove — 1 per arm · buy a pair — deciding

later
The hand strip hides under this. Fabric spreads the light into a smooth glow instead of visible dots — but only if it is thin and pale. Thick or dark fabric, especially leather, swallows almost all of it.

### 7. Sleeve or arm warmer — 1 per arm · buy a pair — deciding

later
Same job as the glove [6], for the forearm segment. Same fabric rules. Buy both at once and test them together — a glove that glows over a sleeve that does not is a half-lit arm.

THE BRAIN

### 8. Seeed XIAO ESP32-C3 — 1 per arm · buy 2

A complete computer the size of a postage stamp. It watches its own arm's trigger and decides what all 27 lights do, about 60 times a second. You reprogram it over USB-C — with a data cable [36], not a charge-only one.
9. 74AHCT125 level shifter — 1 per arm · buy 2 (get 5)
A translator that also shouts. The brain speaks at 3.3V; the strip is listening for 5V. Usually the strip sort of hears it anyway — which is exactly the problem. Leave this out and your lights flicker randomly, normally for the first time once you are in costume.
MOTOR CONTROL

### 10. N-channel logic-level MOSFET — 1 per arm · buy 2

An electric switch with no moving parts. The brain can think, but it cannot push enough power to spin a motor, so it flicks this instead and this lets the big current through. Do not buy an IRF520 module — it is the top search result and it is not logic-level, so at 3.3V it only half-opens and gets hot. Prefer AO3400, or drive the gate at 5V through a spare gate on the 74AHCT125 [9], which is what Step 4 does. Whatever you buy, it needs a 10k gate-to-source pulldown — without one the gate floats while the board boots and the blower twitches at every power-up. Bare transistors do not have one; most modules do not either. Meter it and fit one if it reads open.
11. 1N5819 diode — 2 per arm · buy 4 (get 10)
A one-way valve for electricity, and you need two per arm doing two different jobs. CR1: a motor is really just a coil of wire, and cutting power to a coil makes it kick a nasty voltage spike backwards — CR1 gives that spike a safe loop to burn itself out in, at the blower end, banded leg to positive. Skip it and the MOSFET [10] eventually dies. CR2: the XIAO's [8] 5V pad is wired straight to its USB-C port, so with the cell [12] connected the boost [14] would feed whatever you plug in to reflash from — CR2 sits between boost and XIAO, banded leg to the XIAO, and stops that. They are called CR and not D because the XIAO already has pins named D1 and D2, and one of those pins is what drives the MOSFET CR1 protects.
POWER

### 12. Protected 18650 cell — 1 per arm · buy 0 — 2 in the kits

A rechargeable battery — one comes free with each bubble kit [1], already on a PH2.0 pigtail. Keep that pigtail: it is what the kit's charger mates to, so a flat cell swaps pod to charger with no adapter. Protected means a guardian circuit cuts it off before you over-drain it, and the firmware shuts the arm down at 3.0V so that circuit never has to act. Never substitute unprotected cells. This is strapped to your arm. There are no spares: two cells came with the two kits and none were bought, so a flat cell ends that arm for the night. Charge both full that morning and kill the disconnect [38] between sets. Any cell that ever travels loose goes in a case [39] — the whole can of an 18650 is its negative terminal and the thin wrap is all that covers it.

### 13. Printed cell cradle — 1 per arm · buy 0 — you print it

Not a sled. The cell [12] already leaves the factory on a PH2.0 pigtail, so it needs no spring contacts and no solder tabs — only a printed pocket that holds it still, with a lid that clicks shut and opens without a tool. Getting the cell out fast is a safety feature, not a convenience. The cradle grips the cell, never the pigtail: if the cell can shift, the crimp is what eventually fails. A bought sled stays the fallback if a pigtail is ever torn.
14. 5V boost converter module — 1 per arm · buy 2
A pump, but for voltage. The battery only makes about 3.7V and the lights and brain need 5V. Here it only has to carry the lights (~0.3A) because the motor runs straight off the battery, so a small cheap one is genuinely fine.
15. 2A resettable polyfuse (PPTC) — 1 per arm · buy 2 (get 5)
A safety valve that resets itself. If something shorts out, it suddenly becomes very resistant and chokes the current off before anything gets hot. Let it cool and it goes back to normal by itself.
16. 100 kilo-ohm resistors — 2 per arm · buy 0 — 4 on hand
Two resistors that shrink the battery voltage neatly in half, so the brain [8] can measure it without being damaged. This is what lets the costume warn you that the cell is nearly flat instead of just dying.

clown — bubble sleeve — parts | Page 2

SIGNAL CONDITIONING
17. 1000 uF electrolytic capacitor — 1 per arm · buy 0 — 2 on hand
A tiny water tank for electricity. When a lot of LEDs switch on in the same instant they all gulp power at once; the tank smooths out the gulp so the voltage does not dip. Polarised — the leg with the stripe is negative, and backwards it pops.
18. 0.1 uF ceramic capacitor — 1 per arm · buy 2 — get an assortment
A second, much smaller capacitor that sits on the level shifter [9] itself, bridging its two power pins. The big one [17] is a water tank by the strip plug; this one is a cup of water held against the thirsty part. Every time the chip switches it gulps current in billionths of a second, and the tank is too far away to answer that fast. Not polarised — it goes in either way round. Marked 104 on the body. Costs about three cents; skipping it buys you flicker that only happens on the arm.
19. 330-470 ohm resistor — 1 per arm · buy 0 — 2 on hand
A speed bump on the data wire. It softens the sharp edge of the signal so it does not bounce back down the wire and garble the message to the first pixel. Skip it and pixel 1 misbehaves while all the others are fine.
THE TRIGGER

### 20. Snap-action lever microswitch — 1 per arm · buy 0 — 2 in the

kits
A clicky button with a little metal arm sticking off it. One per hand — each hand fires its own arm, and nothing crosses the torso. The arm is the whole point: a wide target you can hit mid-performance without looking. It also clicks, so you feel it go. One came in each bubble kit [1], so both arms are covered and there is no spare — a dead trigger ends that arm.
CONNECTORS — SO IT COMES APART

### 21. JST-SM pigtail pair, 3-pin — 3 per arm · buy 6 + 2 spares

The strip plugs: 5V, ground and data, nothing else. One at the pod, where the pod's J2 plugs straight into pixel 0 of the upper-arm strip, one at the elbow, where the strip crosses to the forearm (J6), and one at the wrist, where it crosses to the hand (J4). Same pin order on all three — identical on purpose, and that is safe: a cross-mate simply skips a strip segment. Check the strip reel [5] first; it may already carry some.

### 22. JST-SM pigtail pair, 4-pin — 2 per arm · buy 4 + 2 spares

The motor-and-trigger lead: motor +, motor −, trigger and trigger return. Both the trigger and the motor have to reach the pod from your hand, so both cross both joints — one SM-4 at the elbow (J3) and one at the wrist (J8), with the identical pinout; the sleeve passes the lead straight through. The motor is kept off the strip's plug on purpose — an amp of switched PWM bundled against a WS2812 data wire is asking for flicker. The trigger is a slow switch to ground and does not care.

### 23. JST-SM pigtail pair, 5-pin — buy 0 — retired

No longer used. The wrist originally crossed on one 5-pin; the design now splits it into the strip's SM-3 [21] and the motor-and-trigger SM-4 [22], so every wrist plug matches its elbow counterpart pin-for-pin.

### 24. JST-SM pigtail pair, 2-pin — 1 per arm · buy 2 + 2 spares

The motor's plug to the bubbler, now at the hand — it hangs off the glove side of the wrist SM-4, kept off the data line on purpose. The kit's motor lead is reworked onto this in Step 7.

### 25. JST-ZH pigtail pair, 2-pin, 1.5 mm — 1 per arm · buy 2 + 2

spares
Goes at the microswitch [20] itself, so a dead trigger is a ten-second swap rather than a soldering job. It must not be PH2.0. Every cell [12] ships on a PH2.0 lead, and one wrong plug in a dark room would put 3.7V straight onto GPIO3. ZH is 1.5 mm pitch, PH is 2.0 — they physically will not mate.

### 26. Dielectric grease — buy 1 small tube

Non-conductive waterproof goo. A smear in each connector shell stops soap residue corroding the contacts over a season. The alternative is intermittent faults you will chase for hours.

WIRE AND MATERIALS

### 27. Silicone hookup wire, 22-26 AWG — buy one assortment

Wire with soft rubbery insulation instead of stiff plastic. It survives thousands of bends. Ordinary wire — especially solid-core — snaps at the elbow and wrist within a few hours of wearing it. Thicker for power, thinner for signals.

### 28. Heat-shrink tubing, assorted — buy one assortment

Plastic sleeve that shrinks tight when heated, sealing and insulating each solder joint. Slide it onto the wire BEFORE you solder. Everyone forgets once.

### 29. Protoboard, small — 1 per arm · buy 0 — 2 on hand

The perforated board the pod's components sit on. Nothing exotic — a 4 x 6 cm piece per arm is plenty.

### 30. Hot glue, or clear RTV silicone — buy 1

Seals the cut ends of the strip [5] against soap. Easy to forget when ordering and annoying to be without at Step 3.

### 31. Needle and thread, or fabric glue — buy 1

For sewing the strip channels into the glove [6] and sleeve [7]. A channel the strip can slide inside — not glued down flat.

### 32. Fabric marker pen — buy 1

For marking where your finger pads land on your palm in Step 1. That mark is where the trigger [20] goes.
TOOLS — ONE EACH, NOT ONE PER ARM

### 33. Multimeter — buy 1

Not optional. Polarity before every first power-up, continuity for tracing a dead segment, and actual current draw. Minimum spec: DC volts, AC volts, DC current to 2A on a fused input, resistance, and continuity with a fast audible beeper — that beeper is what you will live in. Capacitance is worth having. Auto-ranging, backlight and hold, because you will be under a table.

### 34. Soldering iron, flux-core solder, flux pen — buy 1

Buy flux-core solder, 0.8 mm; solid wire with no flux is miserable. The flux pen is separate — the IP65 strip pads are the grubbiest joints here and want extra. On leaded vs lead-free: the fumes that make you feel ill are the flux, not the lead, so ventilate either way. The real lead risk is ingestion, closed by washing your hands. Lead-free needs a hotter iron and wets worse, which bites on strip pads; 63/37 is more forgiving. Either is defensible.

### 35. Thermal camera — buy 1 (borrow it)

Optional, genuinely useful. Turns Step 6's "touch it and see if it is warm" into a measurement, and catches what a fingertip misses: a boost [14] running hot from a short downstream, a MOSFET [10] that turned out not to be logic-level, a strip section drawing more than its neighbours. One borrowed session is plenty.

### 36. USB-C cable, data capable — buy 1

A charge-only cable looks identical and will cost you half an hour of confusion before you think to suspect it.
37. 3D printer — buy 1
For the trigger plate, the cell cradle [13], the controller pod and the bubbler mount. You already have one.

clown — bubble sleeve — parts | Page 3

SEALING, AND GETTING THE CELL OUT FAST

### 38. Battery disconnect switch, SPST — 1 per arm · buy 2

An ordinary switch in the cell's positive lead, ahead of the fuse [15], so one motion through the costume kills the arm without opening the pod. Rated 3A or more at DC — small switches are usually specced for mains AC and far less for DC, so read the DC line. Get one with a rubber boot: it keeps its own seal and you can find it by feel in the dark. It does not replace pulling the cell [12]; it makes the pod safe to open and the arm safe to unplug.
39. 18650 storage case — buy 0 — no spare cells to carry
A hard box with a slot per cell, so a cell cannot short against keys, coins or another cell. Skipped only because no spares were bought; buy one the day that changes. Check every cell's wrap before every event and re-wrap any that are nicked.

### 40. Conformal coating, clear acrylic spray — buy 1 can

A thin lacquer over the finished board that turns a soaked pod into one you rinse, dry and keep using. Mask the USB-C port, the boost trimpot [14], the MOSFET tab [10] and every connector first. Two thin coats. Do it after the bench test passes, not before — reworking a coated board is miserable.

### 41. Self-amalgamating silicone tape — buy 1 roll

Tape with no adhesive: it fuses to itself. One wrap over each mated connector keeps soap out of the shell, and it comes off in one piece leaving no residue, which matters on something you unplug every night.

### 42. Silicone O-ring cord 2 mm, or foam tape — buy 1

The actual seal between the pod and its lid, sitting in a printed groove. Foam weatherstrip tape works too and needs no groove modelled; it just survives fewer open-and-close cycles. Nothing sticky and permanent — you will be opening this.

### 43. M3 heat-set inserts 4.6 × 5.0 mm, and M3 × 8 mm screws — 4

+ 4 per arm · buy 1 kit
Inserts are M3 × 0.5 brass, 4.6 mm OD × 5.0 mm long; screws are M3 × 8 mm button head, A2 stainless — not the carbon-steel ones in the kit, which rust. Four of each per pod, so the lid screws shut and reopens without stripping the plastic. A gasket [42] only seals if something squeezes it evenly.

### 44. Rubber grommet or small cable gland — 1 per arm · buy 2 +

spares
Wires leave the pod through this, on the underside, not through a bare printed hole. A printed edge saws through silicone insulation [27] over a season, and the gap around it is the main way water gets in.

### 45. PETG filament — buy 1 spool

For the pod, lid, cradle [13], trigger plate and bubbler mount. Not PLA: PLA softens in a hot car and is brittle exactly where a strapped-on part flexes. Four perimeters and 1.6 mm walls minimum — thin FDM walls leak through the layer lines themselves, gasket or no gasket.

The one mistake that costs a board

The trigger pigtail [25] must not be PH2.0. Every cell
[12] ships on a PH2.0 lead, so an identical trigger plug is one wrong connection away from putting 3.7V onto GPIO3.

And rework the kit's motor lead [1] off PH2.0 to SM 2-pin [24]. As shipped, the cell mates straight to the motor — bypassing the MOSFET [10], so the trigger does nothing and the blower simply runs.

clown — bubble sleeve — assembly | Page 4

# Assembly

Read this whole manual once before picking up the soldering iron [34]. Several steps are much easier if you know what is coming — notably that heat-shrink [28] goes on before you solder, and that you bench-test everything before anything goes inside a glove [6].

Budget a full afternoon for the first arm. The second takes about half as long, because by then you know what you are doing.

### What you are building

Two arms. Each arm is four modules that unplug from each other. Nothing is soldered end to end across a joint — that is what lets you get out of the costume alone, with soapy hands.

Module | Holds | Unplugs at
Pod — upper arm | brain [8], boost [14], level shifter [9], MOSFET [10], fuse [15], disconnect [38], cradle [13], upper-arm strip [5] 6 px | switch [38] + battery plug + straps + elbow: SM 4-pin [22] + SM 3-pin [21]
Sleeve — forearm | forearm strip [5], 15 px | elbow: SM 4-pin [22] + SM 3-pin [21]
Glove — hand | hand strip 6 px, this hand's trigger [20] | wrist: SM 3-pin [21] + SM 4-pin [22]
Bubbler | bottle [2], cap, hose, blower head | hand: SM 2-pin [24] + its strap

Steps 1–11 build one arm. Step 12 is the second arm. Step 13 is the costume — the two arms together, and how you get in and out of it.

Safety, briefly but seriously

The cell [12] is lithium. Never short its terminals, never charge a puffy or damaged cell, and do not leave it charging unattended. Check polarity with the multimeter [33] before you connect the battery the first time — reversed power destroys the brain [8] and the strip [5] instantly and permanently.

You must be able to kill and remove the cell in seconds, one-handed. That is what the disconnect switch [38] and a tool-free cradle lid [13] are for. If getting the battery out needs two hands, a screwdriver, or taking a sleeve off first, the pod is not finished. There are no spare cells — two came with the kits and none were bought, so charge both full and kill the switch between sets. Any cell that does travel loose goes in a case [39], never a bag with keys.

Solder somewhere ventilated. The fumes are flux, not lead — unpleasant whichever solder [34] you bought.

The connector rule you will use constantly

Battery out before you mate or unmate anything. Feeding data into an unpowered WS2812 strip [5] pushes current through its input protection diodes, which is the classic way to kill pixel 0 — and that is exactly what happens if you plug the sleeve or the glove in while the pod is live. Unplug the cell [12] first, every time. It takes one second and becomes automatic quickly.

### Step 1 — Measure your arm

Put on the glove [6] and sleeve [7], strap the pod (or a stand-in the same size) where it will sit on your upper arm, and hold your arm out in the finger-gun pose. Measure and write down:
- Bottom of the pod to elbow crease, down the outside of the upper arm, with the pod strapped where it will actually sit — typically about 15 cm.
- Elbow to wrist crease — typically about 25 cm.
- Wrist crease to knuckles, across the back of the hand — about 10 cm.
- Where your middle and ring finger pads land on your palm when you squeeze. That is where the trigger [20] goes. Mark it with a fabric pen [32].
Convert the first three into pixel counts. At 60 LED/m each pixel on the strip [5] is 1.67 cm:

upper-arm pixels = upper-arm cm / 1.67
forearm pixels | = forearm cm / 1.67
hand pixels | = hand cm / 1.67

That is usually about 15 forearm pixels and 6 hand pixels. Round down. Then subtract about 4 cm from the forearm figure — the wrist umbilical and its connectors [21] [22] need to live in the last few centimetres of forearm, just above the crease where the skin barely flexes.
Subtract about 5 cm from the upper-arm figure, for the same reason — the elbow umbilical and its plug [21] live in the last few centimetres of upper arm, just above the elbow crease. A typical 15 cm becomes 10 cm, which is 6 pixels. That makes a typical arm 6 + 15 + 6 = 27 pixels. Keep these numbers; they go into the firmware in Step 8.

### Step 2 — Cut the strip

The strip [5] has marked cut lines between every pixel, with copper pads either side. Cut through the middle of the pads, not beside them — you need pad left on both pieces to solder to. Cut three pieces to the pixel counts from Step 1: upper arm (~6), forearm (~15) and hand (~6).

Check the arrows before you cut
The strip has small printed arrows showing which way data flows. Data must run pod → elbow → wrist → fingertips, so all three pieces need their arrows pointing the same way, toward your fingers. Getting this backwards is the most common build mistake and the fix is unsoldering everything. Mark the pod end of the upper-arm piece with tape — that end is pixel 0.
Why three pieces? Your elbow and your wrist bend constantly, and a single continuous strip across either joint cracks its internal copper traces within hours of wear. Everything past the crack then goes dark. The flexible umbilicals in Step 3 absorb that movement instead — one at each joint.

### Step 3 — Build the umbilicals

The strip crosses two joints, and each one gets a short flexible umbilical with a plug in it: the wrist umbilical (forearm piece to hand piece) and the elbow umbilical (upper-arm piece to forearm piece). Build the wrist one first; the elbow one is the same job with fewer wires.

When to solder, and when to wait

One rule for the whole build. One wire onto one pad or pin: solder it the moment you make it — shrink, seal, done. Every joint in this step is like that.

More than one thing landing on the same point: do not solder it yet. Park the branches mechanically — twisted through the pad, tacked — and flow solder the node once, after its last branch has arrived. A shared node soldered early means reheating a finished joint for every branch that comes later, and each reheat is a chance to lift a pad or cook a neighbour.

Where the shared nodes live: five on the pod (listed in Step 4) and two at the blower (Step 7). Everything else — umbilicals, pigtails, strip pads, the microswitch — is single-wire.
The wrist umbilical. Two plugs let the glove [6] come off on its own: a JST-SM 3-pin [21] for the strip, and a JST-SM 4-pin [22] for the motor and this hand's trigger — the same pinout as the elbow SM-4, so the sleeve passes those four conductors straight through. Keep both conventions identical on both arms.
SM-3 pin | Carries
1 | Strip 5V
2 | Strip GND
3 | Strip data
SM-4 pin | Carries
1 | Motor + (battery, after the fuse)
2 | Motor − (MOSFET output)
3 | Trigger
4 | Trigger return (to ground at the pod)
Wrist — sleeve side
- Slide heat-shrink [28] onto every wire now, before soldering.
- Solder short silicone leads [27] to the forearm piece's output end — 5V, GND and DO — then on to pins 1-3 of one SM-3 half.

- The wrist SM-4's sleeve half takes a four-wire run — motor pair twisted, trigger pair alongside — long enough to go all the way up the forearm to the elbow, where it lands pin-for-pin on the sleeve half of the elbow SM-4 [22] (below). 1 to 1 through 4 to 4; the sleeve is a straight pass-through.
- Shrink everything down, then seal the exposed strip end with hot glue [30] or clear silicone. That is the soap-proofing.
Wrist — glove side
- Solder pins 1-3 of the other SM-3 half to the hand piece's input end: 5V to 5V, GND to GND, pin 3 to DI.
- The glove half of the SM-4 splits in two. Pins 3-4 get two wires long enough to reach the palm, ending in the female half of a JST-ZH 2-pin [25] — that is where the microswitch plugs in at Step 5. Pins 1-2 get a short twisted pair ending in the half of a JST-SM 2-pin [24] that mates the bubbler's motor lead (Step 7): pin 1 to its motor +, pin 2 to its motor −. The bubbler now unplugs at the hand, next to where it is mounted.
- Shrink, and seal the strip end the same way.

Where the wrist connectors sit, and why

Mate both pairs 3-4 cm above the wrist crease, on the forearm. That skin barely moves; the crease itself is the worst possible place for a rigid 20 mm plastic body. The glove-side wire is the flex element — leave a service loop so it is never under tension at full extension.

Keep the whole umbilical short. Every centimetre between the last forearm pixel and the first hand pixel is dark arm the comet has
to cross. Around 8 cm is fine; 15 cm reads as a gap. Measure the finished pixel-to-pixel distance and write it down — it becomes GAP_PX in Step 8.
The elbow umbilical. This is the plug that lets the sleeve's strip come off the pod's strip. It carries three conductors — the strip's 5V, ground and data — on a JST-SM 3-pin pigtail pair [21] (J6 on the schematic), in the same pin order as the pod's own strip plug, on both arms.
SM-3 pin | Carries
1 | Strip 5V
2 | Strip GND
3 | Strip data
Elbow — upper-arm side
- Heat-shrink [28] on first.
- Solder short silicone leads [27] to the upper-arm piece's output end — 5V, GND and DO — then on to pins 1-3 of one SM-3 half. Shrink, and seal the strip end with hot glue [30] or clear silicone.
- The piece's input end — pixel 0, the end you taped — gets the mate to the pod's own SM-3 strip plug, J2, in the same pin order: 5V, GND, DI. Step 4 builds the pod side.
Elbow — sleeve side
- Solder pins 1-3 of the other half to the forearm piece's input end: 5V to 5V, GND to GND, pin 3 to DI. Shrink and seal.

Where the elbow connector sits, and why

Mate the pair a few centimetres above the elbow, on the upper arm, where the skin moves least — the crease is the worst place for a rigid plastic body, same as at the wrist. The sleeve-side wire is the flex element: leave it a service loop across the joint, so it is never under tension with the arm fully bent.

It comes out longer than the wrist one — typically around 12 cm pixel to pixel, against the wrist's 8 cm, because the elbow is the bigger joint. Measure the finished distance, last upper-arm pixel to first forearm pixel, and write it down — it becomes
ELBOW_GAP_PX in Step 8.
The sleeve half of the elbow lead. The motor and the trigger cross the elbow on their own plug, a JST-SM 4-pin [22], kept apart from the strip. The pod builds the other half in Step 4.
SM-4 pin | Carries
1 | Motor + (battery, after the fuse)
2 | Motor − (MOSFET output)

SM-4 pin | Carries
3 | Trigger
4 | Trigger return (to ground at the pod)
- All four pins take the four-wire run [27] coming up the forearm from the wrist SM-4 — pin-for-pin, 1 to 1 through 4 to 4. The sleeve carries nothing of its own on this lead; it is a straight pass-through from elbow to wrist.
- The SM-4 mates next to the SM-3, above the elbow, with the same service loop across the joint.
Test the joints now: gently tug each wire. Better to find a weak joint on the bench than inside a glove.

### Step 4 — Build the controller pod

This all lives on a small piece of protoboard [29] that sits on your upper arm. It used to say "above the soap spray" — Step 11 explains why that stopped being true and what the enclosure has to do instead.

From | To | Notes | Solder?
Battery [12] + (PH2.0) | Disconnect switch [38] | Kills the arm without opening the pod | now
Disconnect [38] out | Polyfuse [15], then everything else | Fuse next, before anything else | wait — VBATT node
Battery [12] − (PH2.0) | Common ground | Everything shares this | wait — ground bus
Battery + (after fuse) | Boost [14] IN+ | | wait — VBATT node
Boost [14] OUT+ (5V) | 74AHCT125 [9] Vcc, J2 strip SM-3 [21] pin 1 | Strip and shifter, straight off the boost | wait — +5V node, and the trim
74AHCT125 [9] Vcc (pin 14) | 0.1 uF ceramic [18], then 74AHCT125 GND (pin 7) | Decoupling — on the chip, see below | wait — closes with the rails
Boost [14] OUT+ (5V) | CR2 [11] anode; its banded leg to the XIAO [8] 5V pad | Isolation diode — see below | wait — anode on the +5V node
Battery + (after fuse) | J3 elbow SM-4 [22] pin 1 (motor +) | Motor runs direct from the cell, not from 5V | wait — VBATT node
J3 elbow SM-4 pin 2 (motor −) | MOSFET [10] output (drain) | | now
XIAO GPIO4 (silk D2) | 74AHCT125 [9] second gate input | Gate drive — see below | now
74AHCT125 [9] second gate out | 100 ohm, then MOSFET [10] gate | Plus a 10k gate-to-source pulldown | wait — R4/R5/gate junction
XIAO GPIO10 (silk D10) | 74AHCT125 [9] input | | now
74AHCT125 [9] output | Resistor [19], then J2 strip SM-3 pin 3 | Resistor at the connector end | now
J2 strip SM-3 pin 2 | Common ground | Strip ground return | wait — ground bus
XIAO GPIO3 (silk D1) | J3 elbow SM-4 pin 3 | Trigger, arriving from the hand | now
J3 elbow SM-4 pin 4 | Common ground | Trigger return | wait — ground bus
XIAO GPIO2 (silk D0) | Midpoint of the two 100k resistors [16] | Battery monitor | wait — VSENSE junction
74AHCT125 [9] 1OE, 2OE | Common ground | Enables the two gates you use | wait — ground bus
74AHCT125 [9] 3A, 4A | Common ground | Unused inputs — must not float | wait — ground bus

From | To | Notes | Solder?
74AHCT125 [9] 3OE, 4OE | 5V | Unused outputs off. 3Y, 4Y stay open | wait — +5V node

The five shared nodes — tack now, flow solder last

Every wait above lands on one of these. Park each branch mechanically and solder the node once, after the last branch listed here is in place — not branch by branch as you go. A "now" row is a single wire to a single pad: solder it the moment you make it.

Common ground: cell −, boost IN−, boost OUT−, XIAO GND, 74AHCT125 GND + 1OE + 2OE + 3A + 4A, MOSFET source, C1 −, C2, R2, J2 pin 2, J3 pin 4.
+5V: boost OUT+, 74AHCT125 Vcc + 3OE + 4OE, C1 +, C2, CR2 anode, J2 pin 1.
VBATT after the fuse: boost IN+, R1 top, J3 pin 1 (the motor tap).
GATE at the MOSFET: R4 out, R5 top, Q1 gate.
VSENSE midpoint: R1 bottom, R2 top, the GPIO2 wire.

The boost trim already forces part of the order: OUT+/OUT− touch nothing until the module reads 5.00V. Counting branches against this list is the wiring check — a node that closes with a branch missing is exactly the mistake this habit catches.

### Calibrate the boost module — do this first

It does not arrive at 5V

MT3608-style modules [14] ship set wherever the factory's screwdriver left them, often 15–20V. Wire one straight to the strip [5] and the brain [8] and you destroy both in the first second of power. Trim it on its own, with the output connected to nothing.
1. Leave the output open. OUT+ and OUT− go nowhere yet — not the level shifter [9], not CR2 [11], not J2 [21] / the strip. Fit the wires if you like, but leave their far ends loose.
2. Power the input only. Cell [12] + through the disconnect [38] and fuse [15] to IN+, cell − to IN−. A bench supply at 3.7V with its current limit at 200 mA is better still — then a wiring mistake cannot become a fire.
3. Meter [33] across OUT+ and OUT−, and read it before you turn anything.
4. Wind the trimpot counter-clockwise until the reading drops below 5V, then bring it up to 5.00V from underneath. Approach from above and every slip overshoots high, which is the direction that breaks things.
5. Expect a multi-turn trimpot — 20-odd turns end to end, and the first several may appear to do nothing. Keep going and watch the meter; do not force it past its stop. Some boards use a single-turn pot instead, where a few degrees is several volts. Clockwise raises the output on the usual boards, but trust the meter, not the silkscreen.
6. Anywhere in 4.95–5.05V is fine. Do not aim high for margin — above about 5.25V you are spending the strip's [5] headroom for nothing.
7. Check it still holds with a flat cell. Feed the input 3.0V and read the output again: it should still be ~5V. That is the condition you are in at the end of the night, and it is where a weak module gives up. One that sags to 4.5V here has a bad inductor or a cold joint — bin it, you bought ten.
8. Re-trim under load. Connect the strip [5] and shifter [9], light the strip at working brightness, and set it back to 5.00V with that load on. That is the number that matters. The brain [8] and CR2 [11] stay off until it reads right.
9. Lock the screw with nail polish or a dab of hot glue. It is a tiny trimmer on an arm that gets knocked all night, and it drifts.
Each arm has its own module and its own trimpot, so trim both — they will not land on the same screw position. And mask the trimpot before conformal coat in Step 11: coating over it locks the setting and turns any future retrim into a scraping job.

Drive the MOSFET gate at 5V, not 3.3V

The XIAO [8] swings its outputs to 3.3V. Most "logic-level" MOSFETs are specified fully on at Vgs = 5V — at 3.3V they only partly open, dissipate the difference as heat, and the blower runs slow and inconsistent.

The 74AHCT125 [9] has four gates and the strip only uses one. Route GPIO4 through a second gate, exactly as you route the LED data through the first. Add a 100 ohm resistor in series with the gate and a 10k pulldown from gate to source, so the FET is held off while the board boots. It costs nothing — the chip is already in the pod.

Do not use an IRF520 module. It is the top search result for "Arduino MOSFET module" and it is not logic-level: its gate threshold runs to 4V and it wants ~10V to open properly. It half-works, which is harder to diagnose than not working at all.

Tie off the two gates you are not using

The 74AHCT125 [9] has four gates and you use two. The other two are not spare parts. They are inputs, and a CMOS input must never be left floating.

A floating input sits wherever stray charge leaves it, usually near the switching threshold. The gate then oscillates, and the chip dissipates real power doing it — tens of milliamps instead of microamps, as heat, continuously, out of a battery strapped to your arm. It also couples noise into the two gates you do care about.

3A and 4A go to ground. 3OE and 4OE go to Vcc, which disables those outputs — OE is active low. 3Y and 4Y go nowhere at all: they are outputs, so leave them open and never tie an output to a rail.

On the DIP-14 part the pins run 1OE, 1A, 1Y, 2OE, 2A, 2Y, GND up one side and 3Y, 3A, 3OE, 4Y, 4A, 4OE, Vcc back down the other. Check the datasheet for the package you actually bought — a breakout board renumbers everything. Four short wires, routed while the chip is going in — they flow-solder with the buses they land on.

Decouple the 74AHCT125 at its own pins — fit C2

A 0.1 uF ceramic [18] across pin 14 (Vcc) and pin 7 (GND), legs cut short, sitting on the chip [9]. Not near it — on it.

Every time a gate switches, the chip pulls a burst of current out of its supply pin in a few billionths of a second, and that charge has to come from somewhere close. The ceramic is a small store right at the pins, so the chip's own 5V does not dip each time it drives an edge.

The 1000 uF [17] does not cover this. That one is bulk storage for the strip, sitting at the strip connector (J2), and between it and the chip is a run of protoboard wire. Different job, different capacitor — fit both. The ceramic is not polarised, so it goes in either way round.

Short legs is the whole point: on 30 mm of leg it is mostly wire. Fit it straddling the two pins; it flow-solders when the +5V and ground nodes close, since it shares pins 14 and 7 with the rails. The XIAO [8] and the boost module [14] came decoupled already — the bare chip is the one part in the pod that did not.

Two things that hold the blower off when nothing is telling it to run

The 10k gate-to-source pulldown is not optional. Between the moment the board resets and the first line of firmware, the gate pin is an input and floats, and a floating gate holds its last charge. The failure looks like the blower twitching, or briefly running, every time you power up or reflash — with the code doing nothing at all. Bare transistors do not include one. Modules mostly do not either: meter gate to source with the board unpowered. A few k is fine; open means fit your own.

The firmware also drives the pin low as the very first thing it does, but that is belt to the resistor's braces — it cannot act before it runs.

Isolate the XIAO's 5V pad — fit CR2

The XIAO's [8] 5V pad is wired straight to its USB-C VBUS. There is no diode on the board. So with the cell [12] connected and a USB cable plugged in, your boost [14] output is sitting on the host port — a laptop, a phone charger, whatever you reflash from.

Fit a 1N5819 [11] between the boost output and the XIAO's 5V pad, banded leg (cathode) to the XIAO. Current flows boost → XIAO and nothing flows back. It costs about 0.3V, so the XIAO sees ~4.7V, comfortably inside its regulator.

Only the XIAO goes behind the diode. The strip [5] and the level shifter [9] stay on the boost output directly, at a full 5V — they are the load that cares.

Fit the master disconnect — SW1

The switch [38] goes in the cell positive, between the battery plug and the fuse [15], so it kills everything downstream including the motor tap and the boost [14].

Mount it so you can reach it through the costume, one-handed, without opening the pod, and label which way is off. Standing in the dark unsure whether you just switched it off is the failure this part exists to prevent.

It does not replace pulling the cell [12]. It makes the pod safe to open and the arm safe to unplug in one motion; the cell still comes out for storage, for charging, and any time something is actually wrong.

### The pod's two outward plugs

Everything the pod sends down the arm leaves through exactly two connectors. The data resistor [19] stays on the pod board, feeding J2 pin 3.

Plug | Pins
J2 — SM 3-pin [21], to the upper-arm strip | 1 strip 5V · 2 strip GND · 3 strip data (after the resistor)
J3 — SM 4-pin [22], the elbow lead | 1 motor + (battery, after fuse) · 2 motor − (MOSFET drain) · 3 trigger (GPIO3) · 4 trigger return / ground
- J2 plugs straight into the upper-arm strip, right at the pod. Pixel 0 is the first thing the data reaches.
- J3 is a 4-conductor lead run from the board down the upper arm to the elbow, where its SM-4 plug mates the sleeve (Step 3). Twist the motor pair.
- J3's pigtail comes pre-crimped: pin 1 blue, pin 2 red, pin 3 green, pin 4 black. The colors are not a polarity code — red is motor −. Go by pin number.
- The strip and the motor do not share a plug, on purpose. Roughly an amp of switched PWM bundled against a WS2812 data line is asking for flicker. The trigger rides with the motor instead — it is a slow switch to ground and does not care.
- The strip's ground return is SM-3 pin 2, at both the pod and the elbow. Make those joints properly — on a three-wire run there is nothing else to cover for a bad one.

Three SM-3s and two SM-4s on one arm, and why that is allowed

No two connectors on one arm share family and pin count, so nothing mates where it should not — with two exceptions: PH-2 · ZH-2 · SM-2 · SM-3 (×3) · SM-4 (×2).

Both exceptions are safe by construction. The three SM-3 strip plugs [21] — the pod's J2, the elbow J6 and the wrist J4 — all carry the same strip nets in the same pin order, so a cross-mate just skips a strip segment; nothing is damaged. The two SM-4 motor-and-trigger plugs [22] — the elbow J3 and the wrist J8 — carry the same four nets in the same pin order, so a cross-mate skips the sleeve pass-through and nothing else. Keep the pin orders identical everywhere and it stays that way.

### The battery monitor divider

Battery + (after fuse) —[100k]—+—[100k]— Ground
| XIAO GPIO2
The midpoint sits at exactly half the cell voltage, which is safely inside what the brain [8] can measure.

### Also fit

- The 1000 uF capacitor [17], C1, across the strip's 5V and ground at the strip connector J2 [21] on the pod — stood upright beside J2's edge pads, its two legs feeding J2's 5V and GND directly. Watch polarity — the striped leg is negative.
- The 1N5819 diode [11] directly across the motor's two terminals at the blower end, banded end to positive. Backwards it is a dead short, so check this one twice.

Keep the cell on its factory plug

The 18650 [12] arrives on a PH2.0 pigtail, and the kit's USB charger mates to the same connector. Fit the matching half at the pod and you get a clean swap: pull the flat cell, plug it straight into the charger, plug a fresh one in. No adapters, no rework.

PH2.0 must be the only PH connector in the whole build. See Step 5.

Three rules that matter

1. Everything shares one common ground — brain [8], strip [5], level shifter [9], MOSFET [10], boost [14] and cell [12]. Skipping this causes bizarre, hard-to-diagnose behaviour.
2. Do not use GPIO8 or GPIO9 (silk D8/D9) for anything. They are boot pins and the board will not start reliably.
3. Leave the USB-C port reachable when you design the printed pod, and use a data-capable cable [36]. You will reflash this far more often than you expect.

### Step 5 — Wire this hand's trigger

Each hand has its own trigger, firing its own arm. Nothing crosses the torso. You are wiring one of two identical, independent triggers.
- Solder two lengths of thin silicone wire [27] to the microswitch's COM and NO (normally open) terminals.
- Terminate them in the male half of a JST-ZH 2-pin [25] — the mate to the one you left on the glove side of the umbilical in Step 3.
- Mount the switch [20] on a small printed plate [37], positioned so the lever sits under your middle and ring finger pads at the spot you marked in Step 1.
Both joints here are one wire onto one terminal — solder them now, shrink, done.

Orient the lever so a natural squeeze presses across its length. You should be able to fire it with your eyes closed, in one motion, every time. If you catch yourself aiming, reposition the plate until you do not.
Why the switch gets its own tiny plug: the field kit carries a spare microswitch. Without this pigtail, "spare" means "spare, if you also brought a soldering iron." With it, swapping a dead trigger mid-event is a ten-second job.

Why ZH and not PH

The trigger pigtail must not be PH2.0. Every cell [12] in this build ships on a PH2.0 lead. If the trigger used the same connector, one wrong plug in a dark room puts 3.7V directly onto GPIO3 — a dead pin, quite possibly a dead XIAO [8].

JST-ZH [25] is 1.5 mm pitch; PH is 2.0 mm. They physically will not mate. That incompatibility is the entire reason for the choice — do not "simplify" it later by standardising on one connector.

### Step 6 — Bench test, before anything goes in the glove

Do not skip this step

Sewing everything into a glove [6] and then discovering a reversed data arrow is genuinely miserable. Test it flat on the table first,
with every connector mated.
- Before any power: meter gate to source on the MOSFET [10]. A few k, not open. Open means the pulldown is missing and the blower will twitch at every boot.
- Before any power: check both diodes [11]. CR1 banded leg to motor +, at the blower end. CR2 banded leg to the XIAO [8]. CR1 backwards is a dead short across the cell through the MOSFET, so check that one twice.
- Beep through every connector, pin by pin. A pigtail with a crimp that did not seat looks perfect and works intermittently. Find it now, not at the venue.
- Check polarity with the multimeter [33]. Battery + and − where you expect, and the boost [14] output at 5.00V — it was trimmed back in Step 4, before the brain [8] was ever connected. If it is not ~5V, unplug the brain and go retrim it.
- Confirm CR2 is doing its job: boost output ~5.0V, XIAO 5V pad ~4.7V. That 0.3V step is the diode. The same reading on both sides means you shorted past it.
- Power up. You should get the dim breathing idle glow.
- Watch the blower as it powers up. It must not twitch. If it kicks, stop: floating gate.
- Press the microswitch [20] by hand. The comet should launch from the pod end, cross the elbow, and travel to the fingertip end, and the motor should spin.
- If the comet runs backwards, the strip pieces are reversed. Fix it in the wiring, not in the code — both arms run identical firmware and that is worth a resolder.
- Let it run five minutes, then check for heat.

Test the low-voltage shutoff, once per arm

Do it on the bench once, so you recognise it in the field and know it works. Feed the pod 2.95V from a bench supply in place of the cell [12]: within about six seconds the elbow pixel — the first forearm pixel — starts a slow double blink, the motor stops, and the trigger does nothing. Wind up to 3.7V and it comes back. No bench supply? Run an arm flat — tedious, but it also measures your real runtime.

Single slow pulse = warning (swap soon). Double blink = shut down (swap now). They are deliberately different at a glance. Do not lower the cutoff to squeeze out more runtime: under 3.0V you are trading cell life for a couple of minutes of bubbles.

Checking for heat

Touch the boost [14] and MOSFET [10]. Warm is fine; too hot to touch means power down and look for a short.

If you can borrow a thermal camera [35], use it here instead. It turns this from a fingertip guess into a measurement, and shows you what a fingertip misses: a boost running hot because something downstream is shorted, a MOSFET that turned out not to be logic-level and is dissipating the difference, or a strip section drawing more than its neighbours. One borrowed session is plenty.

### Step 7 — Fit the bubbler

First, understand what you actually have. The kit [1] is not one object — it is a bottle [2], a cap with a one-way valve, and a blower head, joined by silicone hose:
- ~50 mm of hose inside the bottle, ending in the blue gravity ball. The ball sinks, so the pickup stays in solution at any arm angle — even inverted.
- ~50-70 mm of hose outside the cap, feeding the blower head.
So the heavy thing (the bottle) and the thing that must point past your fingertips (the blower head) do not have to be in the same place. That opens up a much better mount — if the blower can pull solution far enough.

The hose test — do this before you commit to a mount
Twenty minutes, one length of 3 x 5 mm silicone tube [3], and it decides the whole mount design. Do it the day the kit arrives, before any of the soldering above.
1. Assemble the kit as supplied and confirm it makes bubbles.
2. Replace the outside hose with about 150 mm of 3 x 5 tube.
3. Run it again, held roughly the way your arm will hold it.

Does it still make bubbles at the same rate?

If it PASSES — Mount C | If it FAILS — Mount A
Bottle on the forearm, blower head at the knuckles pointing past your fingertips. Bubbles still appear to come from your fingers, so the comet illusion is intact — and the heaviest item on the arm moves off the end of the lever, where it was costing you most. This is the better build if you can get it. | Bottle and blower head both on the back of the hand, exactly as the kit intends, nozzle past the fingertips. Works as shipped, no modification, no risk. Manage the weight instead: run the bottle half-full (you carry refills anyway); mount the bottle body back toward the wrist with the cap forward, to shorten the lever arm; and anchor to a wrist strap, not glove fabric — a glove will not hold 200 g swinging for an evening.

Either way
- Check MakerWorld for existing mounts from the kit's collection as a starting point. Community CAD for the cap thread and the blower sleeve already exists.
- The bubbler is its own module. Give it a quick-release strap, and make sure nothing about its mount bridges the wrist — a rigid bottle spanning that joint means the glove [6] cannot come off without removing the bottle first.
- Rework the motor lead. The kit ships the motor on a PH2.0 female plug that mates straight to the cell [12]. Cut it off and fit a JST-SM 2-pin [24]. This is not cosmetic: leave it and the cell can power the motor directly, bypassing the MOSFET [10], and the trigger does nothing.
- The blower end is the build's other two shared junctions — gather everything before soldering. Each motor terminal takes three things at once: the motor lead, a leg of CR1 [11] (banded end on +), and one wire of the SM-2 pigtail [24]. Do not solder the pigtail and come back for CR1 later — make each terminal one joint with all three in it.
- Use silicone wire [27] for the motor run; it flexes constantly.
- A longer hose holds more solution, so dribble on shutdown gets slightly worse. The silicone sleeve over the cap's protrusion — the one-way valve — is what stops it emptying into your bag.

### Step 8 — Flash the firmware

- Install the Arduino IDE, then add ESP32 board support (Boards Manager, search esp32, install the Espressif package).
- Install the FastLED library from the Library Manager.
- Select board XIAO_ESP32C3.

- Open firmware/clown_arm/clown_arm.ino.
- Edit the layout constants at the top to match your measurements.
- Plug in USB-C [36] and upload. If it fails, hold BOOT while plugging the cable in.
constexpr int UPPER_PX | = 6; | // upper-arm pixel count (pod to elbow)
constexpr int ELBOW_GAP_PX = 7; | // elbow umbilical length / 1.67 cm
constexpr int FOREARM_PX | = 15; | // forearm pixel count
constexpr int HAND_PX | = 6; | // hand pixel count
constexpr int GAP_PX | = 5; | // wrist umbilical length / 1.67 cm
The two gaps are the measured pixel-to-pixel distance across each umbilical, divided by 1.67 cm. Measure the finished assemblies from Step 3 — including the connector bodies [21], which are most of it. ELBOW_GAP_PX: last upper-arm pixel to first forearm pixel; about 12 cm gives 7. GAP_PX: last forearm pixel to first hand pixel, across the wrist; about 8 cm gives 5. Guessing here is what makes the comet look like it stumbles at the elbow or the wrist.
The comet launches from pixel 0 at the pod and runs all the way to the fingertips. The firmware keeps the total travel time the same — about 250 ms, matched to the blower's spin-up — so on the longer path the comet simply moves faster. The status blinks stay on the elbow pixel, which is now the first forearm pixel (index UPPER_PX).

Flash the identical sketch to both arms. There is deliberately no left/right setting — as long as pixel 0 is at the pod on each arm, the mirroring is physical only.

### Step 9 — Tune the timing

This is the step that makes the whole effect work, and it can only be done on the finished arm. The goal: the comet reaches your fingertips at the exact moment the first bubble appears. When it is right, the light looks like it is causing the bubbles. Wrong by even 100 ms and it just looks like lag.
- Film yourself firing it in slow motion — any modern phone does 120 or 240 fps.
- Watch it back frame by frame. Does the comet arrive early or late?
- Adjust COMET_TRAVEL_MS: comet arrives before the bubbles, increase it; after the bubbles, decrease it.
- Reflash and film again. Expect three or four rounds.
The default is 250 ms. Your real number depends on how fast your particular blower [1] spins up, which is why it is guesswork until you measure it. If you built Mount C, expect a slightly longer number — a 150 mm feed hose takes marginally longer to prime than a 60 mm one, and that delay lands between the trigger and the first bubble.

### Step 10 — Mount into the glove and sleeve

Hiding the strip [5] under fabric is an upgrade, not a compromise — the fabric diffuses the pixels into one smooth continuous streak instead of visible dots. But it only works if the fabric cooperates.

Test the fabric before you commit

Hold a powered section of strip [5] under the glove [6] in a dark room. Thin, pale, stretchy fabric glows beautifully; thick or dark fabric, especially leather, swallows almost all of it. If you cannot see it clearly, no firmware setting will rescue it — get a different glove. Test the sleeve [7] at the same time; there is no point in a glove that glows over a sleeve that does not.
- Run the strip across the back of the hand, over the knuckles. Never the palm — that is where the trigger [20] is and where you grip things.
- Stop short of the fingertips. The blower head needs that space, and finger joints flex too much for strip to survive.
- Sew a fabric channel [31] for the strip to sit in rather than gluing it down flat. The channel lets it slide as your hand flexes; glued-taut strip tears itself off, or tears the glove.
- Run the forearm section under the sleeve [7], same principle. The upper-arm section runs from the pod down to the elbow plugs the same way.
- MAX_BRIGHTNESS is preset high to punch through fabric. You can raise it further for thicker gloves, but current draw climbs with it and battery life drops.

Connectors and strain relief

The connector is never the anchor. Tack the cable to the garment on both sides of every plug, so a snag pulls the tack rather than the latch. Leave a service loop either side.

A smear of dielectric grease [26] in each shell keeps soap residue from corroding the contacts over a season. And position the mated plugs where a tight sleeve will not press them into your skin — a 20 mm plastic body under a cuff for six hours is uncomfortable.

# Step 11 — Seal it against the soap

The build used to assume the pod sits on your upper arm, above the spray. That holds on a bench and fails at a rave, where your arms go up. Point a bubble gun at the ceiling for four hours and the pod is no longer above anything. Assume every surface gets wet, from every angle, all night.

### What actually gets in

- Arms overhead. Solution runs down the arm, straight at the pod and into anything that faces up.
- Blowback. The blower [1] atomises solution. A fine soapy mist settles on everything within a metre, including the inside of any vent you left open.
- Wicking — the one people miss. Soap film creeps along wire insulation [27], into a connector shell and out the other end, hours after the splash that started it. Sealing the box is not enough if the wires are a wick.
- Other people. Hands go up, drinks get waved, and someone will absolutely grab your forearm.
- Condensation. Warm arm, cold night, sealed box. Water forms inside a perfectly sealed enclosure with no help from outside. Dried bubble solution is also mildly conductive and hygroscopic — it pulls moisture back out of the air, so a "dry" residue across two pins is a leakage path that comes back every humid night until you clean it off.

The rule: drain it, do not hermetically seal it

Chasing a watertight box is the wrong target. You cannot get there with an FDM print, a USB port and six wires leaving the case — and if you did, condensation would defeat you from the inside.

Aim for this instead: nothing that gets in can pool on a board; everything that gets in has a way out at the bottom; everything that gets in dries between events.

### The pod enclosure

- PETG [45], not PLA. PLA goes soft in a hot car and is brittle where this part flexes under a strap. Four perimeters, 1.6 mm walls minimum — thin FDM walls leak through the layer lines themselves.
- A lid with a gasket groove, closed with four M3 × 8 mm button-head stainless screws into 4.6 × 5.0 mm brass heat-set inserts [43], with 2 mm silicone cord [42] in the groove. Nothing sticky — you will be opening this.
- Model the insert bosses at 4.0 mm diameter, 6.0 mm deep, with at least 2 mm of plastic all round — a boss 8.5 mm across or more. The 0.6 mm the hole is undersize is the plastic the brass melts into; the extra 1 mm of depth is somewhere for displaced plastic and the screw tip to go. Clearance in the lid is 3.4 mm. Set the inserts with a soldering iron at 240 °C, square, until the top is flush to 0.2 mm below the surface. If your lid is not 3 mm thick, screw length is lid thickness plus 5 mm.
- Every opening faces down or aft. Nothing on the top surface, nothing on the fingertip-facing end.
- A 2 mm drain hole at the lowest corner, plus a small vent at the opposite high corner so it can breathe. Yes, this is a hole in your waterproof box. It is the difference between a box that drains and a box that holds a puddle against your protoboard [29].
- Cable entry through a grommet [44] on the underside, and a drip loop on every wire leaving the pod — a downward loop below the entry, so water running along the insulation drips off instead of tracking in.
- A silicone plug or hinged flap over the USB-C port. It has to stay reachable and it has to be shut by default.

Conformal coat the board

The enclosure is the first line, not the only one. A thin coat of clear acrylic spray [40] over the assembled protoboard [29] turns a soaked board into one you rinse, dry and keep using.

Mask first: the USB-C connector, the boost trimpot [14], the MOSFET tab [10], every connector housing, and the microswitch [20]. Two thin coats beat one thick one. Do it after the bench test passes — coating a board you then have to rework is miserable. Clear RTV [30] dabbed over the strip's cut ends does the same job at the wet end of the arm.

### The battery gets its own sealed compartment

- A wall between the cell [12] and the electronics, so a leaking or vented cell does not take the board with it, and so soap that gets in during a swap does not reach the brain [8].
- Nothing in this compartment is soldered [13]. With the cell on its factory pigtail there are no tabs and no joints in here to work loose — most of why the cradle beat a sled. Heat-shrink [28] and a strain-relief anchor go on the J1 wires, outside the wall.

- Nothing metal loose in the compartment. No stray screws, no washers, no snipped lead ends. Check every time you close it.
- Check the cell's own wrap before every event. A nicked 18650 sleeve exposes the can, which is the negative terminal over the whole body of the cell — that is how a cell shorts against something it is only resting on. Re-wrap or bin any that are torn; they cost almost nothing.
- The cradle lid closes positively and opens without a tool. A click, a screw or a strap.
- The cradle grips the cell, not the pigtail. If the cell can shift, the pigtail takes the load and the crimp is what eventually fails. A foam pad or a printed rib pinching the wrap is enough.

The trigger is the leakiest part of the build

A bare lever microswitch [20] in your palm, under a glove [6], in soapy water, is not a sealed part. Cheapest fix first: a printed pocket with a nitrile or silicone membrane over the lever — a scrap of a nitrile glove, stretched and glued around the rim, passes the press through and keeps the liquid out. Otherwise buy a sealed IP67 microswitch with the same lever, which is harder to source than it sounds.

Either way, seal the ZH-2 [25] joint: heat-shrink [28] over the solder, and dielectric grease [26] in the shell.

### The connectors

- Grease every shell [26] — you were doing this for corrosion anyway; it also keeps water out of the contacts.
- Wrap each mated plug in a turn of self-amalgamating silicone tape [41]. It fuses to itself, takes no adhesive with it, and comes off in one piece when you need to unplug.
- Point the plug down, or at worst sideways. A shell facing up is a cup.
- The wrist plugs [21] [22] sit above the cuff, not under it — a cuff channels solution straight into the shells.

Test it before you trust it

With the arm assembled, sealed and powered (an unpowered box tells you nothing about tracking or shorts):

1. Hold it overhead, the way you would actually fire it. 2. Spray it all over with real bubble solution [4] for a full minute — from above, from the sides, at the connectors. 3. Fire the trigger a dozen times through the wetting. 4. Leave it ten minutes, still powered, still wet.
5. Open it.

Look for water inside, and for water tracking along the inside of the wire entry. Both mean you move the entry point or add a drip loop.

### Step 12 — Build the second arm

Repeat Steps 1 to 11. Two things to be careful about:
- Pixel 0 goes at the pod on this arm too. It is tempting to mirror the wiring along with the physical build. Do not. Identical wiring means identical firmware means one thing to maintain.
- Keep the same SM-3 [21] and SM-4 [22] pin conventions. If arm A puts the trigger on pins 3-4 and arm B puts it on pins 1-2, then spares are not spares, and one wrong plug at an event costs you a board — identical pinouts are also what makes the cross-mates harmless. Write the pinout on a bit of tape inside each pod.

# Step 13 — Assemble the costume

Both arms exist. This step is about the thing you actually wear.

### Both-arms checkout

- Cells [12] out of both pods.
- Mate every connector on both arms. Count them: five down each arm — elbow SM-4 [22], elbow SM-3 [21], wrist SM-4 [22], wrist SM-3 [21], hand SM-2 [24] — plus the pod's J2 SM-3 into the upper-arm strip, and the ZH-2 [25] at each microswitch.
- Cells in. Both arms should show the idle glow.
- Fire each hand separately. Left trigger drives the left arm only; right drives right only. If one trigger fires the other arm, you have crossed something — there is no cross-arm wiring in this design.
- Fire both at once. Watch for either arm dimming or glitching. They are electrically independent and should not interact at all; if they do, suspect a shared ground you did not intend.
- Run both for the length of a bottle of solution [4]. That is your real duty cycle.
Getting into it — cells go in LAST | Getting out of it — cells come out FIRST
1. Pods on, strapped, cells out, switches [38] off.
2. Sleeves on. Mate elbow SM-4 and SM-3 each side.
3. Gloves on. Mate wrist SM-4 and SM-3 each side.
4. Bubblers strapped on, mate hand SM-2, bottles filled.
5. Cells in, then switches on. Check both idle glows.
1. Switches [38] off, then cells out. Both arms are now dead.
2. Hand SM-2 + bubbler strap → bubblers off, bottles upright.
3. Wrist SM-4 + SM-3 → gloves peel off.
4. Elbow SM-4 + SM-3 → sleeves come off.
5. Pod straps.
| Four releases per arm, none needing a second person or a flat surface.

The two tests that matter

Can you get out of it alone, in a bathroom, with soapy hands, in under a minute? If not, something is still soldered that should not be, or a strap is fighting a connector.

Can you kill and remove either battery [12], one-handed, in under ten seconds? Switch [38] off, cradle lid, plug. If either takes longer, fix the pod before the event. When something goes wrong mid-event the order is: switch off, cell out, then work out what happened.

### Care afterwards

- Cells out for storage. Never store the costume with cells connected. The switch [38] being off is not storage — a switch can be knocked on in a bag.
- Open the pods and let them dry before they go away. A sealed damp box is worse than an open damp box. See Step 11.
- Rinse the blower head and cap in warm water — dried bubble solution glues the one-way valve shut.
- Leave the silicone sleeve on the cap protrusion so the bottle does not empty into your bag.
- Wipe soap residue off any connector that got sprayed, and re-grease it [26].

# Troubleshooting

Symptom | Likely cause
Nothing lights at all | Check common ground. Check boost [14] output is about 5V. Check strip DIN is on the input end — follow the arrows.
Nothing lights, and it worked yesterday | Check every connector is fully latched. A half-seated SM plug looks mated.
Works until you move your arm | Unseated connector, or a crimp that did not take. Beep through each pin while wiggling the cable.
First pixel wrong colour, rest fine | Missing or wrong-value data resistor [19].
Pixel 0 died after a reconnect | Strip was plugged in live. Cell [12] out before mating, every time.
Random flickering, especially when moving | Missing level shifter [9], or a loose ground. Check the strip GND (SM-3 [21] pin 2) at both ends — the pod's J2 and the elbow J6.
Odd pixel glitches or a stuttering blower, only with it all running | Missing 0.1 uF [18] at the level shifter [9] supply pins, or fitted on long legs. Step 4.
Level shifter [9] runs warm with nothing obviously wrong | Unused inputs floating. 3A and 4A to ground, 3OE and 4OE to Vcc. Step 4.
Comet runs fingertips to pod | Strip [5] is reversed — it should run pod to fingertips. Fix the wiring, not the code.
Comet jumps or stalls at the elbow | ELBOW_GAP_PX does not match your measured elbow umbilical length.
Comet jumps or stalls at the wrist | GAP_PX does not match your measured wrist umbilical length.
Colours wrong, red and green swapped | Change GRB to RGB in the addLeds line.
Motor whines audibly | PWM frequency dropped below 20 kHz — check MOTOR_PWM_HZ.
Motor does not spin | MOSFET [10] gate not driven, or it is not a logic-level part.
Motor spins weakly, MOSFET gets hot | Gate driven at 3.3V instead of through the 74AHCT125 [9] — or it is an IRF520, which is not logic-level.
Motor runs constantly, trigger does nothing | Motor still on its factory PH2.0 lead, plugged straight to the cell. Rework it to SM-2 [24] — Step 7.
Everything dies when the motor starts | Cell [12] sagging, or the polyfuse [15] tripping. Check the charge.
Works, then dies after a few minutes | Cell [12] protection circuit cutting out. Recharge or swap.
Elbow pixel pulsing red, slow single pulse | Low-battery warning. Swap the cell [12] soon.
Elbow pixel double-blinking red, motor dead, trigger does nothing | Low-voltage shutoff, latched at 3.0V. Swap the cell [12]; it clears itself.
Blower twitches every time you power up or reflash | Missing 10k gate pulldown on the MOSFET [10]. Meter gate to source — it should not read open.
Step 4.
Laptop complains about USB power, or the pod stays alive with the cell out and USB in | Missing or reversed CR2 [11]. The pack is backfeeding the host port. Step 4.
Arm completely dead, cell freshly charged | Disconnect switch [38] off, or its DC rating gave out. Check the switch before you suspect the board.
It worked, got sprayed, now behaves oddly | Soap tracking across pins. Switch [38] off, open it, rinse with isopropyl, dry fully. Then Step 11.
One trigger fires the other arm | Not possible by design — you have cross-plugged two arms. Check each arm is self-contained.
Board will not accept uploads | Hold BOOT while plugging in USB. If the port is not recognised at all, suspect a charge-only cable [36].
Strip goes dark past the elbow | Unseated elbow SM-3 [21], or a failed elbow umbilical joint — same failure as the wrist, one joint up.
Strip goes dark past the wrist | Cracked trace or failed umbilical joint — the failure the umbilical exists to prevent. Swap in your spare.
Trigger does nothing, one arm | Check the ZH-2 plug [25] first, then the switch itself. No spare switch is carried, so if the switch is dead that arm is done for the night.
Bubbles weak or intermittent | Gravity ball not sitting in solution, or the feed hose [3] is too long. See the Step 7 hose test.

Symptom | Likely cause
Bubbles stop but the motor runs | Bottle [2] empty, or dried solution in the one-way valve. Rinse the cap.

### Changing how it behaves

The whole point of the strip [5] is that every pixel takes orders individually. Everything you would normally want to change lives in one marked block at the top of the sketch — edit, reflash over USB-C, done.

Constant | Changes
THEME_HUE | The comet's colour, 0-255 around the colour wheel
COMET_TRAVEL_MS | Comet speed, and its sync with the bubbles
COMET_REPEAT_MS | How rapid-fire the stream is while held
COMET_FADE | Tail length — higher is shorter
MAX_BRIGHTNESS | Overall brightness, for your glove's fabric
IDLE_BRIGHTNESS | Resting glow. Set to 0 for fully dark when idle
MOTOR_RUN_DUTY | Bubble rate
VBAT_WARN_MV / VBAT_WARN_CLEAR_MV | When the low-cell warning starts and stops. Keep them apart — that gap is the hysteresis that stops it strobing as the motor loads the cell
VBAT_CUTOFF_MV | Where the arm shuts itself down. Raising it is fine; lowering it costs cell life
The XIAO [8] has Wi-Fi and Bluetooth sitting unused, already paid for. Natural next steps, in rough order of effort: more patterns with a long-press to cycle them; ESP-NOW so either arm's trigger can also fire the other for a two-handed blast — note that is additive, each hand keeps its own trigger and its own arm; and a small web page served by the board so you can change colour and speed from your phone without a laptop.

### Field kit

What to carry when you actually wear this. Everything here now swaps without a soldering iron — that is what the connectors bought you:
- A pre-made spare wrist umbilical [21] and a pre-made spare elbow umbilical [21] — genuinely swappable now that both ends are connectors.
- One spare SM pigtail pair of each size [21] [22] [24].
- The kit's USB charger and a power bank. With no spare cells [12], recharging between sets is the only way to extend the night.
- Extra bubble solution [4]. This runs out long before the battery does.
- Spare 3 x 5 silicone tube [3], in case a feed hose splits.
- A solder pen [34], for repairs you cannot connector your way out of.
- A small screwdriver and some electrical tape.
- Self-amalgamating tape [41], for re-wrapping a plug you had to open.
- Isopropyl and a cloth. Wiping dried solution off a connector at the venue is the difference between one dead arm and two.

### What this kit cannot fix

Two failures end an arm for the night, because no spare was bought. A flat cell [12] — two cells, one per arm, both in use; mitigate by charging full that morning, knowing the runtime from the Step 6 bench test, and killing the disconnect [38] between sets. A dead trigger [20] — two switches, one per arm, both in use; the ZH-2 pigtail [25] means a spare would swap in ten seconds, there just is not one yet. Both are cheap to close later: protected 18650s and lever microswitches sell in multipacks.
