darknet-doll/clown/3d-prints/pod-housing/versions/pod-housing-v2-preview.png

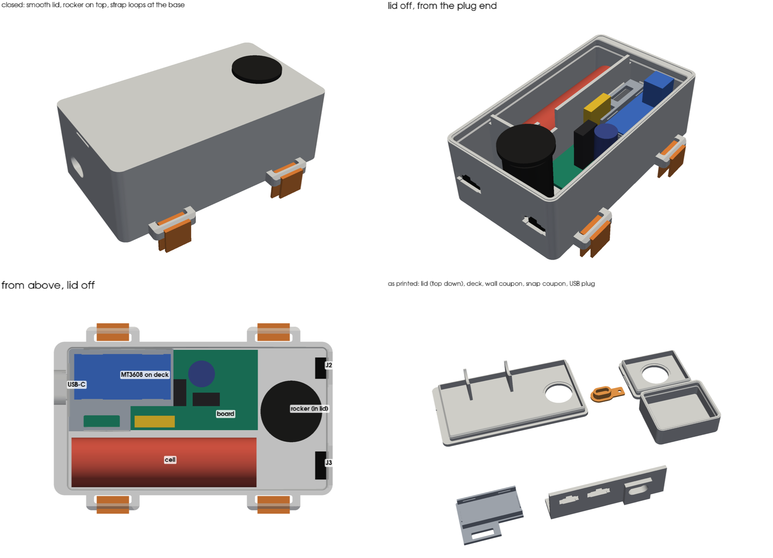
3d-prints/pod-housing/versions/pod-housing-v2-preview.png
