darknet-doll/clown/3d-prints/pod-housing/versions/pod-housing-v3-preview.png

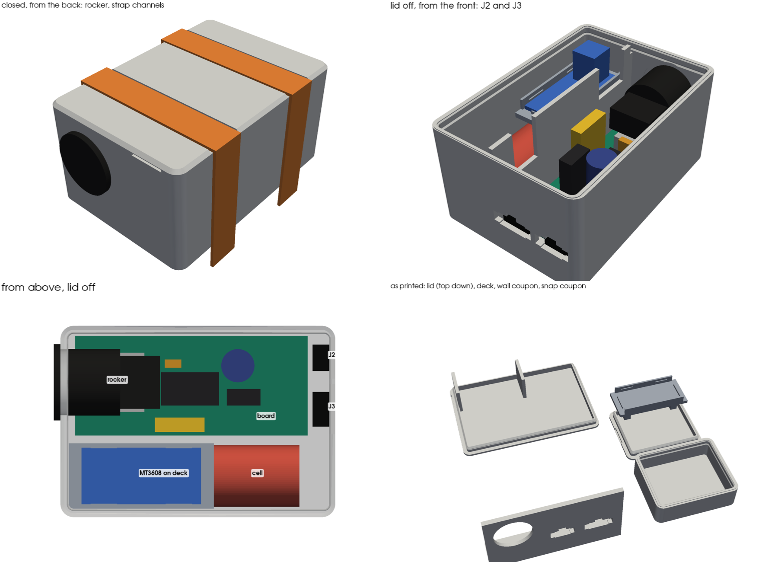
3d-prints/pod-housing/versions/pod-housing-v3-preview.png
