darknet-doll/clown/3d-prints/wrist-splint-mount/versions/wrist-splint-mount-v1-coupon-preview.png

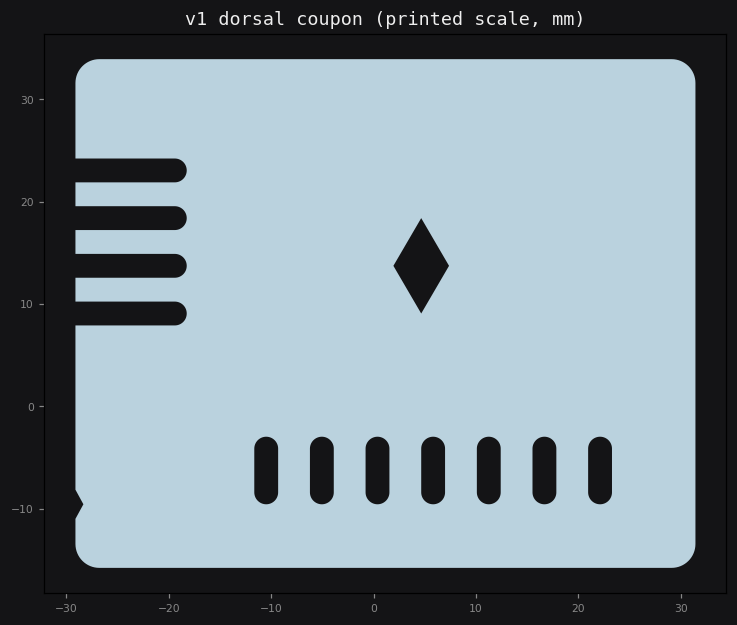
3d-prints/wrist-splint-mount/versions/wrist-splint-mount-v1-coupon-preview.png
