darknet-doll/clown/3d-prints/wrist-splint-mount/versions/wrist-splint-mount-v4-preview.png

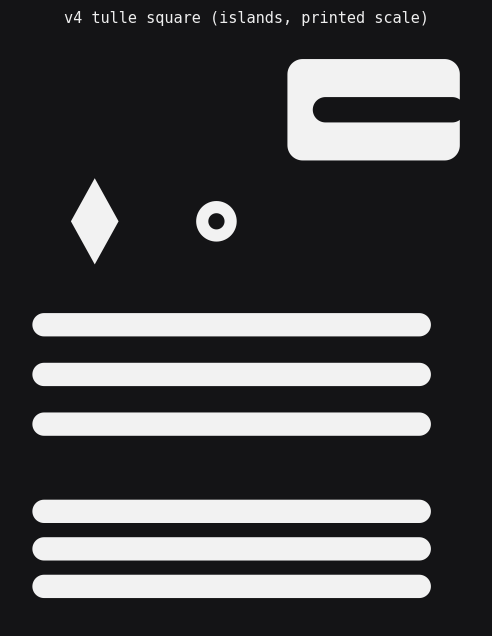
3d-prints/wrist-splint-mount/versions/wrist-splint-mount-v4-preview.png
