darknet-doll/clown/3d-prints/wrist-splint-mount/versions/wrist-splint-mount-v7-preview.png

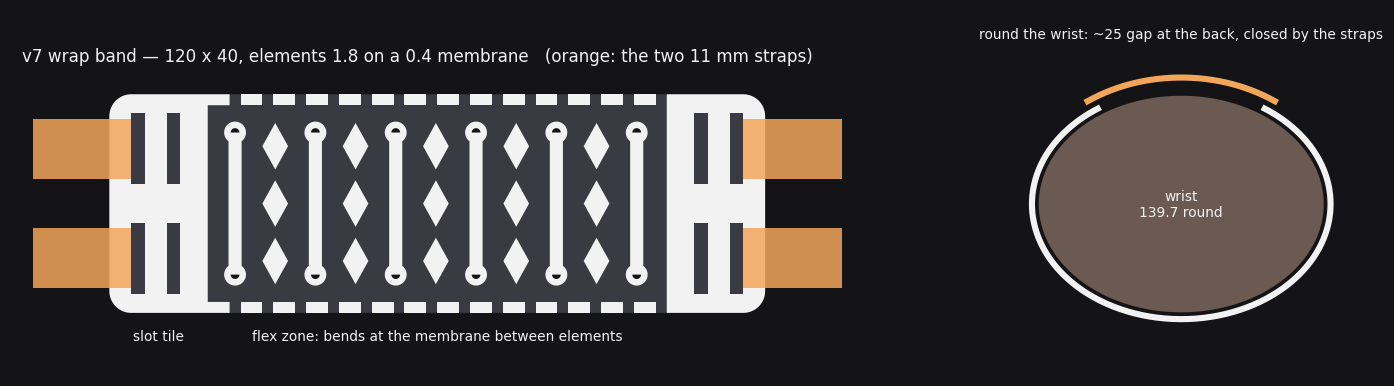
3d-prints/wrist-splint-mount/versions/wrist-splint-mount-v7-preview.png
