darknet-doll/clown/firmware/bench/bench-wiring.png

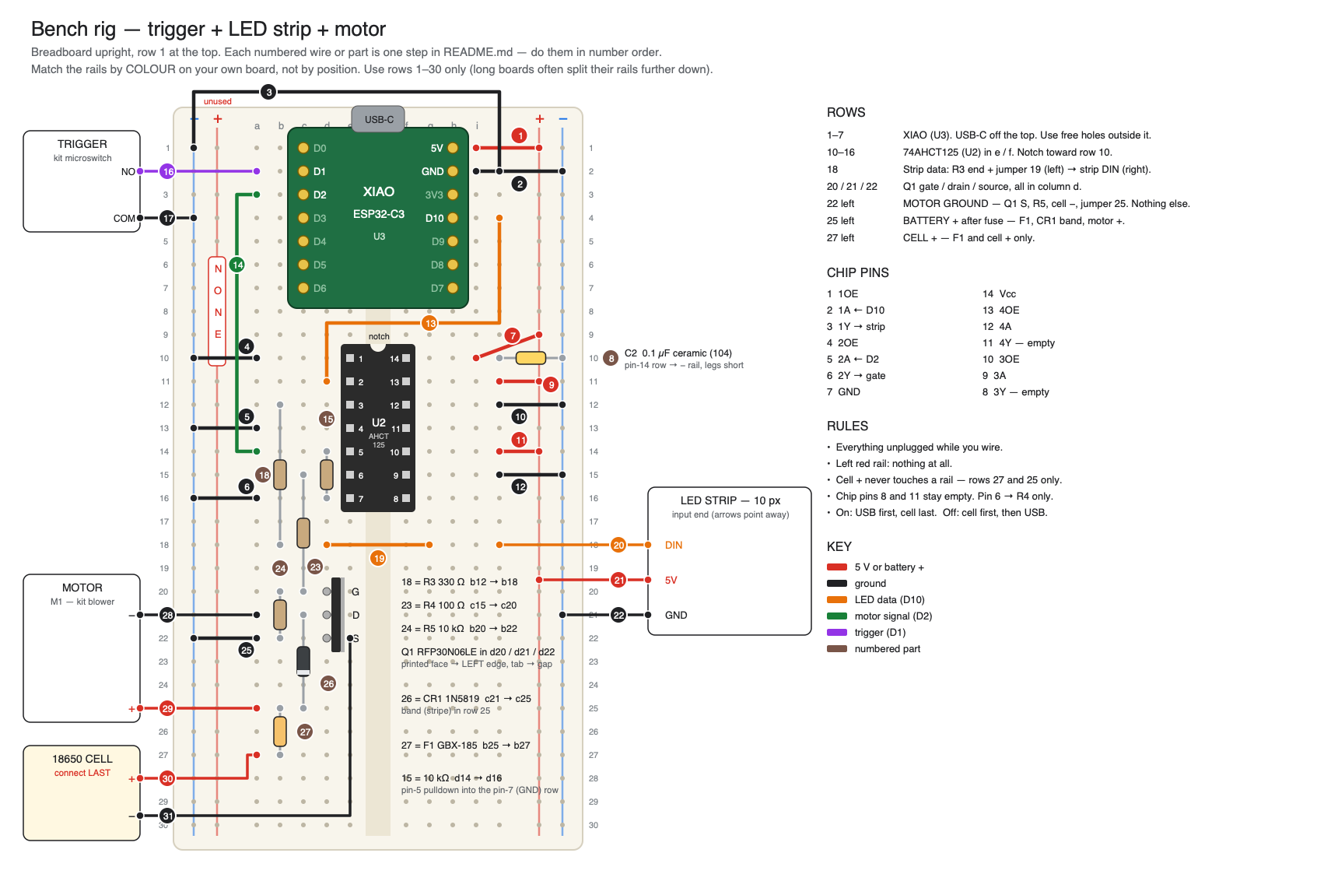
firmware/bench/bench-wiring.png
