darknet-doll/clown/docs/pcb/clown-pod.kicad_pcb

## KiCad design docs/pcb/clown-pod.kicad_pcb (2026-10-09)

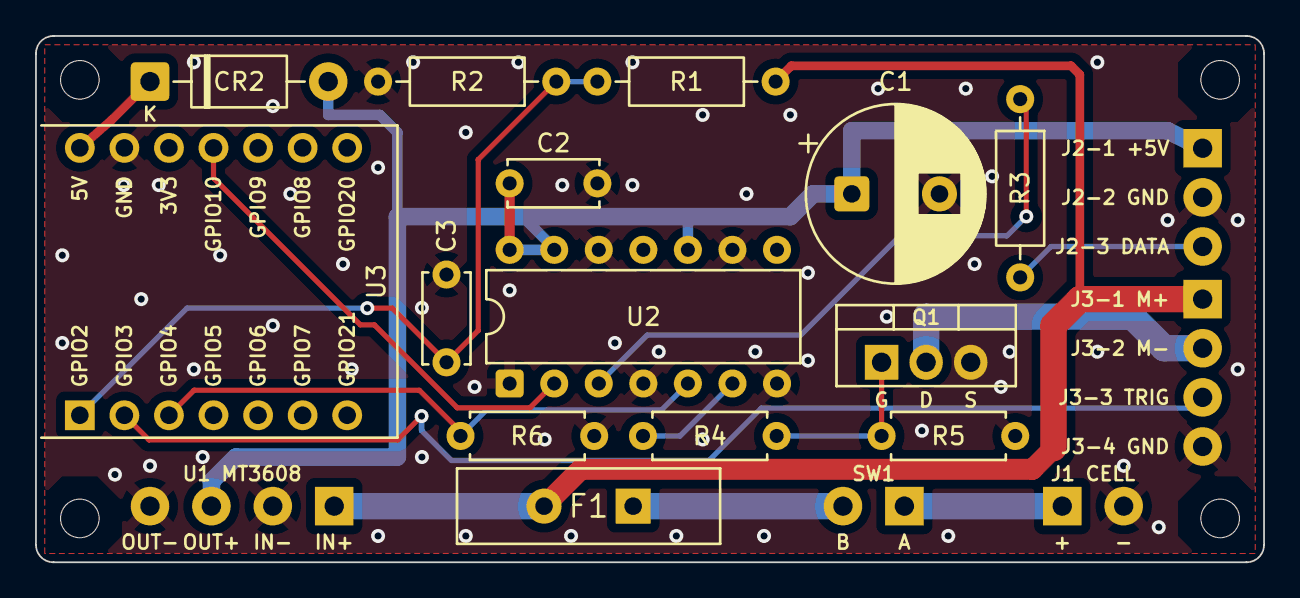
[picture p74: board clown-pod.kicad_pcb from above]

Board: 2 copper layers, 70.0 x 30.0 mm, 23 parts (0 on the bottom side), 15 nets.

Parts:
C1: 1000uF 16V; CP_Radial_D10.0mm_P5.00mm
C2, C3: 0.1uF; C_Disc_D5.0mm_W2.5mm_P5.00mm
CR2: 1N5819; D_DO-41_SOD81_P10.16mm_Horizontal
F1: PPTC 1.85-2.5A; PPTC_Disc_D15mm_P5.08mm
H1, H2, H3, H4: MountingHole_2.2mm_M2
J1: Cell, PH2.0; WirePads_2
J2: Strip SM-3; WirePads_3
J3: Elbow SM-4; WirePads_4
Q1: RFP30N06LE; TO-220-3_Vertical
R1, R2: 100k; R_Axial_DIN0207_L6.3mm_D2.5mm_P10.16mm_Horizontal
R3: 470R; R_Axial_DIN0207_L6.3mm_D2.5mm_P10.16mm_Horizontal
R4: 100R; R_Axial_DIN0207_L6.3mm_D2.5mm_P7.62mm_Horizontal
R5: 10k; R_Axial_DIN0207_L6.3mm_D2.5mm_P7.62mm_Horizontal
R6: 100k; R_Axial_DIN0207_L6.3mm_D2.5mm_P7.62mm_Horizontal
SW1: KCD1 rocker; WirePads_2
U1: MT3608 module; WirePads_4
U2: 74AHCT125; DIP-14_W7.62mm
U3: XIAO ESP32-C3; XIAO_ESP32C3_Headers

Connections:
+5V: C1.1, C2.1, CR2.2, J2.1, U1.3, U2.10, U2.13, U2.14
+5V_MCU: CR2.1, U3.14
GATE: R4.1, U2.6
GATE_3V3: R6.1, U2.5, U3.3
GATE_Q: Q1.1, R4.2, R5.1
GND: C1.2, C2.2, C3.2, J1.2, J2.2, J3.4, Q1.3, R2.2, R5.2, R6.2, U1.2, U1.4, U2.1, U2.4, U2.7, U2.9, U2.12, U3.13
LED_DATA: R3.1, U2.3
LED_DATA_3V3: U2.2, U3.11
LED_DATA_STRIP: J2.3, R3.2
MOTOR-: J3.2, Q1.2
TRIG: J3.3, U3.2
VBATT: F1.2, J3.1, R1.1, U1.1
VBATT_RAW: J1.1, SW1.1
VBATT_SW: F1.1, SW1.2
VSENSE: C3.1, R1.2, R2.1, U3.1
