darknet-doll/clown/(commit log)

2026-09-21 Add costume overview and single-arm firmware
    Two independent mirrored arm rigs, each 5V from a USB power bank.
    Same sketch flashes to both: pixel 0 at the elbow means no handedness
    in code. Blower is PWM-capped to ~72% duty since the Bambu P6M is a
    3.7V motor on a 5V bus.
2026-09-21 Add parts list and build manual; switch to swappable 18650
    PARTS.md explains each component in plain language, BUILD.md is the
    step-by-step assembly walkthrough with troubleshooting.
    Power moves from a USB power bank to a swappable protected 18650 on a
    split rail: cell direct to the blower at its native 3.7V, small boost
    for the strip and MCU only. Motor duty cap is no longer needed, and the
    firmware now warns on a low cell via an ADC divider.
    Strip brightness raised for diffusion through glove fabric.
    [clown_arm.ino]
2026-09-21 Add printable PDF build manual
    Page 1 is the numbered parts list with a plain-English note under each
    part; pages 2+ are assembly steps that reference those numbers in
    brackets. Generated by docs/manual/build_manual.py, so renumbering a
    part updates every cross-reference via ref(n).
2026-09-21 Store concept board and reconcile it with the build
    Adds design/concept-look.png and DESIGN.md. Three conflicts with the
    current build notes, flagged rather than silently resolved:
    - Lace is open mesh, so it reveals the strip instead of diffusing it.
    This supersedes the "thin, pale fabric" guidance for the glove.
    - The black-sleeve variations swallow the light.
    - The off-shoulder silhouette leaves nowhere on the upper arm to hide
    the controller pod and cell.
    Also records palette-matched hues and an iridescent-comet idea.
2026-09-23 Rework docs around connectorised modules and dual quantities
    Addresses an engineer's review of the build manual. Two root causes behind
    most of the findings:
    1. The docs silently switched between "per arm" and "per costume" units, so
    the PDF's parts table read as a single-arm build while a callout at the
    bottom of the page said to buy two kits.
    2. Everything was soldered end to end, so taking the costume off meant
    pulling a glove over a controller pod.
    Quantities: every part now carries both "per arm" and "buy" figures. The
    shopping list moves to the top of page 1. Fifteen parts that the build steps
    referenced but no list contained are now included -- most notably the bottle,
    whi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
    [build_manual.py, clown_arm.ino]
2026-09-23 Add buy links to the parts list; fix MOSFET gate drive
    Adds a "Suggested product" line to each part in PARTS.md: 14 specific Amazon
    listings where the exact part matters, and search links where the item is a
    commodity and brand does not. The bubble kit is not sold on Amazon and links
    to Bambu's own store instead.
    Stock, price and delivery to Bothell are NOT verified and the document says so
    in a note at the top. Amazon serves automated requests a page with no price,
    stock or delivery data, and a delivery estimate requires a signed-in session
    with an address set. The links establish "this is the right part", not "this
    is available today" -- confirm both in the cart.
    Sourcing turned up two r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
    [build_manual.py]
2026-09-24 Act on the engineering review: schematic, safety, sealing
    Seven pieces of feedback from the engineering review, and the schematic they
    asked for. Nothing here changes what the costume does; all of it changes what
    happens when something goes wrong.
    Four electrical additions, all on the new schematic:
    SW1, a master disconnect in the cell positive ahead of the fuse. This is a
    lithium cell strapped to an arm inside what is about to become a sealed box.
    "Unplug it" should not mean "open the pod first". Spec that actually matters is
    the DC rating, not the AC one printed larger on the same listing.
    D2, a 1N5819 between the boost output and the XIAO's 5V pad. That pad is wired
    straight to USB VBU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
    [build_manual.py, clown_arm.ino, deck.py, render.py, schematic.py]
2026-09-24 Tie off the 74AHCT125's unused gates
    Second round of engineering review. The chip has four gates; the build uses two,
    for the LED data line and the MOSFET gate drive. The other two were left
    unconnected, which is wrong in a way that does not announce itself.
    Unused CMOS inputs must sit at a defined level. A floating input drifts to
    somewhere near the switching threshold, the gate oscillates, and the part
    dissipates real power doing it -- tens of milliamps instead of microamps, as
    heat, continuously, out of a cell strapped to an arm. It also couples noise into
    the two gates the build does care about, one of which is a WS2812 data line that
    already has a level shifter in front of it precisely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
    [build_manual.py, deck.py, schematic.py]
2026-09-24 Rename the diodes, add the boost trim and the decoupling cap
    The XIAO's silkscreen owns D0-D10, so calling the Schottkys D1/D2 collided
    with pin names in every table. They're CR1/CR2 now, pins are named by GPIO
    number with the silkscreen label beside them, and SCHEMATIC.md carries the
    naming rules both docs point at.
    Also from the same read-through:
    - Trim the MT3608 to 5.00 V on its own, output open, before it can reach
    the strip or the XIAO. Modules ship at 15-20 V; wiring one up blind
    destroys both. Per module, not per build, and re-trim under load
    - 0.1 uF ceramic across the 74AHCT125's Vcc and GND, legs cut short, on the
    chip. C1 is bulk storage by the elbow and cannot cover a n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
    [build_manual.py, clown_arm.ino, deck.py, schematic.py]
2026-09-30 Record the listings actually bought, and the gaps they leave
    The buy links in PARTS.md were spec-matched suggestions added after the
    fact, so nothing recorded where a part actually came from. Thirteen orders
    are now logged in a "Bought" section with per-part notes, and the shopping
    list carries a "bought" status so the buy column means what it says.
    Four of the thirteen need a decision before assembly:
    - The GBX polyfuse assortment has no 2.0 A value. Fit GBX-185 or GBX-250.
    - The WS2812B listing does not state PCB colour. A white PCB shows through
    pale fabric with the strip off.
    - RFP30N06LE is the marginal-at-3.3 V part, so the 5 V gate drive through
    the spare 74AHCT125 gate is now t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
2026-09-30 Track which orders have actually arrived
    Nine of the fourteen are here. The Bought table gains an Arrived column so
    the record distinguishes ordered from in-hand, which the previous commit
    conflated.
    The four that gate first power-up are all still out: the 74AHCT125 (both
    the strip's data buffer and the bought MOSFET's 5 V gate drive), the MT3608
    boost (no 5 V rail at all), the GBX polyfuse (inline cell protection, so
    not something to bench-test without) and the INNOVA 3320 (the meter every
    polarity and trim check is made with).
    The fifth is the Fermerry 22 AWG kit. The 26 AWG arrived, so signal and
    trigger runs are covered, but there is no power wire on hand for the cell,
    switch, fuse, bo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
2026-09-30 Log the wire and polyfuse arrivals; flag two open questions
    Eleven of fourteen are in. Every passive, every consumable and both wire
    gauges are now on hand, so the pod can be wired. It still cannot be
    powered: the 74AHCT125 and the MT3608 boost are both out, and so is the
    meter that the boost trim has to be set against.
    Two things the delivery did not settle:
    - The polyfuse arrived as a 25-piece assortment, not the 50-piece listing
    recorded here, so its value spread is unknown. The row now points at the
    recorded listing as explicitly not the one that came. GBX-185 or GBX-250
    has to be confirmed present or the fuse stays an open buy.
    - An arrival logged only as "vuot" matches none of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
2026-09-30 Log the boost and meter arrivals; only the level shifter is left
    Thirteen of fourteen are in. The 74AHCT125 is the last one out, and it
    blocks two things rather than one: the strip's data buffer and the 5 V gate
    drive that turns the bought RFP30N06LE from a marginal part into a fully-on
    one.
    Having the MT3608s and the 3320 together unblocks the boost trim, which is
    now the next step and needs nothing else. Called out explicitly, because an
    untrimmed MT3608 out of the bag can put well over 5 V into a XIAO.
2026-09-30 Carry the reconciliation into the per-part sections
    The shopping list was reconciled but the sections below it were not, so the
    file contradicted itself. Five parts that were bought had no Bought line at
    all (the kit, the 74AHCT125, the MOSFET, the cells, the microswitches), no
    Bought line anywhere carried an arrival date, and the polyfuse section still
    named the 50-piece listing that is not what came.
    Each bought part now reads the same way: Suggested product, then Bought with
    the listing and the date it arrived, and where those differ the section says
    so instead of quietly replacing one with the other. The convention is stated
    once in About the buy links.
    Section headings were the other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
2026-10-03 Add a trigger bench test: squeeze the kit switch, a plain LED lights
    Proves the trigger input on D1 and an output pin before the level
    shifter, strip or motor are involved. Includes a pinout image for
    breadboarding the XIAO. Verified on hardware.
2026-10-04 Add firmware test sketches: motor, pin probe, strip, bench wiring
2026-10-05 Start the strip at the pod; split elbow into SM-4 + SM-3
    The LED strip now begins at the pod with a 6 px upper-arm segment, so it
    crosses the elbow on its own 3-pin umbilical (J6). Motor and trigger share
    a 4-pin elbow lead (J3). The elbow SM-6 and elbow SM-2 are gone; the wrist
    is unchanged.
    - BUILD/PARTS/README: three strip pieces (27 px), new elbow umbilical,
    connector tables, pin maps, shopping quantities, troubleshooting
    - schematic.py: LD3 upper-arm strip, J6 elbow SM-3, ZH-2 renamed J7;
    sheets and SCHEMATIC.md regenerated
    - firmware: UPPER_PX / ELBOW_GAP_PX, mapping skips both gaps, comet
    keeps 250 ms total travel, status blinks stay on the elbow pixel
    - manual: parts renumbere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
    [build_manual.py, clown_arm.ino, schematic.py]
2026-10-05 Measure the blower pocket from a third-party gun built on the same kit
    Bubble Gun Toy REV1 (MakerWorld, Matthew Ghost) houses the Bubble Maker
    Kit 01 head: Ø37.8 front lip, Ø39.4 pocket, 51.6 mm deep. Its license
    forbids redistribution, so only the measurements and extraction scripts
    are committed; the model files are gitignored.
2026-10-08 Add v1 fit test: caliper measurements, concepts, and print files
    [bubble-housing-v1-base.stl, bubble-housing-v1-clip-coupons.stl, bubble-housing-v1-shroud.stl, bubble-housing-v1-slot-coupon.stl]
2026-10-09 Move J2/J3 pod pads onto the board's edge pads Y2-Y9
    The perfboard has oblong edge pads past column X at the harness end.
    Landing the seven outward wires there gives bigger copper and one exit
    edge instead of grid holes scattered across rows 2 and 10.
2026-10-09 Say C1's legs feed J2's edge pads in the build guide and manual
    With J2 moved to the edge pads, the strip's 5V and GND jumpers come
    straight off C1's legs, so the bulk cap sits right at the plug.
2026-10-09 Record the KCD1 rocker bought as the battery disconnect switch
    It's a 20 mm snap-in rocker, not the booted toggle the spec called for, so
    PARTS.md now says to seal the hole with RTV, label the off side, and check
    the DC rating on the body when it arrives.
2026-10-09 Split the wrist SM-5 into SM-3 + SM-4 and mark when each joint is soldered
    - Wrist now crosses on an SM-3 (strip) and an SM-4 with the elbow's pinout,
    so the sleeve is a straight pass-through and the bubbler's SM-2 unplugs at
    the hand; new J8, J4 becomes SM-3, net lists and BOM counts updated
    - Every pod wiring row says solder now or wait, with a table of the five
    shared nodes, plus the two blower-terminal junctions
    - J3's pre-crimped pigtail colors noted: red is motor -, go by pin number
    - Regenerated schematic SVGs and the build manual PDF
2026-10-09 Add a PCB for the pod, with Gerbers ready to order from PCBWay
    The pod circuit from the perfboard layout is now a 70 x 30 mm two-layer
    through-hole board, the same size as the perfboard it replaces. pod_pcb.py
    generates it with KiCad 9 in Docker and Freerouting routes it. build.sh
    pours ground, runs DRC (0 errors, 0 unconnected) and writes
    fab/clown-pod-gerbers.zip, the file to upload.
    [clown-pod.kicad_pcb]
2026-10-09 Fix the XIAO's top row in both pod layouts: it was drawn reversed
    With the USB pointing left, the top row runs 5V, GND, 3V3, D10, D9,
    D8, D7 from the left (B8..H8); the layouts had it backwards. G1 now
    taps GND at C8, S9 runs CR2's cathode to 5V at B8 as a short wire
    instead of a bridge, and S1 picks up GPIO10 at E8. A rework note at
    the Build Order explains what to undo on a board built as first drawn:
    the old G8 jumper grounded GPIO8, a boot-strap pin, and the old H8
    bridge put ~4.7 V on GPIO20, which is not 5V-tolerant.
2026-10-09 Resize bubble housing belt loops for the real 11 mm Velcro (v2)
    The strap measured 11 x 1.1 mm, not the 25 mm v1 assumed. Loop openings go
    from 27 x 3 to 13 x 2.5: 2 mm side clearance, and room for the strap to
    double back. v2 base and a 2.0/2.5/3.0 slot coupon are exported alongside
    v1; the shroud and clip coupons are unchanged.
    [bubble-housing-v2-base.stl, bubble-housing-v2-slot-coupon.stl]
2026-10-09 Design the wrist cuff as a double-flare lace piece and map what mounts under it
    The reference cuff is tight only at the crease, so the SM-3/SM-4 plugs stay
    3-4 cm above the band under the loose upper ruffle: hidden without being
    pressed into the wrist. Closes that DESIGN.md open question and adds two new
    ones (hose gate under the band, lower ruffle hem vs the shroud vents/ring).
2026-10-09 Add R6 to hold the blower off at boot, and C3 to filter battery sense
    U2 drives the MOSFET gate from U2 2A, which floats until setup() drives
    GPIO4. R5 at the gate can't overpower a driven AHCT output, so the blower
    could twitch at power-up. R6 (100k, U2 2A to GND) holds the input low.
    C3 (0.1 uF across R2) gives the ADC a stiff node instead of 50k of divider.
    Both found by the PCB review.
    [clown_arm.ino, schematic.py]
2026-10-09 Re-lay out the pod PCB after review: hand-routed power, poured ground
    Fixes from four review agents and two re-reviews:
    - Power stage moved beside J3; cell, switch, fuse and motor paths
    hand-routed at 1.5 mm, +5V trunk U1 -> C1 -> J2 clear of U2's pins
    - GND is pours plus 55 stitching vias, no routed ground
    - 0.4 mm clearance everywhere, no copper within 2.4 mm of a hole
    - R6 and C3 added; Q1 moved clear of U2's body
    - Silkscreen at least 0.8 mm / 0.15 mm, nothing off the edge; DRC now
    fails on silk problems; pour 0.5 mm from the edge
    - XIAO moved 1.5 mm left so its USB-C stands proud of the edge
    - README gives the PCBWay form settings that differ from the defaults
    DRC with all severiti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
    [clown-pod.kicad_pcb]
2026-10-09 Fit F1's real 15 mm polyfuse disc on the pod PCB
    The GBX part measures 15 mm across on 5 mm-pitch legs, standing on kinks
    3 mm off the board. The 9 mm outline it had would have run into SW1.
    F1 moves left into the bottom-row gap between U1 and SW1, and the
    VBATT/VBATT_SW tracks move with it. C1 measures 10 mm, as the footprint
    assumed. DRC: no errors, no unconnected pads.
    [clown-pod.kicad_pcb]
2026-10-09 Start the cuff-ruffle part: a printed lace-look ruffle that straps to the housing tongue
    Plays the fabric cuff's lower ruffle so nothing floppy sits near the wand
    wheel. Mounts as a flat tab under the tongue's own Velcro strap, no new
    fasteners. Form, length, wall and material are open until the tongue-to-crease
    distance is measured; hard rule recorded: no rigid part reaches the crease.
2026-10-09 Add cuff-ruffle concept r1: model + renders of the printed lace skirt in place
    Three flounces off the tongue's wrist end (main skirt toward the knuckles,
    interleaved over-tier, short back flounce), scalloped hems, openwork holes.
    All hem positions are stand-ins until the tongue-to-crease distance is
    measured.
    [render.py]
2026-10-09 Cuff-ruffle concept r2: one big ruffle sleeve instead of three tiers
    Single flounce toward the knuckles, flare and flutes scaled up, hem still
    short of the shroud mouth. Root offset raised to 6.5 so the skirt itself
    clears the tongue belt loops that r1's over-tier used to hide. Direction
    recorded in the part file; r1 renders kept for comparison.
    [render.py]
2026-10-12 Export bubble housing v3: clip bore 37.6, shroud feed-nipple groove
    The 2026-10-08 fit test picked the 37.6 coupon and found the feed nipple
    that v1/v2 geometry ignores. v3 moves the base's C-clip to 37.6 and cuts
    a 6.5-wide through-slot in the shroud from the mouth back 12, top
    center, which clears the nipple and doubles as the feed-line exit.
    Ray-probe checks in export_v3.py verify the groove before exporting.
2026-10-12 Archive replaced bubble housing print files
    v1 base/shroud/slot coupon and v2 base are superseded; the v1 clip coupons
    finished their test (37.6 picked). They move to versions/archive/ so
    versions/ holds only what is current: v2 slot coupon, v3 base and shroud.
    export_v1.py and export_v2.py now regenerate into the archive.
2026-10-12 Add a 3D print changelog and log the failed v3 housing fit
    3d-prints/CHANGELOG.md records every version of each printed part: what
    changed, why, files, and the print result. v3 did not fit: clip and shroud
    used the gun's 37.8 front-lip bore for the whole head, but the body behind
    the ring is ~39.4. v4 waits on body measurements.
2026-10-12 List the gun pocket features to borrow for bubble housing v4
    A 1-degree ray map of the gun's blower pocket, plus its split-face screw
    holes, gives ten features v4 can reuse: the 37.8/39.4 two-step bore, the
    full-length nipple groove, top recess, side slots, air-slot pattern, the
    off-centre motor envelope, and a clamshell split with BT2x8 screw holes.
    Positions are from the ring face with the nipple at 12:00. The analysis
    scripts are committed; their outputs stay local (third-party geometry).
2026-10-12 Start wrist-splint-mount: TPU splint base, housing attaches by velcro
    New mount direction (2026-10-12): remix the CC BY-NC-SA wrist splint
    (Printables 1238124) in TPU as the wrist base, with a velcro field the
    bubble housing lands on. Replaces the heat-molding plan. Housing and
    cuff-ruffle get Open notes: tongue/underside-curve work holds until the
    first stack fit test.
2026-10-12 File the splint print-files bundle: PDF reference in, MK3S gcode ignored
    The downloaded wrist-splint-custom-moldable-print_files bundle (from the
    Desktop 3D prints folder) holds the model PDF and a pre-sliced MK3S
    gcode - not the STL. PDF confirms CC BY-NC-SA 4.0 and the honeycomb
    openwork body; ATTRIBUTION.md records the license terms. The remixable
    wrist-splint.stl (model-files bundle) is still to download.
2026-10-12 Add wrist-splint.stl reference and first mesh measurements
    Model-files bundle (CC BY-NC-SA 4.0, see reference/ATTRIBUTION.md) is in:
    flat footprint 229.35 x 197.79, uniform 3.5 thick, fits the X1C bed at
    100%. Secondary z plateau ~2.5 is probably the velcro-channel relief;
    channel map, dorsal outline, and honeycomb cell size still to measure.
2026-10-12 Set splint scale from measured wrist: 139.7 mm circumference, 77.6%
    5.5 in wrist against the author's 18 cm = 100% reference. At that scale
    the footprint is 178 x 153.5, wall 2.72 if scaled uniformly, and the
    velcro channels still clear the 11 mm strap. Z scale (uniform vs held
    at 100% for stiffness in TPU) stays open pending a dorsal coupon.
2026-10-14 Cut the gun front housing for direct print: re-clocked -90, screws to 3/9
    Cut both body halves at the bottle-bay opening's front face (61.0 behind
    the ring face) and rotated -90 about the barrel axis so the clamshell
    split runs horizontal (02 lid over 01 cradle), the front screw seats sit
    at 3:00/9:00 instead of 12:00/6:00, and the feed-nipple groove stays in
    the top half. Output STLs are gitignored (no-redistribution model); the
    script regenerates them.
2026-10-14 Add pod PCB soldering walkthrough: part-by-part order with meter checks
    Trims the MT3608 before U2, C1 or the XIAO go on, and gives the probe
    points and expected reading for each check.
2026-10-14 Pod PCB walkthrough: specify stranded, tinned wire for U1 and SW1
    Solid wire work-hardens and snaps at the joint on a moving arm; tinning
    keeps stray strands off U1's 3.5 mm-spaced pads.
2026-10-14 Adopt the gun front housing; add the 30 mm fit coupon export
    The cut, re-clocked gun front housing is now the housing direction.
    cut_front_housing.py additionally exports front-housing-coupon.stl:
    the front 30 mm of both halves on one plate, bore open through, so the
    printed lip/bore fit, step seating, nipple clearance and the 3:00/9:00
    screw join get tested before the full halves are printed.
2026-10-14 Drop the fit coupon: the full front-housing halves print directly
    darknetdoll's call, same day the coupon was cut. The script no longer
    exports front-housing-coupon.stl; the docs record the decision so a
    later session does not re-propose it.
2026-10-14 Record the exact front-housing screws: Bambu BT2x8 SHCS (AA019), 4 needed
2026-10-14 Add Amazon substitute for the BT2x8 screws: uxcell M2x8 SHCS self-tapping
2026-10-14 Add silver variants of the uxcell M2x8 substitute screws
2026-10-14 Add openwork pattern concept sheet r1 for the splint remix
    Eight 80 mm swatches (honeycomb reference, harlequin, polka dot, pixel
    hearts, daisy, sakura, vine web, scallop lace) drawn at 100% with webs
    sized to survive the 77.6% scale. HEXCODE FLORAL palette and heart map
    for the house options. Look only; placement on the real outline is r2,
    after a pattern is picked.
2026-10-14 Add r2 openwork concepts: circuit grammar with harlequin accents
    Four cutout layouts per the CIRCUIT reference (45-degree doglegs,
    bundles, pads at every trace end, resistors as punctuation, edge
    combs), with harlequin diamonds in place of the house heart signature
    per darknetdoll. Bundle pitch widened 3.4 -> 4.8 because slot + web in
    aperture form needs it; slots 2.4 / webs 2.2 at 100% survive the 77.6%
    scale.
2026-10-14 Place trace bus on the real splint outline; publish r3 review artifact
    splint_outline.py slices the reference STL at mid-thickness and chains
    the section into loops (outer boundary, velcro channels, honeycomb).
    trace_bus_r3.py keeps the channels, drops the honeycomb, and authors the
    chosen trace-bus pattern with 7 mm edge / 4 mm slot clearance checks -
    the solid velcro patch plays the chip, bundle A feeds it like pins.
    make_r3_artifact.py builds the interactive review page (TPU colours,
    honeycomb ghost, annotations), published as a Claude artifact (link in
    the part file). Spec gains the pattern pick and patch zone.
2026-10-15 Export v1 dorsal coupons: patch zone at 77.6%, two thicknesses
    First printable files for the part. export_v1.py cuts the r3 trace-bus
    geometry around the velcro patch (pin comb, die diamond, bundle A ends)
    from a 60.5 x 49.7 strip, pre-scaled to the measured wrist, extruded at
    2.72 (uniform-scale candidate) and 3.50 (Z-held). Both watertight. TPU
    95A flat, no supports; the pair settles wrap stiffness, patch stability
    and cut fidelity before the full splint.
2026-10-15 Export v2: full remixed splint at 77.6%, trace bus in, honeycomb out
    User approved the r3 design for a full test print. export_v2.py rebuilds
    the plate as a flat extrusion of the extracted section (all outlines and
    channel slots exact; original chamfers and recessed bridge tops become
    square), cuts the trace bus, keeps the solid velcro patch, scales to the
    measured wrist: 178.0 x 153.5 x 2.72, watertight. Thickness 2.72 is the
    uniform-scale pick; 3.5 Z-held is the documented fallback.
2026-10-15 Log v2 print result: TPU for AMS is 68D semi-rigid, hence the stiffness
    First full print came out rock-stiff because it was printed in Bambu
    TPU for AMS (Shore 68D, made stiff to feed through the AMS), not the
    spec'd 95A. Spec now forbids it; reprint plan is true 95A (or 85A)
    external spool with fewer shells. Heat-forming noted as a non-fix.
2026-10-15 Add r4 concept: trace bus as positive elements on tulle sandwich
    Inverts r3: no plate, rigid printed tiles on fabric trapped mid-print
    (2 base layers, pause, tulle + magnets on the steel plate, resume).
    Flex comes from the tulle, so the stiff 68D TPU-for-AMS spool becomes
    usable - through the AMS, multicolour, CIRCUIT palette. Pads gain true
    punched centres; patch stays one rigid tile. Open list carries the
    fork: 95A reprint of v2 vs the r4 workflow.
2026-10-15 Rebuild review artifact: r4 tulle reveal, supplies, prior art
    make_r4_artifact.py (clone of the r3 builder, same output path so the
    artifact URL holds) makes r4 the hero view: positive elements on a tulle
    field with mesh pattern, tulle colour picker, bundle A landing on the
    patch tile, strap slots + eyelets on the tile. Adds the pause/magnet
    workflow steps, Amazon search links for polyester tulle and 6x3 N35
    magnets, and three prior-art links verifying the technique (Printables
    hex-on-tulle model, Prusa forum thread, 3DPrinterly guide). r3 cutout
    kept as a comparison tab.
2026-10-15 Resolve handedness: worn palm-side, thumb-first; r4 export mirrors X
    Wearing orientation derived from the author's description + extracted
    geometry: thumb opening indexes the hand, field cradles the palm side,
    channel edges wrap the back, entry gap along the back of the forearm.
    As-drawn fits the left hand only elements-to-skin, so the r4 tulle
    export (tulle on skin, elements out) mirrors in X; the symmetric r3
    print just flips over.
2026-10-15 Record r4 respacing: squish can weld bundle traces into a slab
    darknetdoll flagged the dense bundle regions; the wrap direction itself
    is safe (traces run along the arm, curl hinges at the tulle lines
    between them) but the inherited r3 pitch leaves only ~1.4 mm printed
    hinge, which first-layer squish can bridge. r4 export widens pitch to
    >= 2.5 printed hinges and shortens forearm-rim binding dashes; test
    square gains a two-pitch curl test.
2026-10-15 Export v3 membrane coupons: the no-tulle bend test
    Elements alone are loose islands, so the no-fabric test prints them on
    a 0.4 / 0.6 printed membrane of the same 68D instead. Each 45 x 58
    coupon carries two 3-trace bundles - the r3-inherited 1.4 hinge vs the
    respaced 2.6 hinge - plus a diamond and pad, at printed scale. Curl
    across the traces: answers both the membrane-flex question and the
    pitch-weld question in one 15-minute print, no supplies needed.
2026-10-15 Export v4 tulle test square: islands + pause workflow, bond yank test
    Nine disconnected islands at printed scale: both bundle pitches, a
    diamond, an annular pad (punched centre held by the fabric), and a
    strap tab with the real 13 x 2.5 slot for the yank test. Pause is
    added in Bambu at layer 2 (STLs can't carry it); tulle + magnets per
    the artifact workflow. Print Settings gains v3 + v4 tables.
2026-10-15 Export v5: full r4 tulle splint, mirrored for the left hand
    The artifact's r4 design as a printable mesh: 61 positive islands on
    the real outline at 77.6%, elements 1.8 tall. Bakes in the flagged
    decisions: X mirror (tulle to skin on the left hand), bundle respacing
    to 2.7 printed hinges, annular pads, patch tile with strap slots,
    eyelets and die diamond fused to bundle A, strap tabs on every channel
    slot, edge binding with short ticks on the forearm rim. Pause at layer
    2 + tulle + magnets per the artifact workflow.
2026-10-15 Export v6: full splint on 0.4 printed membrane - the no-tulle variant
    Tulle is in delivery; printing v5's islands bare would shed 61 loose
    pieces mid-print. v6 fuses the same elements to a 0.4 membrane of the
    same 68D: one print, no pause, no magnets. Channel slots, patch strap
    slots, eyelets and pad centres pierce the membrane; mirror and
    respacing carried over from v5.
2026-10-17 Pod PCB walkthrough: say which side to solder on every part step
    Each fit step now shows a banner with a side-view sketch: part or wire
    in from the front (white outlines), solder on the back ("CLOWN POD
    rev A"). The XIAO step says to solder both ends of the pins. The rule
    is also stated up front and in the through-hole how-to.
2026-10-17 Pod PCB walkthrough: draw the back of the board beside the front
    On every part step and back-of-board inspection, a second drawing shows
    the board turned over like a page, with this step's joints pulsing and
    finished joints shown as solder cones, so it's clear where the iron
    goes after flipping.
2026-10-17 Pod PCB walkthrough: show legs splayed, soldered, then snipped
    Each part step gets three side-view frames of what the legs should look
    like on the back, tailored to the part: splay ~30 deg for axial parts,
    straight for Q1 and U2, header pins snipped flush, wires poked through.
    The back-of-board view draws the splayed legs bending outward.
2026-10-17 Pod PCB walkthrough: add a U1 wiring diagram
    The MT3608 step now draws each board pad wired to its module hole, in
    the wire colours the step specifies, with the module shown parts-side
    up as it looks on the bench, plus strip / twist / tin frames for
    preparing the stranded wire.
2026-10-18 Pod PCB walkthrough: picture how to trace a low first-power reading
    When J3 shows millivolts instead of the cell, the First power step now
    walks back along cell -> J1 -> SW1 -> F1 -> J3-1 with a to-scale crop of
    the board for each probe pair, the expected reading, and what a wrong
    reading points to (tripped cell protection, open switch, cold joint).
2026-10-18 Pod PCB walkthrough: diagram the boost trim
    The Trim the boost step now shows which screw on the MT3608 to turn,
    counter-clockwise to drop below 5 V then clockwise to creep up to 5.00,
    the meter readings to expect at each stage, and a crop of the J2 pads
    the probes stay on.
2026-10-19 Pod PCB walkthrough: picture the bench-test hookup
    The last step now draws the prong half of the J3 lead wired to the kit
    blower (motor red to blue, black to red), CR1 across the motor joins
    with its band on the motor-red side, the trigger switch on green and
    black, and each join taped on its own.
2026-10-19 Pod PCB walkthrough: show how to fit CR1 to the motor joins
    Six frames under the bench hookup: twist the pairs, hold the diode band
    up, wrap each leg round its twist, solder from below, snip, and tape
    each join on its own. Notes that twist-and-tape is enough for a first
    bench test.
2026-10-19 Start PROGRESS.md: arm 1 pod board finished, bench test next
    Records what the pod PCB walkthrough left behind (final readings, the
    connector colour maps, which way this MT3608 trims, which sketch is on
    the XIAO) and the open checks to clear before the bench test.
2026-10-21 PROGRESS: arm 1 XIAO had unknown firmware; reflashed motor_test, record its MAC
2026-10-21 Gun front housing: two Velcro slots with a bar, so the strap can wrap round
    One slot at 12:00/6:00 gave the strap nothing to hold. Each half now has two
    13 x 2.5 slots with a 4 mm bar between them.
2026-10-21 Export v7 wrap band: full-round-the-wrist test closed with velcro through slot pairs
    Tests a band that forms all the way round the wrist before committing to the
    splint shape. v6 membrane construction, no tulle, 120 x 40.
2026-10-28 Add v1 finger trigger ring: microswitch saddle on the palm side, 50 and 65 mm test bores
    The bubble trigger moves to the base of the middle finger, so curling the finger
    folds the palm onto the switch lever. This is a first fit and actuation test.
2026-10-28 Finger trigger ring v2: drop the switch stop, split the band, 65 mm only
    The switch may change, so nothing is sized to its body but the pilots. A 1 mm
    split on the back lets the band fit other hands. v1 moves to the archive.
2026-10-28 Finger trigger ring v3: round the split and bore edges, through screw holes
    Sharp edges at the gap and on the finger side pinch. Through holes print
    without bridging; an M2x10 tip still stops about 1 mm short of the finger.
    v2 moves to the archive.
2026-10-29 Finger trigger ring v4: nine sizes 45-65 mm, full and short switch plates
    Bracket the production hands without measuring them, and try a plate that
    reaches half as far past the screw holes. v3 moves to the archive; v4 c65
    full is the same geometry.
2026-10-30 Pod housing v1: sealed TPU box for the board, cell, boost module and plugs
    The pod needs one sealed box with the cell inside. Printing it in TPU makes the
    gaskets part of the print: a lid skirt with radial interference plus a wall-top
    bead, a bead ring under the rocker bezel, and JST's own SMP panel cutouts so J2
    and J3 snap into the wall after the board is screwed down. Also a wall coupon
    with every opening, to test the fits first, and a USB-C plug.
    Claude-Session: https://claude.ai/code/session_01W3pRT7i1RnCsrvKACrmC2L
2026-10-30 Pod housing v2: smooth snap lid, rocker on top, strap loops, shorter box
    The external screw ears were ugly. The lid now snaps on with a TPU bead and groove
    and seals with its skirt, so nothing on the outside but the rocker, the ports
    and four loops for 12 mm Velcro straps. The rocker moves into the lid. Its ~30 mm
    depth sets the box height, and that height leaves room to lift the MT3608 onto a
    deck over the XIAO, which cuts 12 mm off the length. The cell bay is sized to
    the measured 18.5 x 69 cell. A small snap coupon tests the lid and rocker fit
    before the full print. v1 moves to the archive, never printed.
    Claude-Session: https://cla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
2026-10-30 Pod housing v3: rocker out the back over the XIAO, plugs together, straps over the top
    v2 misread the brief. The straps go over the lid, in two channels, so the base
    loops are gone. The rocker points out of the back end with its body lying over
    the XIAO, which leaves its wires room to turn, and J2/J3 sit side by side in the
    front wall. USB-C needs no opening: the case is there to protect the board.
    Clearing the XIAO sets the height, and the MT3608 deck moves onto the cell to
    keep the box short: 82.7 x 57.6 x 42.3. v2 moves to the archive, never printed.
    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
2026-10-30 Pod housing: record seal-not-drain and module beside the cell as decided
    darknetdoll chose a sealed pod with no drain or breather, and is fine with the
    MT3608 sharing the cell compartment on its deck. Both override BUILD step 11 for
    this housing, so they move from Open to Decided.
    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
2026-10-30 Pod housing v4: resize v3 to the measured switch, module and XIAO
    darknetdoll measured the parts with calipers. The MT3608 is 36.8 long and only
    7.9 tall, on a 0.95 board, so its deck pocket grows and the snap lips drop. Its
    trimpot screw stands 1.1 past the long edge, so the deck rails get a gap there,
    at both ends, and the module goes in either way round. The rocker's clips span
    23, so the back wall is thinned out to 26 at the sides, and the clips go at the
    sides. The XIAO's socket stands 1.6 proud, so the back wall moves back 0.1. Same
    layout, 82.8 x 57.6 x 42.4. v3 moves to the archive, never printed.
    Claude-Session: https://claude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
2026-10-30 Pod housing v5: PETG box with TPU seals, screwed lid, plugs out through grommets
    The v4 coupons showed an all-TPU box leaves the circuit boards carrying the load,
    the rocker stretched the TPU hole for good, and the pod's J2 is the male SM-3,
    whose latch release would end up inside the box if panel-mounted.
    - Bottom and lid in PETG; TPU only for the gasket, washers, grommets and deck
    - Lid on 4 x M3x8 into heat-set inserts in hanging bosses, heads flush over TPU
    washers, seated on PETG hard stops
    - TPU lip gasket in a wall-top groove, squashed 0.6 by a lid pocket: 95A is too
    stiff to squeeze as a cord with four screws
    - J2 and J3 leave on their leads through split TPU grommets at darknet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
2026-10-30 Pod housing v6: self-tapping M3 lid screws straight into PETG, no inserts
    darknetdoll is using self-tapping M3s (6/8/10/12 on hand), not heat-set inserts.
    - Bosses take M3x8 pan heads in 2.6 x 9.0 pilots: 6.4 of thread engaged, and
    room for an M3x10 to cut fresh thread if a boss wears
    - Lid 4.0 (was 3.4) so the taller pan heads sit flush in 6.6 x 2.9 counterbores
    over 6.4 TPU washers; box 82.8 x 57.6 x 42.2
    - v5 archived, never printed
    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
2026-10-30 Pod housing: step-by-step tests for the v6 seal tray and wall coupon
    Replaces the short checklist with the order to test in, what a pass looks
    like, and what to record, now the v6 coupons are printed.
    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
2026-10-30 Pod housing v7: looser grommets with a slot for the wires
    darknetdoll, after the v6 coupons: everything fitted except the grommets,
    which were too tight in the PETG, with too small a hole for the wires.
    - Grommets 0.5 smaller where they meet the PETG: necks 0.1 a side inside
    the opening (v6: 0.15 over)
    - Round bores become slots twice as long across, along the split, so the
    wires lie side by side: J2 5.0 x 2.5, J3 6.0 x 3.0
    - PETG parts, gasket and washers unchanged; v6 archived, coupons printed
    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
2026-10-30 Pod housing v8: deck prints flat, without pads; log the v7 grommets
    v7's deck stood on the two pads that pressed the cell, so its plate printed
    5.5 off the bed with nothing under it. The pads are gone: the plate is 0.5
    thicker, downward, and its flat underside presses the cell 0.2. Its top,
    the module and the lid don't move; the wall and divider hold it sideways.
    The v7 grommets fit. Their slot runs across the short side, where
    darknetdoll meant the long side, but it stays. Every other v8 file is
    identical to v7's.
    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
2026-10-30 Pod housing v9: grommet wire slots run up the long side
    darknetdoll, after the v7 grommets: they fit, but the slot was meant to run
    along each opening's long side, not across the short one. J2's slot is now
    2.5 wide and 5.0 up, J3's 3.0 wide and 6.0 up, across the split. Every
    other file is identical to v8's.
    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
2026-10-30 Pod housing: board goes in XIAO end to the rocker wall; flashing needs it out
    The USB-C socket faces the back wall from 0.5 away, under the rocker, so a
    plug can't reach it with the board in. 'Flash it with the lid off' was wrong.
    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
2026-10-31 Pulse the blower at 5 Hz, 50% duty while the trigger is held, so the bursts of speed form bubbles properly
    Each 100 ms on-phase restarts with the kickstart, since the blower coasts down
    during the off-phase. Applied to both clown_arm and motor_test; motor_test
    reflashed to arm 1 for testing.
2026-10-31 PROGRESS: finish the 5 Hz pulse note (left half-written)
2026-10-31 Make the trigger comet a drifting rainbow instead of purple
    Hue sweeps the wheel along the strip and drifts over time (RAINBOW_DRIFT_MS).
    Idle glow and release flare stay THEME_HUE. Both sketches; motor_test
    reflashed to arm 1.
2026-11-01 Add vsense_probe: read the cell off VSENSE when there's no meter
    Battery stopped powering arm 1 after U1 was moved; the probe reads 0.00 V
    at the board, so log that and that the XIAO needs motor_test reflashed.
2026-11-01 PROGRESS: battery dropout traced to an intermittent J1, not U1
2026-11-01 PROGRESS: J1 holds under wiggle; XIAO back on motor_test
2026-11-01 PROGRESS: motor_test bench run on battery works, trigger clean
